mikenemat/skeeball-premium-re/hardware/docs/records/stock_passives/crops/02_ldo_U1_C6_C10.jpg

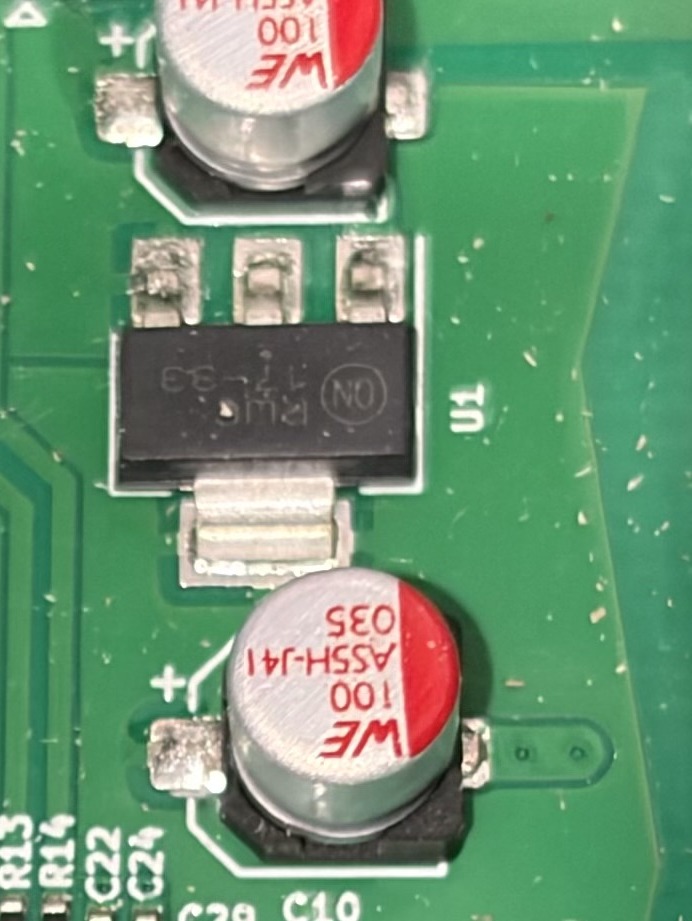
hardware/docs/records/stock_passives/crops/02_ldo_U1_C6_C10.jpg
