mikenemat/skeeball-premium-re/hardware/fab/release-2026-10-27c/README.md

# SBC-1 release package - 2026-10-27c (NOT ORDERED)

Supersedes release-2026-10-27b. **One change: D2 (FAULT red) = Hubei KENTO KT-0603R, LCSC C2286 (JLC basic)**, replacing
NationStar NCD0603R1 C84263, which JLC's assembly review flagged as Standard-PCBA-only ("limits in package (0201),
temperature ...") while this order is Economic PCBA. Same 0603 footprint, same nets; copper, silk and placement are
unchanged: every gerber / drill file is identical to release-b apart from its creation-date lines (diffed). The CPL
differs only in D2's Mid (0.0001 mm, C2286's origin), the BOM only in D2's line.

Board: `hardware/main/skeeball-controller.kicad_pcb` = q6 with D2's MPN / maker / LCSC / note fields updated (sha256
prefix 13729afbc822dc86 at the release export - re-check with `sha256sum`), 116.68 x 85.73 mm, 4 layers, **216
footprints** (208 JLC placements + H1-H4 + FID1-FID4). DRC (refilled zones + schematic parity): 0 errors, 0 unconnected
(the 43 warnings are the q6 set: library-copy and value-label parity notes). ERC 0, netlist compare 0.
`python scripts/bom.py check`: PASS (76 lines, 0 fail). Generated by
`python scripts/fab_release.py <board> fab/release-2026-10-27c` (gerbers / drills: kicad-cli; CPL: din-relay-8ch method).

| File | Use on jlcpcb.com |
|---|---|
| `sbc1-gerbers-drills-2026-10-27.zip` | "Add gerber file": F.Cu / In1.Cu / In2.Cu / B.Cu, mask, paste, silk, Edge.Cuts, PTH + NPTH Excellon (mm), drill maps, Gerber job file (records the JLC04161H-7628 stack) |
| `sbc1-jlc-bom.csv` | Assembly BOM (Comment, Designator, Footprint, LCSC Part #) |
| `sbc1-jlc-cpl.csv` | Assembly CPL (Designator, Mid X, Mid Y, Layer, Rotation), top side, **rotations corrected for JLC's LCSC footprints** |
| `sbc1-cpl-qa.txt` | One line per placement: LCSC footprint, KiCad orientation + fitted offset = CPL rotation, Mid shift, pad overlay result (pad number / function checked), polarity mark |
| `gerbers/` | the same files unzipped (for a viewer check) |

## Order settings

| Setting | Value |
|---|---|
| Base material / layers | FR-4, **4 layers** |
| Dimensions | 116.68 x 85.73 mm (from the outline) |
| PCB qty | 5 |
| Product type | Industrial / consumer (default) |
| Different design | 1 |
| Delivery format | **Single PCB** (no panel, no V-cut). See "Edge clearance" below: if JLC asks for rails, answer "assemble as a single board" - **order-time item for the owner** |
| PCB thickness | **1.6 mm** |
| Impedance control / layer stackup | **JLC04161H-7628** (1 oz outer = 35 um, 0.5 oz inner = 17.5 um; 7628 prepreg 0.2104 mm, core 1.065 mm) |
| PCB color | **Green** |
| Silkscreen | White |
| Surface finish | **ENIG** |
| Outer copper weight | 1 oz |
| Inner copper weight | 0.5 oz |
| Via covering | **Plugged** - the owner's live quote (2026-10-27) shows Tented greyed out for this build; no epoxy fill / capping (DECISIONS #9). Per JLC's via-covering page, holes in pads and vias closer than 0.35 mm to a pad are NOT ink-plugged: the EP thermal vias of U5 / U1 / U8 stay open (their paste is windowed between them), and many near-pad vias stay open too - expect an engineering question and accept it |
| Min via hole / diameter | 0.3 / 0.6 mm |
| Tooling holes | **Added by Customer** (the 4 corner holes H1-H4 + fiducials are in the files) |
| Remove order number | **Remove mark** (selected on the owner's quote; JLC may charge for it). No placeholder text is on the silk |
| PCB Assembly | **Yes, Economic PCBA**, assemble **Top side**, qty 5 |
| Tooling holes (PCBA) | Added by Customer |
| Confirm Parts Placement | **Yes** |
| Confirm Production File | **Yes** |

Order remark (paste into the PCBA remark field):
> J10 (C22464480, HRO TYPE-C-31-D-15) and J21-J28 (C588833, Molex 95503-2441) have no LCSC footprint: the CPL gives the
> body centre and rotation 0 - please confirm all 9 in the placement preview. J10's 4 shell legs go through the board
> (plated slots, 2 of them shared with the locating pegs): please solder them. Assemble as a single board (parts sit
> within 2.5 mm of the edges by design).
> D2 (C2286 KT-0603R): the LCSC library polarity dot marks the ANODE (pad 1, KENTO '+'); our cathode is the pad at the
> silk cathode bracket. Please confirm in placement preview.

## Placement notes for the JLC review

- **CPL rotations**: JLC places the LCSC / EasyEDA footprint of each C-number, rotated counter-clockwise by the CPL
  rotation about its origin. Every row was fitted and then overlaid exactly as JLC transforms it (`sbc1-cpl-qa.txt`):
  **199 PASS, 0 FAIL, 9 CONFIRM**. The check requires the SAME pad (its number, or for shells / mounting / tactile
  pairs a pad of the same net). Diode polarity is checked by pin NAMES: the LCSC symbol's anode pad must land on our
  anode net and its cathode pad on our cathode net (our A / K from the schematic netlist); the polarity dot is reported
  per D line, and decides only where the LCSC pins carry no A / K names (D1 SMBJ5.0A: dot on our cathode pad 1).
  `scripts/test_fab_polarity.py` shows the check FAILs a reversed diode (CPL + 180, board A / K swapped, LCSC names
  swapped) for C2286, C12624, C84268 and C83333.
- **LEDs**: D2 (red) = Hubei KENTO KT-0603R C2286 (basic), D4 (yellow) = NationStar NCD0603Y1 C84268, D3 / D5 (green) =
  KENTO KT-0603G C12624. All pass by pin names. **D2's LCSC dot marks the ANODE**: C2286's LCSC pad 1 is named A (KENTO's
  drawing: pad 1 = '+') and carries the layer-101 dot; CPL rotation 0 puts LCSC pad 1 (A) on our pad 2 (LED_FAULT_A,
  x 104.79) and LCSC pad 2 (K) on our pad 1 (PWR_FAULT_N, x 103.21, the end with the silk cathode bracket). So in JLC's
  preview D2's dot sits on the end AWAY from our silk bracket - correct for this part (order remark above). For C84268
  and C12624 the dot marks the cathode and lands on our pad 1 (bracket end).
  D2 changed from NationStar NCD0603R1 C84263 (release-b) because JLC offers that part for Standard PCBA only.
- **J10 (HRO TYPE-C-31-D-15, C22464480)**: no LCSC footprint exists (EasyEDA API 404), so the footprint is drawn from
  HRO's 2023-10-27 drawing (`datasheets/dl/j10/C22464480.pdf`), rotated so the A row (A1 left) faces the board's top
  edge like the part it replaced. Its 4 shell legs (2.20 mm) pass through the 1.6 mm board in plated slots; at the two
  diagonal corners the slot also takes the dia 0.70 locating peg (the drawing leaves only a 0.135 mm web between slot
  and peg hole, which no copper ring survives).
- **J21-J28 (C588833)**: no LCSC footprint; CPL Mid = the jack body (courtyard) centre, not the KiCad origin on the
  peg line; plug opening toward the board's bottom edge (the stock orientation).
- **J9 (micro-B)**: its shell slots carry paste from the overlapping SMD shell pads (pin-in-paste, as drawn by
  Amphenol / KiCad) - keep it.
- THT connectors (J1, J4, J5, J6, J7, J8, J21-J28; the J9 / J10 shells) are JLC-placed too (one order = the full
  board).

## Edge clearance (order-time item)

JLC's assembly terms ask for component bodies >= 2.5 mm from the edge. On this board the harness connectors sit at the
stock positions (fixed by the cabinet harness) and overhang or touch the edges: J1 / J4 / J8 / J9 overhang the top /
right / left edges, J6 / J7 / J21-J28 are within 0.6 mm, SW1 / SW2 1.35 mm. Standard edge rails would be blocked by the
overhangs. If JLC asks for rails or a fixture, answer by asking them to assemble it as a single board.

## Not in this package

No order has been placed. No owner decisions are open: O1 and O2 accepted, O3 closed (DECISIONS #20-#22). The package
is ready to order.
