mikenemat/skeeball-premium-re/software/RESUME.md

# Working on the public tools

Read AGENTS.md and README.md. Check the current Git diff before making changes.
Keep task-specific handoffs and local workspace details out of public documents.
