mikenemat/skeeball-premium-re/hardware/docs/records/stock_passives/crops/01_flash_bootsel_R5_R11_C7.jpg

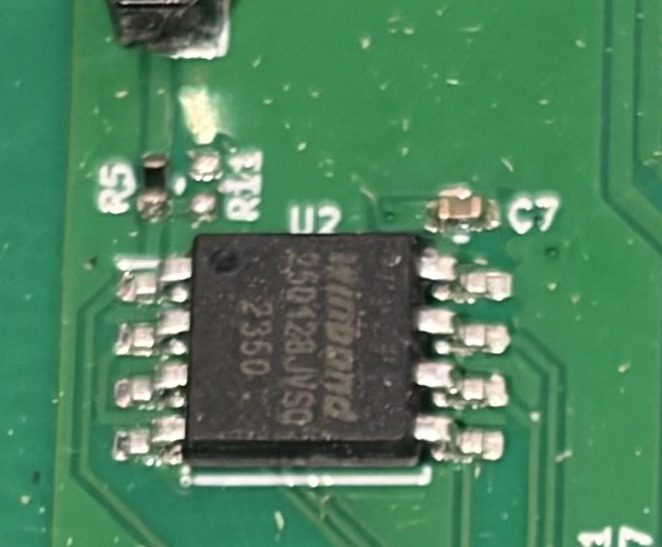
hardware/docs/records/stock_passives/crops/01_flash_bootsel_R5_R11_C7.jpg
