mikenemat/skeeball-premium-re/hardware/docs/records/stock_passives/crops/03_mcu_top_C21-C30_R13_R14.jpg

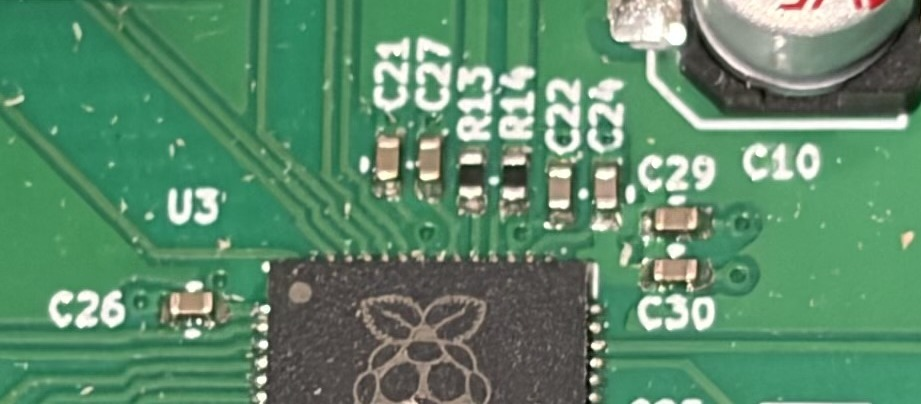
hardware/docs/records/stock_passives/crops/03_mcu_top_C21-C30_R13_R14.jpg
