mikenemat/skeeball-premium-re/hardware/docs/records/stock_passives/crops/04_mcu_bottom_R12_C28_C20_R10_C1_C5.jpg

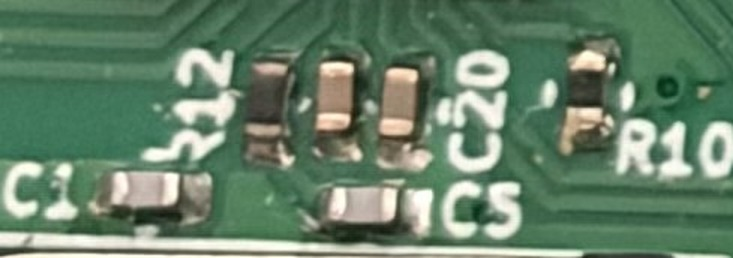
hardware/docs/records/stock_passives/crops/04_mcu_bottom_R12_C28_C20_R10_C1_C5.jpg
