mikenemat/skeeball-premium-re/hardware/docs/records/stock_passives/crops/05_status_D2_R15_C25.jpg

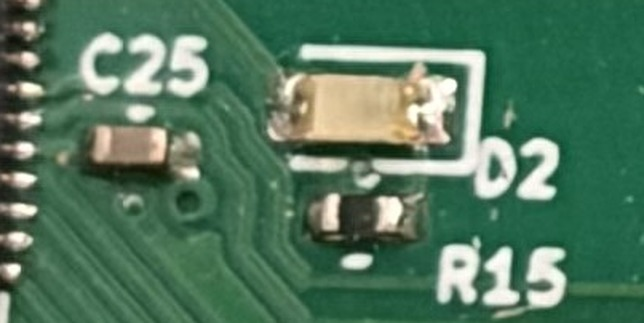
hardware/docs/records/stock_passives/crops/05_status_D2_R15_C25.jpg
