mikenemat/skeeball-premium-re/hardware/docs/records/stock_passives/crops/06_audio_input_R16-R19_C33-C35.jpg

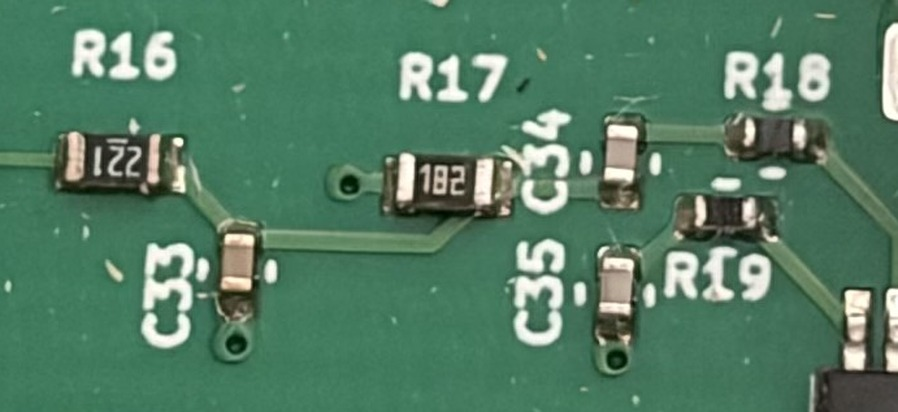
hardware/docs/records/stock_passives/crops/06_audio_input_R16-R19_C33-C35.jpg
