mikenemat/skeeball-premium-re/hardware/docs/records/stock_passives/crops/07_R16_marking.jpg

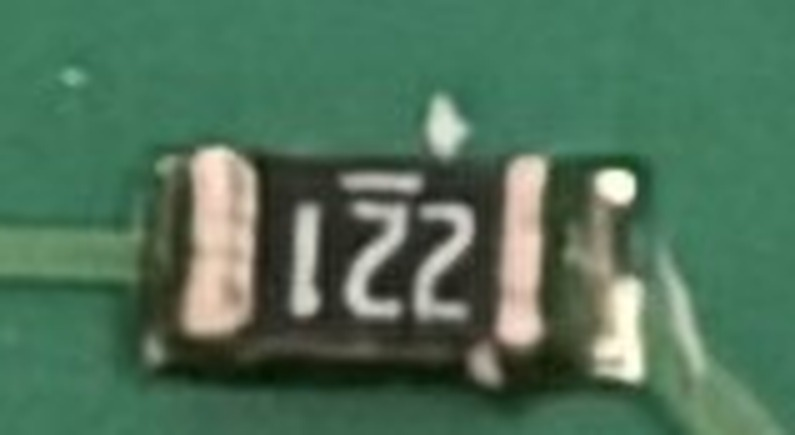
hardware/docs/records/stock_passives/crops/07_R16_marking.jpg
