mikenemat/skeeball-premium-re/hardware/docs/records/stock_passives/crops/08_audio_amp_U4_R20_C32_FB_C36_C37.jpg

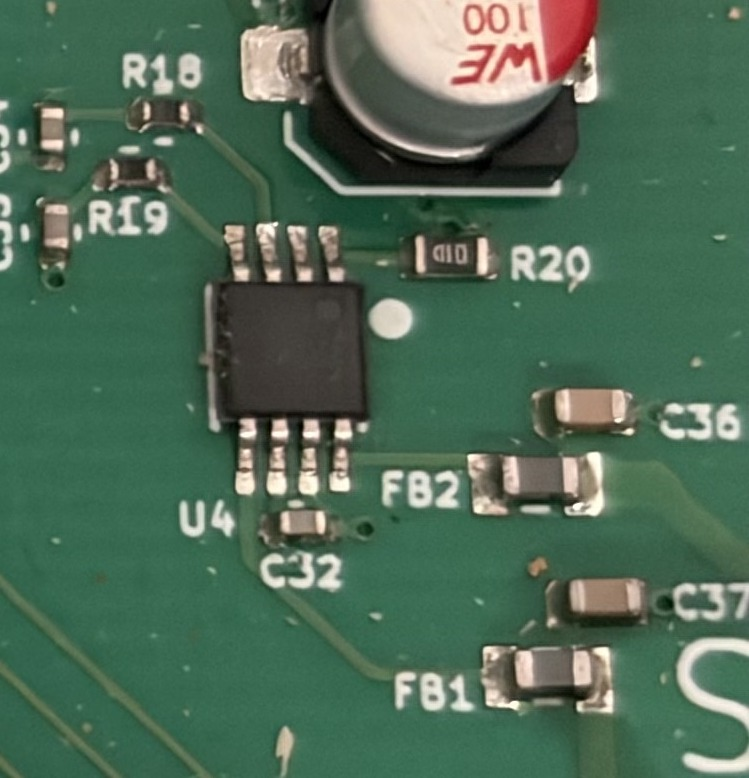
hardware/docs/records/stock_passives/crops/08_audio_amp_U4_R20_C32_FB_C36_C37.jpg
