mikenemat/skeeball-premium-re/hardware/docs/records/stock_passives/crops/09_light_fets_R1-R9.jpg

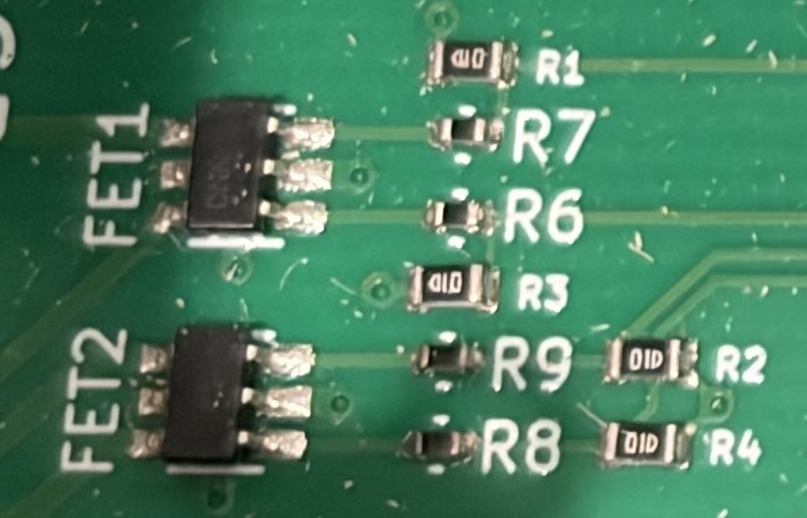
hardware/docs/records/stock_passives/crops/09_light_fets_R1-R9.jpg
