mikenemat/skeeball-premium-re/hardware/docs/records/stock_passives/crops/10_button_caps_C2_C8_C15_C19.jpg

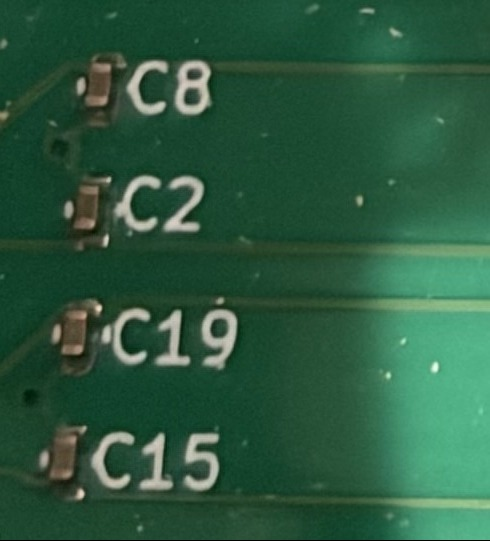
hardware/docs/records/stock_passives/crops/10_button_caps_C2_C8_C15_C19.jpg
