mikenemat/skeeball-premium-re/hardware/docs/records/stock_passives/crops/11_score_caps_J11.jpg

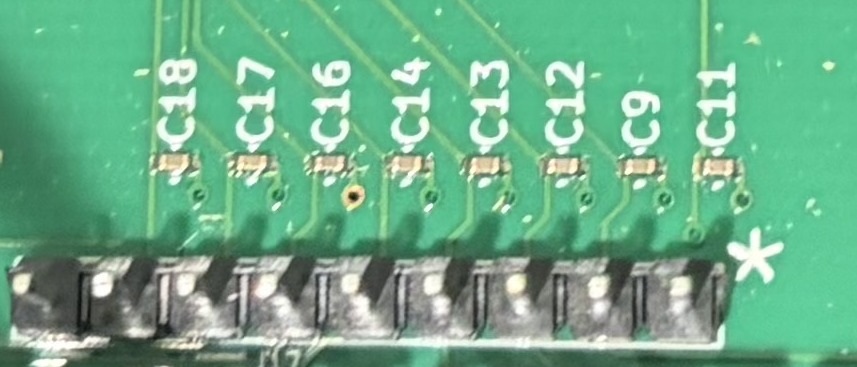
hardware/docs/records/stock_passives/crops/11_score_caps_J11.jpg
