mikenemat/skeeball-premium-re/hardware/docs/records/stock_passives/crops/12_jbutton_caps_C38-C42.jpg

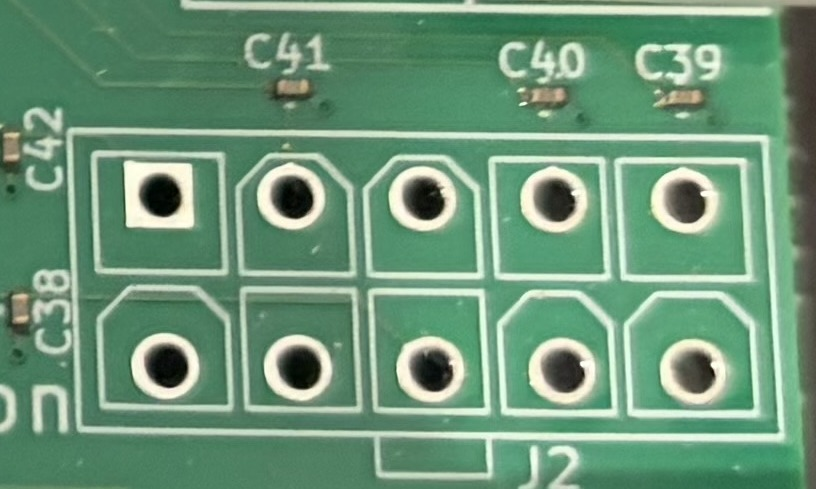
hardware/docs/records/stock_passives/crops/12_jbutton_caps_C38-C42.jpg
