mikenemat/skeeball-premium-re/hardware/docs/records/stock_passives/crops/13_J18_C6.jpg

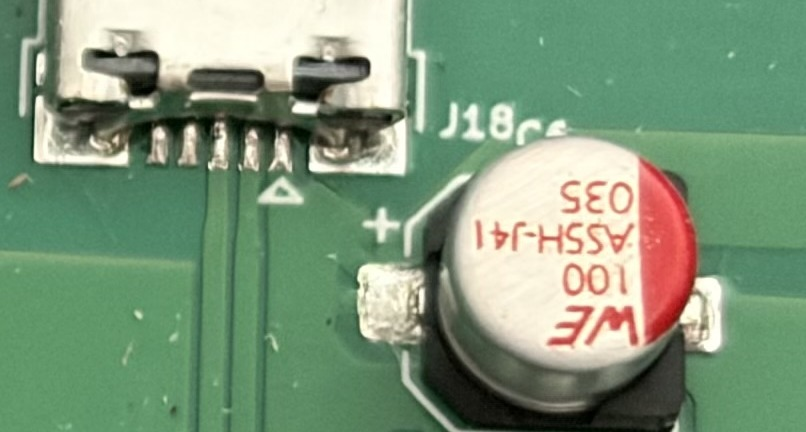
hardware/docs/records/stock_passives/crops/13_J18_C6.jpg
