mikenemat/skeeball-premium-re/hardware/docs/records/stock_passives/crops/14_C31_label.jpg

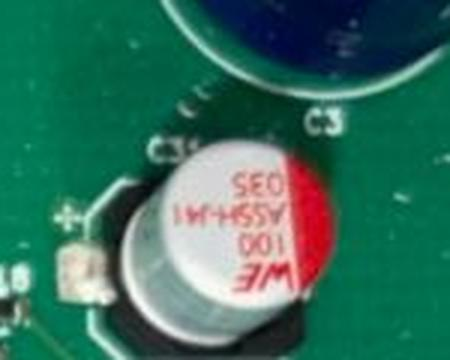
hardware/docs/records/stock_passives/crops/14_C31_label.jpg
