mikenemat/skeeball-premium-re/hardware/docs/records/stock_passives/crops/15_power_c3_c4.jpg

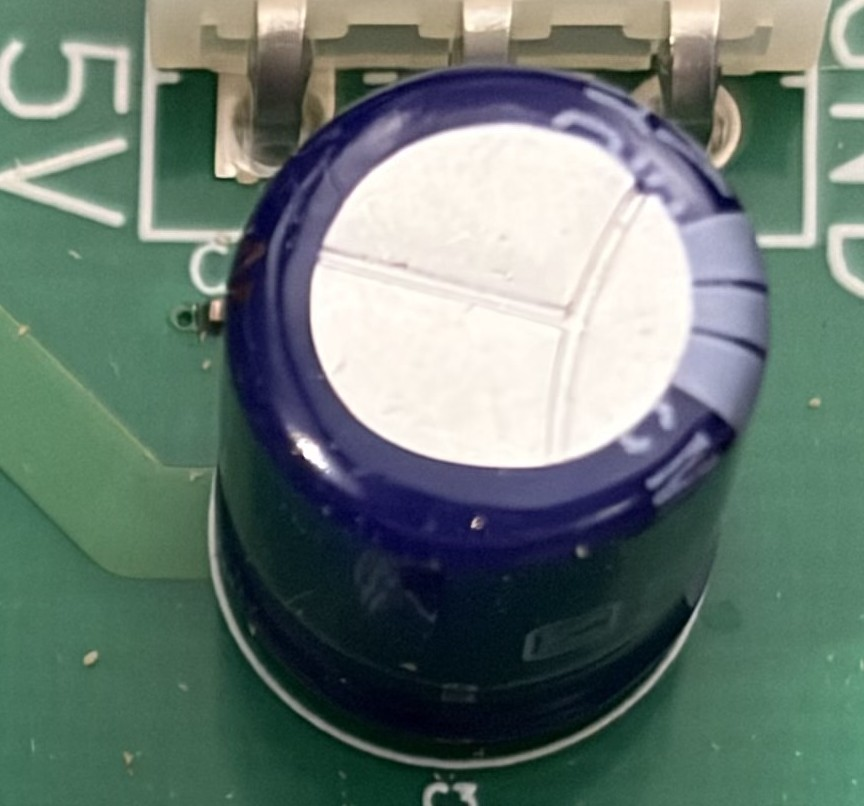
hardware/docs/records/stock_passives/crops/15_power_c3_c4.jpg
