mikenemat/skeeball-premium-re/hardware/renders/footprints/contact_sheet.png

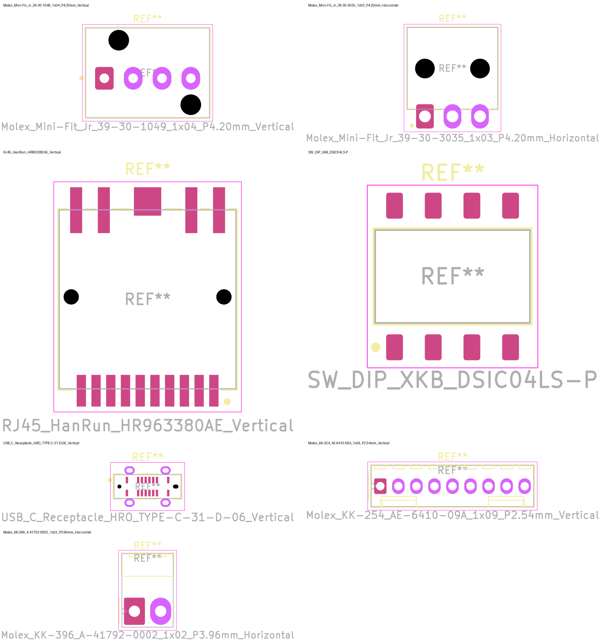
hardware/renders/footprints/contact_sheet.png
