mikenemat/skeeball-premium-re/hardware/renders/footprints/Molex_KK-254_AE-6410-09A_1x09_P2.54mm_Vertical.png

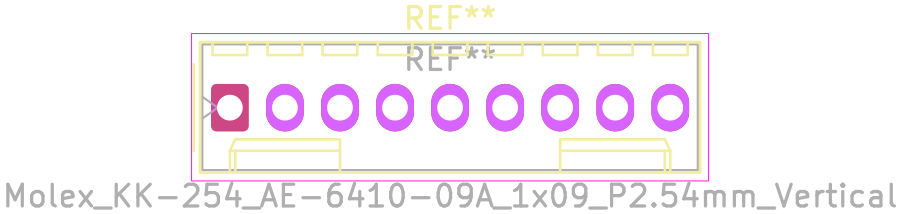
hardware/renders/footprints/Molex_KK-254_AE-6410-09A_1x09_P2.54mm_Vertical.png
