mikenemat/skeeball-premium-re/hardware/renders/footprints/Molex_KK-396_A-41792-0002_1x02_P3.96mm_Horizontal.png

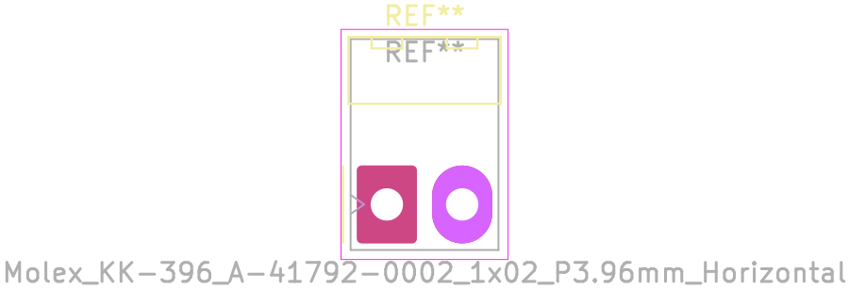
hardware/renders/footprints/Molex_KK-396_A-41792-0002_1x02_P3.96mm_Horizontal.png
