mikenemat/skeeball-premium-re/hardware/renders/footprints/Molex_Mini-Fit_Jr_39-30-1049_1x04_P4.20mm_Vertical.png

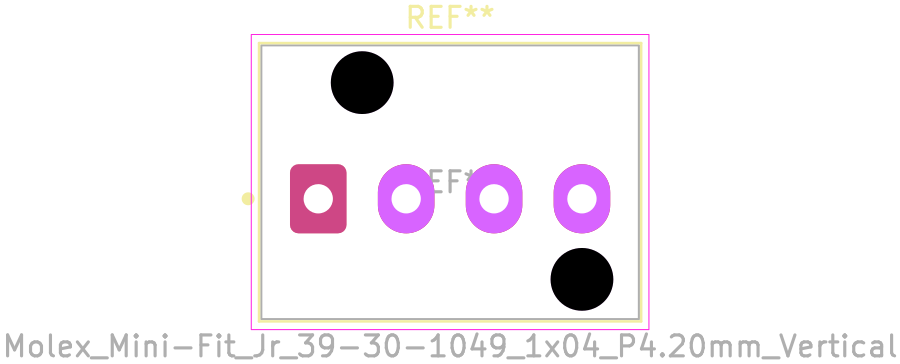
hardware/renders/footprints/Molex_Mini-Fit_Jr_39-30-1049_1x04_P4.20mm_Vertical.png
