mikenemat/skeeball-premium-re/hardware/renders/footprints/Molex_Mini-Fit_Jr_39-30-3035_1x03_P4.20mm_Horizontal.png

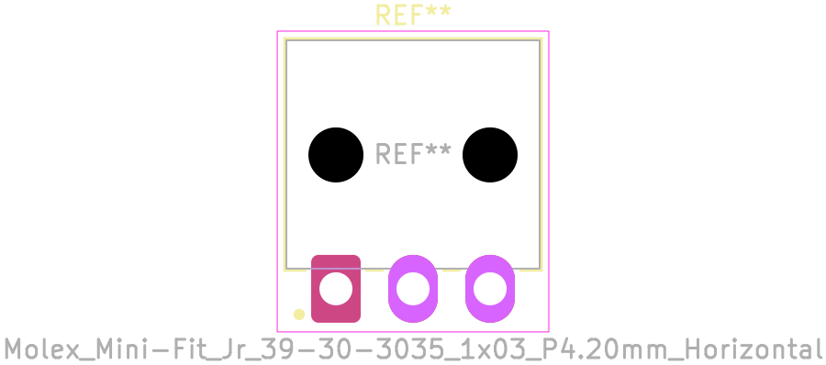
hardware/renders/footprints/Molex_Mini-Fit_Jr_39-30-3035_1x03_P4.20mm_Horizontal.png
