mikenemat/skeeball-premium-re/hardware/renders/footprints/RJ45_HanRun_HR963380AE_Vertical.png

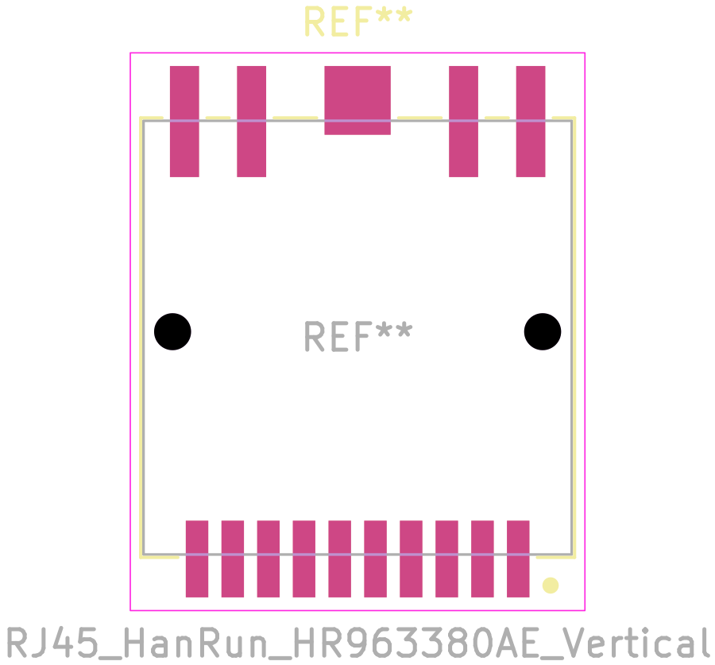
hardware/renders/footprints/RJ45_HanRun_HR963380AE_Vertical.png
