mikenemat/skeeball-premium-re/hardware/renders/footprints/SW_DIP_XKB_DSIC04LS-P.png

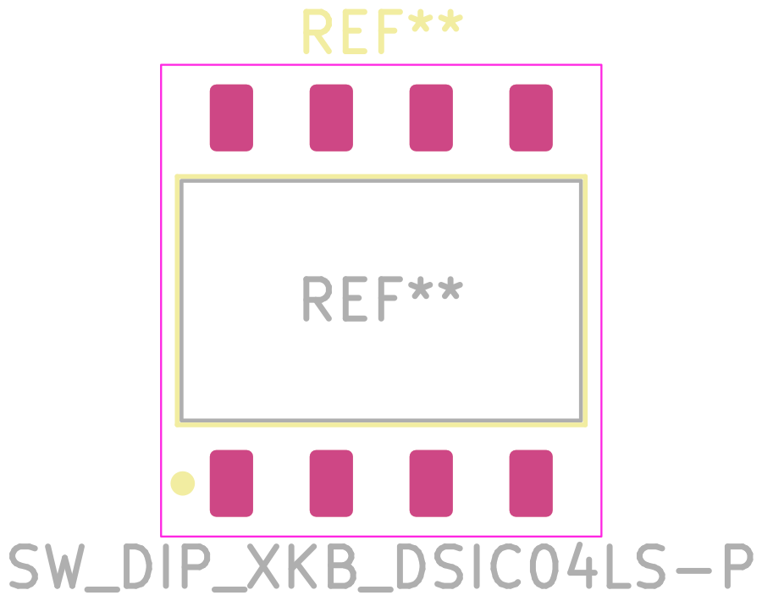
hardware/renders/footprints/SW_DIP_XKB_DSIC04LS-P.png
