mikenemat/skeeball-premium-re/hardware/renders/footprints/USB_C_Receptacle_HRO_TYPE-C-31-D-06_Vertical.png

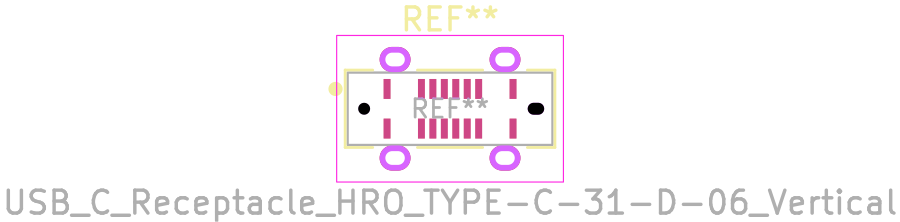
hardware/renders/footprints/USB_C_Receptacle_HRO_TYPE-C-31-D-06_Vertical.png
