mikenemat/skeeball-premium-re/hardware/renders/pcb/final-2026-10-27b/sbc1-final-layer-F_Cu.png

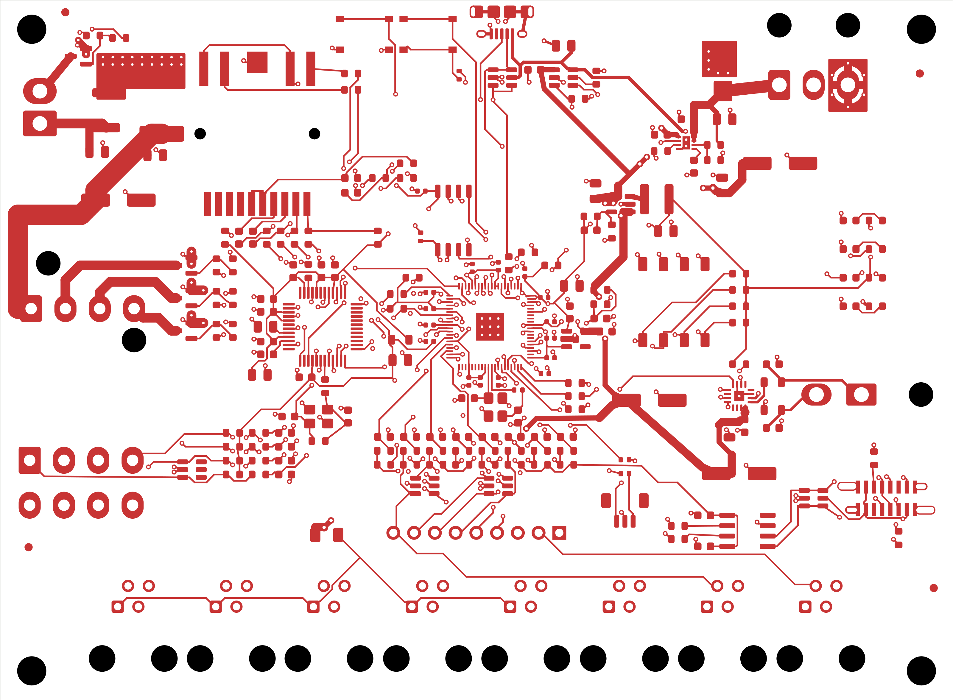
hardware/renders/pcb/final-2026-10-27b/sbc1-final-layer-F_Cu.png
