mikenemat/skeeball-premium-re/hardware/renders/pcb/final-2026-10-27b/sbc1-final-side-left-edge.png

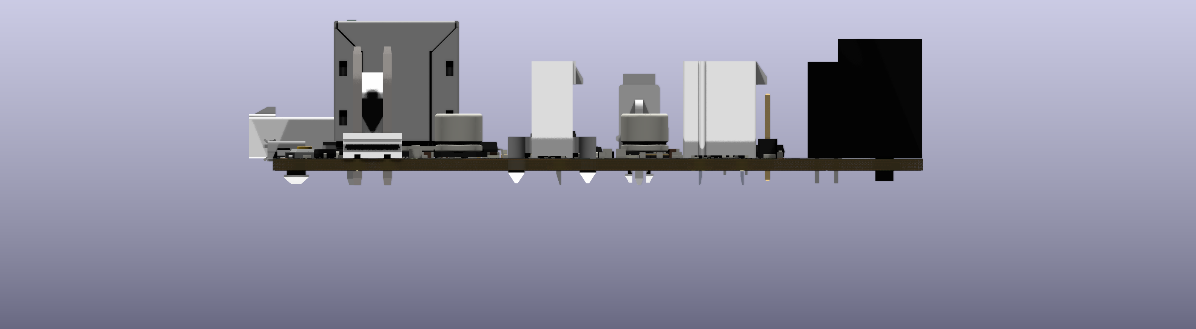
hardware/renders/pcb/final-2026-10-27b/sbc1-final-side-left-edge.png
