mikenemat/skeeball-premium-re/hardware/renders/placement/placement_plan.png

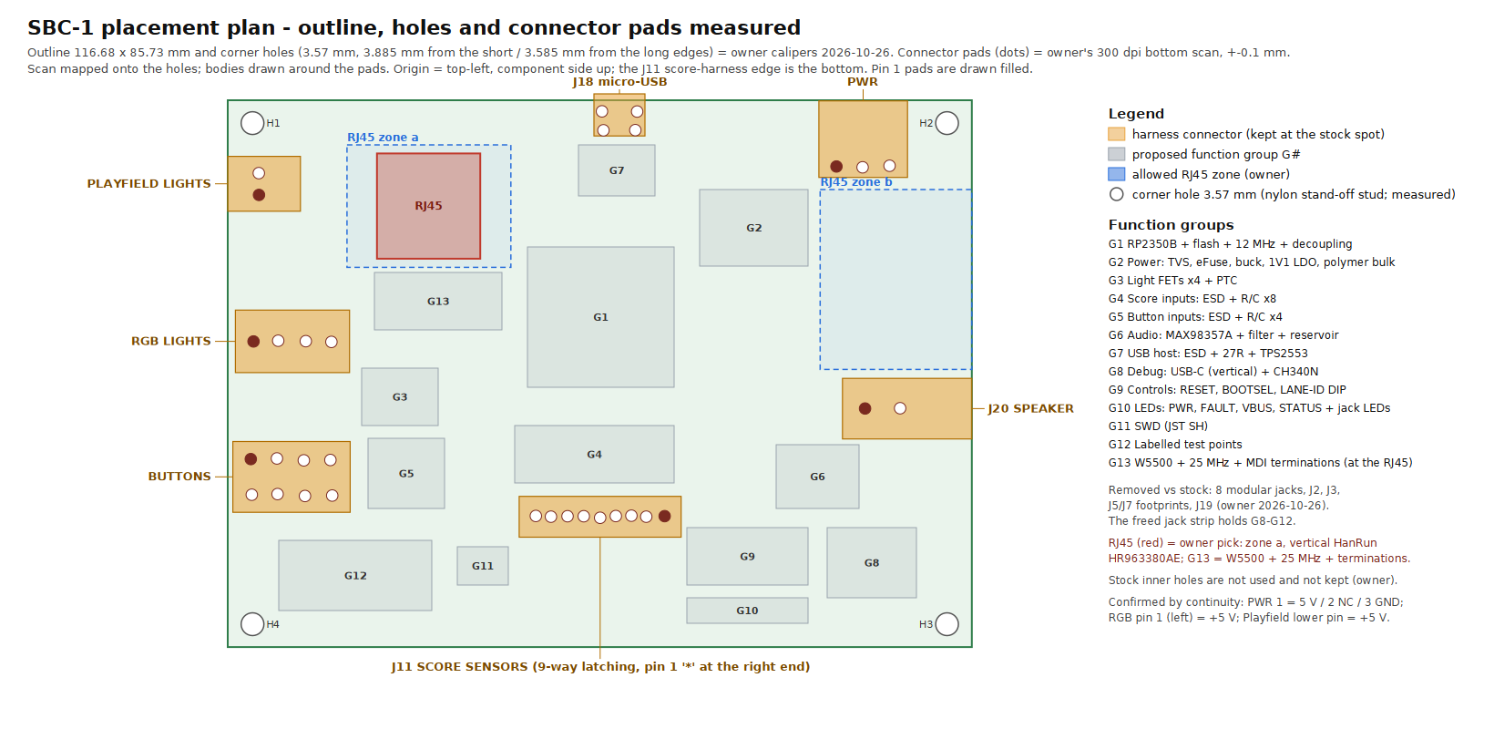
hardware/renders/placement/placement_plan.png
