mikenemat/skeeball-premium-re/hardware/renders/placement/rj45_zone_study.png

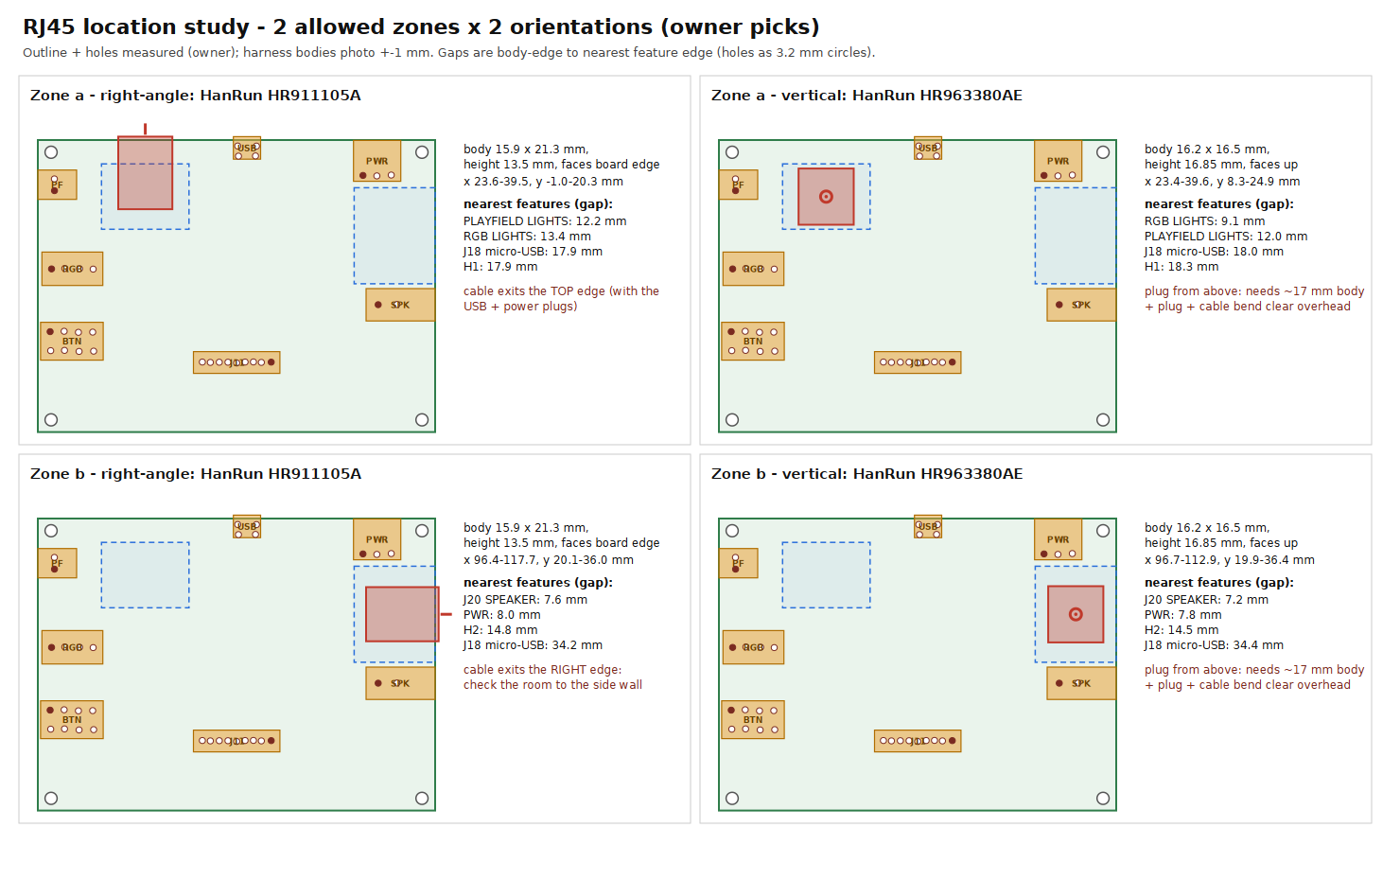
hardware/renders/placement/rj45_zone_study.png
