mikenemat/skeeball-premium-re/hardware/docs/ORDERING.md

# ORDERING - generated by `python scripts/bom.py report` (do not edit)

Data: bom/bom.json updated 2026-10-27T20:24:26Z (JLC parts-library API = live part-page data).
Run: 5 boards (4 machines + 1 spare).

## Cost per board (parts at the JLC assembly price for the run quantity)

| Item | USD / board |
|---|---:|
| Placed parts (all non-harness lines) | 19.95 |
| Harness connectors (genuine Molex at the stock-board locations) | 11.22 |
| JLC extended-part fees: 34 lines x $3 / order, spread over 5 boards | 20.40 |
| **Parts total (one JLC order = the full board)** | **51.57** |

PCB + assembly service (2-layer 1.6 mm, ~109 x 85 mm, 5 pcs, single-sided assembly) is quoted at order time on jlcpcb.com; not included above.

The JLC assembly order covers every line below (SMT + the through-hole harness headers); nothing is owner-fitted.

## Lines

| Refs | Qty/board | Value | MPN | Maker | LCSC | JLC library | JLC stock | Unit USD (JLC) | Checked (UTC) | Status | Notes |
|---|---|---|---|---|---|---|---|---|---|---|---|
| C47, C51 | 2 | 10nF | 0603B103K500NT | FH | C57112 | basic | 5972499 | 0.0047 | 2026-10-27 | OK |  |
| C52, C53 | 2 | 6.8nF | 0603B682K500NT | FH | C1631 | basic | 364930 | 0.0055 | 2026-10-27 | OK |  |
| C4, C9, C15, C17, C37, C38, C39, C40, C41, C42, C45, C55, C72, C73 | 14 | 100nF | CC0603KRX7R9BB104 | YAGEO | C14663 | basic | 42860043 | 0.0149 | 2026-10-27 | OK |  |
| C31, C32 | 2 | 4.7uF | CL05A475MP5NRNC | Samsung | C23733 | basic | 2606160 | 0.0153 | 2026-10-27 | OK |  |
| C18, C19, C20, C21, C22, C23, C24, C25, C26, C27, C28, C29, C30, C34 | 14 | 100nF | CL05B104KO5NNNC | Samsung | C1525 | basic | 34906725 | 0.0035 | 2026-10-27 | OK |  |
| C13, C14 | 2 | 1uF | CL10A105KB8NNNC | Samsung | C15849 | basic | 13334380 | 0.0146 | 2026-10-27 | OK |  |
| C58, C59, C60, C61, C62, C63, C64, C65, C66, C67, C68, C69, C70, C71 | 14 | 1nF | CL10B102KB8NNNC | Samsung | C1588 | basic | 5502112 | 0.0098 | 2026-10-27 | OK |  |
| C50 | 1 | 22nF | CL10B223KB8NNNC | Samsung | C21122 | basic | 1077610 | 0.0057 | 2026-10-27 | OK |  |
| C6 | 1 | 47nF | CL10B473KB8NNNC | Samsung | C1622 | basic | 974968 | 0.0077 | 2026-10-27 | OK |  |
| C12, C35, C36 | 3 | 15pF C0G | CL10C150JB8NNNC | Samsung | C1644 | basic | 1119169 | 0.0111 | 2026-10-27 | OK |  |
| C48, C49 | 2 | 18pF C0G | CL10C180JB8NNNC | Samsung | C1647 | basic | 271473 | 0.0158 | 2026-10-27 | OK |  |
| C2, C3, C5, C11, C33, C43, C44, C54 | 8 | 10uF | CL21A106KAYNNNE | Samsung | C15850 | basic | 8948721 | 0.0438 | 2026-10-27 | OK |  |
| C8, C16 | 2 | 22uF | CL21A226MAQNNNE | Samsung | C45783 | basic | 4118242 | 0.1917 | 2026-10-27 | OK |  |
| C10, C46 | 2 | 4.7uF | CL21A475KAQNNNE | Samsung | C1779 | basic | 1980619 | 0.0343 | 2026-10-27 | OK |  |
| C1, C7, C56, C57 | 4 | 220uF polymer | OVZ221M1ATR-0606 | Lelon | C311623 | extended | 15012 | 0.2063 | 2026-10-27 | OK |  |
| D3, D5 | 2 | PWR green | KT-0603G | Hubei KENTO | C12624 | extended | 443493 | 0.0117 | 2026-10-27 | OK |  |
| D2 | 1 | FAULT red | KT-0603R | Hubei KENTO | C2286 | basic | 7642560 | 0.0077 | 2026-10-27 | OK |  |
| D4 | 1 | VBUS yellow | NCD0603Y1 | NationStar | C84268 | extended | 306447 | 0.0112 | 2026-10-27 | OK |  |
| D1 | 1 | SMBJ5.0A | SMBJ5.0A | Littelfuse | C83333 | extended | 37387 | 0.1156 | 2026-10-27 | OK |  |
| F2 | 1 | 3A hold | 1812L300MR | Littelfuse | C127824 | extended | 3798 | 0.1366 | 2026-10-27 | OK |  |
| F1 | 1 | 5A hold | 2920L500/16MR | Littelfuse | C207091 | extended | 2614 | 0.3788 | 2026-10-27 | OK |  |
| FB2, FB3 | 2 | BLM21PG221SN1D | BLM21PG221SN1D | Murata | C85840 | extended | 591700 | 0.0346 | 2026-10-27 | OK |  |
| FB1 | 1 | 600R@100MHz | GZ2012D601TF | Sunlord | C1017 | basic | 577061 | 0.02 | 2026-10-27 | OK |  |
| F3 | 1 | 0.5A hold | MF-NSMF050-2 | Bourns | C75464 | extended | 72093 | 0.0591 | 2026-10-27 | OK |  |
| J9 | 1 | DISPLAY USB | 10118194-0001LF | Amphenol ICC | C132563 | extended | 41020 | 0.2585 | 2026-10-27 | OK | harness |
| J8 | 1 | PLAYFIELD LIGHTS | 26604020 | Molex | C505042 | extended | 24726 | 0.1605 | 2026-10-27 | OK | harness |
| J6 | 1 | BUTTONS | 39281083 | Molex | C293503 | extended | 4243 | 0.402 | 2026-10-27 | OK | harness |
| J4 | 1 | SPEAKER | 39300020 | Molex | C240831 | extended | 298 | 0.604 | 2026-10-27 | OK | harness |
| J7 | 1 | RGB LIGHTS | 39301049 | Molex | C587488 | extended | 4042 | 0.3192 | 2026-10-27 | OK | harness |
| J1 | 1 | PWR 5V/GND | 39303035 | Molex | C505179 | extended | 11634 | 0.5369 | 2026-10-27 | OK | harness |
| J21, J22, J23, J24, J25, J26, J27, J28 | 8 | SCORE 0 | 955032441 | Molex | C588833 | extended | 649 | 1.1114 | 2026-10-27 | OK | harness |
| J2 | 1 | SWD | BM03B-SRSS-TB(LF)(SN) | JST | C160389 | extended | 27324 | 0.2762 | 2026-10-27 | OK |  |
| J5 | 1 | SCORE SENSORS | HC-PZ254-11.5L-1x9PZ | Hong Cheng | C27985193 | extended | 2390 | 0.0433 | 2026-10-27 | OK | harness |
| J3 | 1 | HR963380AE | HR963380AE | HanRun | C19724763 | extended | 154 | 2.7252 | 2026-10-27 | OK |  |
| J10 | 1 | DEBUG USB-C | TYPE-C-31-D-15 | Korean Hroparts | C22464480 | extended | 469 | 0.6531 | 2026-10-27 | OK |  |
| L1 | 1 | 2.2uH | SWPA4030S2R2MT | Sunlord | C36409 | extended | 34358 | 0.0583 | 2026-10-27 | OK |  |
| Q1, Q2, Q3, Q4 | 4 | AO3416 | AO3416 | Alpha & Omega | C43307 | extended | 48177 | 0.1091 | 2026-10-27 | OK |  |
| R15, R16 | 2 | 100 | 0402WGF1000TCE | UNI-ROYAL | C25076 | basic | 7105177 | 0.0012 | 2026-10-27 | OK |  |
| R12, R13, R14 | 3 | 1k | 0402WGF1001TCE | UNI-ROYAL | C11702 | basic | 19064680 | 0.0013 | 2026-10-27 | OK |  |
| R25, R27, R28, R29, R30 | 5 | 0 | 0603WAF0000T5E | UNI-ROYAL | C21189 | basic | 22071302 | 0.0022 | 2026-10-27 | OK |  |
| R66, R68, R70, R72, R78, R79 | 6 | 100 | 0603WAF1000T5E | UNI-ROYAL | C22775 | basic | 10427539 | 0.0023 | 2026-10-27 | OK |  |
| R4, R10 | 2 | 1k | 0603WAF1001T5E | UNI-ROYAL | C21190 | basic | 34230068 | 0.0017 | 2026-10-27 | OK |  |
| R18, R19, R20, R21, R23, R81, R82 | 7 | 10k | 0603WAF1002T5E | UNI-ROYAL | C25804 | basic | 38841065 | 0.0017 | 2026-10-27 | OK |  |
| R1, R5, R8 | 3 | 100k | 0603WAF1003T5E | UNI-ROYAL | C25803 | basic | 17660400 | 0.0031 | 2026-10-27 | OK |  |
| R26 | 1 | 1M | 0603WAF1004T5E | UNI-ROYAL | C22935 | basic | 5584345 | 0.0018 | 2026-10-27 | OK |  |
| R33 | 1 | 10 | 0603WAF100JT5E | UNI-ROYAL | C22859 | basic | 6801213 | 0.0032 | 2026-10-27 | OK |  |
| R22 | 1 | 12.4k | 0603WAF1242T5E | UNI-ROYAL | C22865 | extended | 183987 | 0.0015 | 2026-10-27 | OK |  |
| R11 | 1 | 1.5k | 0603WAF1501T5E | UNI-ROYAL | C22843 | basic | 3838230 | 0.002 | 2026-10-27 | OK |  |
| R42, R44, R46, R48, R50, R52, R54, R56, R58, R60, R62, R64 | 12 | 2.2k | 0603WAF2201T5E | UNI-ROYAL | C4190 | basic | 5955416 | 0.0018 | 2026-10-27 | OK |  |
| R6 | 1 | 22k | 0603WAF2202T5E | UNI-ROYAL | C31850 | basic | 3147116 | 0.0042 | 2026-10-27 | OK |  |
| R74, R75 | 2 | 27 | 0603WAF270JT5E | UNI-ROYAL | C25190 | preferred | 407953 | 0.0016 | 2026-10-27 | OK |  |
| R36, R37 | 2 | 330 | 0603WAF3300T5E | UNI-ROYAL | C23138 | basic | 3725238 | 0.002 | 2026-10-27 | OK |  |
| R24, R39, R40, R41 | 4 | 33 | 0603WAF330JT5E | UNI-ROYAL | C23140 | basic | 4510286 | 0.0024 | 2026-10-27 | OK |  |
| R17 | 1 | 470 | 0603WAF4700T5E | UNI-ROYAL | C23179 | basic | 4990526 | 0.0023 | 2026-10-27 | OK |  |
| R43, R45, R47, R49, R51, R53, R55, R57, R59, R61, R63, R65, R67, R69, R71, R73, R80 | 17 | 4.7k | 0603WAF4701T5E | UNI-ROYAL | C23162 | basic | 16608030 | 0.0028 | 2026-10-27 | OK |  |
| R2, R9 | 2 | 47k | 0603WAF4702T5E | UNI-ROYAL | C25819 | basic | 3388230 | 0.0035 | 2026-10-27 | OK |  |
| R7 | 1 | 49.9k | 0603WAF4992T5E | UNI-ROYAL | C23184 | basic | 1592716 | 0.0029 | 2026-10-27 | OK |  |
| R31, R32, R34, R35 | 4 | 49.9 | 0603WAF499JT5E | UNI-ROYAL | C23185 | basic | 1633061 | 0.0021 | 2026-10-27 | OK |  |
| R76, R77 | 2 | 5.1k | 0603WAF5101T5E | UNI-ROYAL | C23186 | basic | 21976225 | 0.0015 | 2026-10-27 | OK |  |
| R38 | 1 | 510k | 0603WAF5103T5E | UNI-ROYAL | C23192 | basic | 950956 | 0.002 | 2026-10-27 | OK |  |
| R3 | 1 | 680 | 0603WAF6800T5E | UNI-ROYAL | C23228 | basic | 1992590 | 0.0021 | 2026-10-27 | OK |  |
| SW3 | 1 | LANE ID | DSIC04LS-P | XKB Connection | C319038 | extended | 6316 | 0.6367 | 2026-10-27 | OK |  |
| SW1, SW2 | 2 | BOOTSEL | TS-1187A-B-A-B | XKB Connection | C318884 | basic | 1187372 | 0.0207 | 2026-10-27 | OK |  |
| U14 | 1 | CH340N | CH340N | WCH | C2977777 | extended | 24904 | 0.5909 | 2026-10-27 | OK |  |
| U9, U10, U11 | 3 | ESDA6V1-5SC6 | ESDA6V1-5SC6 | STMicroelectronics | C6650 | extended | 2981 | 0.2115 | 2026-10-27 | OK |  |
| U8 | 1 | MAX98357AETE+T | MAX98357AETE+T | Analog Devices | C910544 | extended | 33473 | 1.3242 | 2026-10-27 | OK |  |
| U5 | 1 | RP2350B | RP2350B | Raspberry Pi | C42415655 | extended | 3477 | 1.2833 | 2026-10-27 | OK |  |
| U2 | 1 | TLV62569DBVR | TLV62569DBVR | Texas Instruments | C141836 | extended | 432314 | 0.0708 | 2026-10-27 | OK |  |
| U3 | 1 | TLV74311PDBVR | TLV74311PDBVR | Texas Instruments | C485147 | extended | 10298 | 0.0935 | 2026-10-27 | OK |  |
| U4 | 1 | TPS2553DBVR | TPS2553DBVR | Texas Instruments | C55266 | extended | 49261 | 0.5418 | 2026-10-27 | OK |  |
| U1 | 1 | TPS259531DSGR | TPS259531DSGR | Texas Instruments | C2155674 | extended | 2161 | 0.8773 | 2026-10-27 | OK |  |
| U12, U13 | 2 | USBLC6-2SC6 | USBLC6-2SC6 | STMicroelectronics | C7519 | extended | 37197 | 0.1797 | 2026-10-27 | OK |  |
| U6 | 1 | W25Q128JVSIQ | W25Q128JVSIQ | Winbond | C97521 | basic | 58346 | 2.5828 | 2026-10-27 | OK |  |
| U7 | 1 | W5500 | W5500 | WIZnet | C32843 | extended | 23251 | 2.83 | 2026-10-27 | OK |  |
| Y1 | 1 | 12MHz | ABM8-272-T3 | Abracon | C20625731 | extended | 2735 | 0.658 | 2026-10-27 | OK |  |
| Y2 | 1 | 25MHz | X322525MOB4SI | YXC | C9006 | basic | 240479 | 0.0951 | 2026-10-27 | OK |  |

Status: OK = JLC stock >= 2 x (run need + attrition) and >= 100; THIN = enough for this run but below that margin; TBD = harness part waiting for the owner's connector identification.

## Basic-library swaps (cost pass, owner 2026-10-26)

JLC charges the extended-part fee per unique extended line and order; 'preferred' extended parts are listed by JLC as fee-exempt (re-check on the quote screen). Lines swapped, with the reason it is a drop-in:

| Line | Was | Now | Why a drop-in |
|---|---|---|---|
| FB1 W5500 3V3A bead | Murata BLM18PG221SN1D 220 R 0603 (extended) | Sunlord GZ2012D601TF 600 R 0805 (basic, C1017) | WIZnet note g: 100-2000 R at 100 MHz is adequate; 500 mA rating vs 132 mA load |
| R37 MAX98357A SD_MODE pull-up | 634 k 0603 (extended) | 510 k 0603WAF5103T5E (basic, C23192) | VSD_MODE 0.49-0.60 V: centred in the B0 max 0.355 V .. B1 typ 0.77 V (L+R)/2 window with the internal 100 k +-8 % (q6 2026-10-27; the cost pass's 680 k left 30 mV to B0 max) |
| R73 / R74 USB host 27 R | 0402WGF270JTCE (extended) | 0603WAF270JT5E (preferred, C25190) | same value; 0603 footprint instead of 0402 |

Extended lines kept, and why:

| Line(s) | Reason |
|---|---|
| OVZ221M1ATR-0606 220 uF polymer x4 | no polymer capacitor in the JLC basic library (owner: no aluminium electrolytics) |
| KT-0603G green LED x2 | no green 0603 LED in basic (red / yellow 0603 are); owner asked for 0603 |
| NCD0603Y1 yellow LED | chosen in the q6 pass (mfg review M1) over the basic KT-0603Y, whose LCSC dot marks the anode; kept because JLC's assembly review did not flag it (D2 red went back to the basic KT-0603R C2286 on 2026-10-27: NCD0603R1 is Standard-PCBA-only) |
| SMBJ5.0A TVS, 1812L300MR + 2920L500/16MR polyfuses, SWPA4030S2R2MT 2.2 uH | no basic-library equivalents found (TVS / PTC / 4x4 power inductor) |
| AO3416 light FETs x4 | replaced basic AO3400A (48 mOhm at 2.5 V gate, ~0.6 W at 3 A in SOT-23): the owner's strips draw up to ~3 A per channel; no basic FET is specified <= 26 mOhm at 2.5 V |
| BLM21PG221SN1D speaker beads x2 | basic beads are rated <= 800 mA; the speaker peaks at ~0.9 A rms |
| ESDA6V1-5SC6 x3, USBLC6-2SC6 x2 | no ESD arrays in the basic library |
| 0603WAF1242T5E 12.4 k | value specified by WIZnet (EXRES1 12.4 k 1 %); no basic / preferred listing |
| ABM8-272-T3 12 MHz | the crystal Raspberry Pi specifies for the RP2350 |
| ICs and connectors | not swapped (owner rule) |

Extended-part fees: 34 lines x $3 = $102 per order -> $20.40 / board at 5 boards.
