mikenemat/skeeball-premium-re/hardware/fab/release-2026-10-27c/sbc1-jlc-bom.csv

Comment | Designator | Footprint | LCSC Part #
10nF 0603B103K500NT | C47,C51 | C_0603_1608Metric | C57112
6.8nF 0603B682K500NT | C52,C53 | C_0603_1608Metric | C1631
100nF CC0603KRX7R9BB104 | C4,C9,C15,C17,C37,C38,C39,C40,C41,C42,C45,C55,C72,C73 | C_0603_1608Metric | C14663
4.7uF CL05A475MP5NRNC | C31,C32 | C_0402_1005Metric | C23733
100nF CL05B104KO5NNNC | C18,C19,C20,C21,C22,C23,C24,C25,C26,C27,C28,C29,C30,C34 | C_0402_1005Metric | C1525
1uF CL10A105KB8NNNC | C13,C14 | C_0603_1608Metric | C15849
1nF CL10B102KB8NNNC | C58,C59,C60,C61,C62,C63,C64,C65,C66,C67,C68,C69,C70,C71 | C_0603_1608Metric | C1588
22nF CL10B223KB8NNNC | C50 | C_0603_1608Metric | C21122
47nF CL10B473KB8NNNC | C6 | C_0603_1608Metric | C1622
15pF C0G CL10C150JB8NNNC | C12,C35,C36 | C_0603_1608Metric | C1644
18pF C0G CL10C180JB8NNNC | C48,C49 | C_0603_1608Metric | C1647
10uF CL21A106KAYNNNE | C2,C3,C5,C11,C33,C43,C44,C54 | C_0805_2012Metric | C15850
22uF CL21A226MAQNNNE | C8,C16 | C_0805_2012Metric | C45783
4.7uF CL21A475KAQNNNE | C10,C46 | C_0805_2012Metric | C1779
220uF polymer OVZ221M1ATR-0606 | C1,C7,C56,C57 | CP_Elec_6.3x5.9 | C311623
PWR green KT-0603G | D3,D5 | LED_0603_1608Metric | C12624
FAULT red KT-0603R | D2 | LED_0603_1608Metric | C2286
VBUS yellow NCD0603Y1 | D4 | LED_0603_1608Metric | C84268
SMBJ5.0A SMBJ5.0A | D1 | D_SMB | C83333
3A hold 1812L300MR | F2 | Fuse_1812_4532Metric | C127824
5A hold 2920L500/16MR | F1 | Fuse_2920_7451Metric | C207091
BLM21PG221SN1D BLM21PG221SN1D | FB2,FB3 | L_0805_2012Metric | C85840
600R@100MHz GZ2012D601TF | FB1 | L_0805_2012Metric | C1017
0.5A hold MF-NSMF050-2 | F3 | Fuse_1206_3216Metric | C75464
DISPLAY USB 10118194-0001LF | J9 | USB_Micro-B_Amphenol_10118194-0001LF_Horizontal | C132563
PLAYFIELD LIGHTS 26604020 | J8 | Molex_KK-396_A-41791-0002_1x02_P3.96mm_Vertical | C505042
BUTTONS 39281083 | J6 | Molex_Mini-Fit_Jr_5566-08A_2x04_P4.20mm_Vertical | C293503
SPEAKER 39300020 | J4 | Molex_Mini-Fit_Jr_5569-02A2_2x01_P4.20mm_Horizontal | C240831
RGB LIGHTS 39301049 | J7 | Molex_Mini-Fit_Jr_39-30-1049_1x04_P4.20mm_Vertical | C587488
PWR 5V/GND 39303035 | J1 | Molex_Mini-Fit_Jr_39-30-3035_1x03_P4.20mm_Horizontal | C505179
SCORE 0 955032441 | J21,J22,J23,J24,J25,J26,J27,J28 | RJ11_6P4C_TopEntry_StockPads | C588833
SWD BM03B-SRSS-TB(LF)(SN) | J2 | JST_SH_BM03B-SRSS-TB_1x03-1MP_P1.00mm_Vertical | C160389
SCORE SENSORS HC-PZ254-11.5L-1x9PZ | J5 | PinHeader_1x09_P2.54mm_Vertical | C27985193
HR963380AE HR963380AE | J3 | RJ45_HanRun_HR963380AE_Vertical | C19724763
DEBUG USB-C TYPE-C-31-D-15 | J10 | USB_C_Receptacle_HRO_TYPE-C-31-D-15_Vertical | C22464480
2.2uH SWPA4030S2R2MT | L1 | L_Sunlord_SWPA4030S | C36409
AO3416 AO3416 | Q1,Q2,Q3,Q4 | SOT-23 | C43307
100 0402WGF1000TCE | R15,R16 | R_0402_1005Metric | C25076
1k 0402WGF1001TCE | R12,R13,R14 | R_0402_1005Metric | C11702
0 0603WAF0000T5E | R25,R27,R28,R29,R30 | R_0603_1608Metric | C21189
100 0603WAF1000T5E | R66,R68,R70,R72,R78,R79 | R_0603_1608Metric | C22775
1k 0603WAF1001T5E | R4,R10 | R_0603_1608Metric | C21190
10k 0603WAF1002T5E | R18,R19,R20,R21,R23,R81,R82 | R_0603_1608Metric | C25804
100k 0603WAF1003T5E | R1,R5,R8 | R_0603_1608Metric | C25803
1M 0603WAF1004T5E | R26 | R_0603_1608Metric | C22935
10 0603WAF100JT5E | R33 | R_0603_1608Metric | C22859
12.4k 0603WAF1242T5E | R22 | R_0603_1608Metric | C22865
1.5k 0603WAF1501T5E | R11 | R_0603_1608Metric | C22843
2.2k 0603WAF2201T5E | R42,R44,R46,R48,R50,R52,R54,R56,R58,R60,R62,R64 | R_0603_1608Metric | C4190
22k 0603WAF2202T5E | R6 | R_0603_1608Metric | C31850
27 0603WAF270JT5E | R74,R75 | R_0603_1608Metric | C25190
330 0603WAF3300T5E | R36,R37 | R_0603_1608Metric | C23138
33 0603WAF330JT5E | R24,R39,R40,R41 | R_0603_1608Metric | C23140
470 0603WAF4700T5E | R17 | R_0603_1608Metric | C23179
4.7k 0603WAF4701T5E | R43,R45,R47,R49,R51,R53,R55,R57,R59,R61,R63,R65,R67,R69,R71,R73,R80 | R_0603_1608Metric | C23162
47k 0603WAF4702T5E | R2,R9 | R_0603_1608Metric | C25819
49.9k 0603WAF4992T5E | R7 | R_0603_1608Metric | C23184
49.9 0603WAF499JT5E | R31,R32,R34,R35 | R_0603_1608Metric | C23185
5.1k 0603WAF5101T5E | R76,R77 | R_0603_1608Metric | C23186
510k 0603WAF5103T5E | R38 | R_0603_1608Metric | C23192
680 0603WAF6800T5E | R3 | R_0603_1608Metric | C23228
LANE ID DSIC04LS-P | SW3 | SW_DIP_XKB_DSIC04LS-P | C319038
BOOTSEL TS-1187A-B-A-B | SW1,SW2 | SW_Push_1P1T_XKB_TS-1187A | C318884
CH340N CH340N | U14 | SOIC-8_3.9x4.9mm_P1.27mm | C2977777
ESDA6V1-5SC6 ESDA6V1-5SC6 | U9,U10,U11 | SOT-23-6 | C6650
MAX98357AETE+T MAX98357AETE+T | U8 | TQFN-16-1EP_3x3mm_P0.5mm_EP1.23x1.23mm | C910544
RP2350B RP2350B | U5 | QFN-80-1EP_10x10mm_P0.4mm_EP3.4x3.4mm | C42415655
TLV62569DBVR TLV62569DBVR | U2 | SOT-23-5 | C141836
TLV74311PDBVR TLV74311PDBVR | U3 | SOT-23-5 | C485147
TPS2553DBVR TPS2553DBVR | U4 | SOT-23-6 | C55266
TPS259531DSGR TPS259531DSGR | U1 | Texas_DSG0008A_WSON-8-1EP_2x2mm_P0.5mm_EP0.9x1.6mm | C2155674
USBLC6-2SC6 USBLC6-2SC6 | U12,U13 | SOT-23-6 | C7519
W25Q128JVSIQ W25Q128JVSIQ | U6 | SOIC-8_5.3x5.3mm_P1.27mm | C97521
W5500 W5500 | U7 | LQFP-48_7x7mm_P0.5mm | C32843
12MHz ABM8-272-T3 | Y1 | Crystal_SMD_3225-4Pin_3.2x2.5mm | C20625731
25MHz X322525MOB4SI | Y2 | Crystal_SMD_3225-4Pin_3.2x2.5mm | C9006
