mikenemat/skeeball-premium-re/hardware/docs/QA_LOG.md

# QA_LOG

## Gate table
| Gate | Script | Result (2026-10-26) |
|---|---|---|
| Design structural check | `python scripts/design.py` | 234 parts, 178 nets, 0 issues |
| KiCad ERC (all severities) | `python scripts/build_schematics.py` | 8 messages, **0 electrical** (8 = footprint_link_issues for the 8 pending project footprints) |
| Netlist == design | same | **0 problems** |
| Footprints resolve | `python scripts/qa_footprints.py` | 0 missing, 8 pending (listed with reasons) |
| BOM stock / buyable | `python scripts/bom.py check` | 73 lines, **0 fail**; HR963380AE 154 flagged thin in ARCHITECTURE 5.5 / 7; 6 harness lines provisional / TBD |
| Drawing QA | rasterized PNGs read back | schematic pages + 2 placement renders inspected, defects fixed (Q-6) |

## Findings
| ID | Finding | Status |
|---|---|---|
| Q-1-20261026 | ERC: power-output pins collided with PWR_FLAGs (+5V_SYS, +1V1, +5V_SENS, VBUS_HOST); open-drain FAULT / FLT pins typed 'output' clashed; stock USB_B_Micro marks VBUS / GND as power outputs; stock MAX98357A EP 'unspecified' | **FIXED**: flags only on undriven rails; FLT / FAULT typed open_collector; project symbols USB_B_Micro_Host + MAX98357A_TQFN (pins per the maker pin tables); ERC 0 electrical |
| Q-2-20261026 | Generator placed corner-pin labels by position (RP2350A GPIO0-3 / 26-29, connector end pins stacked) and the stock R / FB / TP / switch / small-IC fields over bodies and labels | **FIXED** in `gen_schematic.py`: label direction from the pin's own rotation; per-symbol field rules; slot width includes the value text; A2 sheets for > 50 units |
| Q-3-20261026 | CH340C (C84681) listed by JLC as 'no longer manufactured / not buyable'; other CH340C listing stock 21 | **FIXED**: CH340N (C2977777, 24,904, buyable), same datasheet |
| Q-4-20261026 | Abracon AOTA-B201610S3R3 (the RP2350 Minimal design's only specified VREG inductor) JLC stock 1 | **FIXED**: external 1.1 V DVDD (TLV74311P) per RP2350 DS Figure 24 (documented deviation) |
| Q-5-20261026 | RP2350A stepping on the JLC reel not stated; A2 erratum E9 | **ACCEPTED**: no circuit relies on internal pull-downs; external pull-ups on every input (ARCHITECTURE 7) |
| Q-6-20261026 | Placement render: legend clipped, J11 leader through G10, H1 label on the Playfield box, G2 / G6 overlapping zone b / J20; RJ45 study: arrow through the title, text clipped | **FIXED**, re-rendered and re-read |
| Q-7-20261026 | Owner rule 'checked on the live part page' | **DONE**: all lines via the JLC parts-library API (part-page backend), timestamped; 3 rendered-page spot checks equal (RP2350A 5,711 / $1.2947; TPS259531DSGR 2,161 / $0.8773; ABM8-272-T3 2,730 / $0.6580) |
| Q-8-20261026 | CL10B682KB8NNNC (6.8 nF) JLC stock 2 | **FIXED**: FH 0603B682K500NT (C1631, basic) |
| Q-9-20261026 | 30 extended lines = $90 feeder fees per order | **BOUNDED**: passives moved to JLC basic where a same-or-better basic part exists (fb divider 100k/22k + 15 pF, UVLO 39k); the rest are ICs / connectors with no basic option |
| Q-10-20261026 | First photo estimate (angled image4, linear scale) read the outline as ~115.7 x 85.1 mm | **SUPERSEDED** by the straight photo + plane homography: ~108.7 x 84.6 mm, corner holes 3.2 mm in from both edges (self-consistent at all four corners); J11 pitch sets the scale, the RP2040 width cross-check reads 5 % larger (recorded in estimate.json) |
| Q-11-20261026 | Buttons header assumed 2x3 (brief) | **FIXED**: the straight photo shows 2 x 4 cavities (8 pins); Conn_02x04, provisional Molex 39281083 (C293503); pin map on the owner list |
| Q-12-20261026 | Speaker assumed BOSS BRS52B (2022 manual) | **FIXED**: owner photo = Stetron DB20-009 / AACE8811A, 4 Ohm nominal, rating unverified; 9 dB gain + firmware volume cap (ARCHITECTURE 5.8 / 5.12) |
| Q-13-20261026 | Root schematic sheet boxes showed no names; long sheet titles overflowed the title block; CH340N / TLV62569 reference text touched the body | **FIXED** in the generator (Sheetname / Sheetfile kept visible, titles <= 45 chars, field rules); pages re-rendered and read |
| Q-14-20261026 | RP2350A ran out of GPIO (DECISIONS #1 pushed W5500 RSTn / INTn and the fault flag into hardware) | **FIXED**: RP2350B (C42415655, 3,477 in stock, $1.2833, live page checked 2026-10-26); design per Figure 16 / Appendix B; RSTn / INTn / FAULT / 5 V monitor back on GPIO; 4 spare GPIO test pads; ERC 0 electrical, netlist == design |
| Q-15-20261026 | J11 was a bare-pin header; the owner's plug is a 9-way latching housing (KK 254 / XH style) | **FIXED**: shrouded friction-lock vertical header; Molex 22-27-2091 / 22-05-3091 are not at JLC, so CJT A2541WV-9P (C225484, 2.54 mm, 4,348) is fitted with JST B9B-XH-A (C157966, 2.5 mm, 10,929) as the alternate; pitch goes on the owner list, both footprints to be drawn |
| Q-16-20261026 | RJ45 zone / orientation open | **CLOSED (owner)**: zone a, vertical HanRun HR963380AE; W5500 group G13 placed under it; HR911105A dropped from the BOM (fallback flag only). Stock 154 (re-checked live 2026-10-26): no second vertical magjack at JLC; backup = XUNPU RJ45-408-050-11 + Pulse HX1188NL transformer (layout change) |
| Q-17-20261026 | 28 extended lines = $16.80 / board at 5 boards | **FIXED / BOUNDED**: cost pass - FB1 -> Sunlord GZ2012D601TF (basic), R37 634k -> 680k (preferred), USB 27 R 0402 -> 0603 (preferred): 25 extended lines, $15.00 / board at 5, $3.75 at 20. Kept-extended lines and reasons in ORDERING.md; no basic equivalents exist for polymer caps, green 0603 LED, TVS, PTC, 4x4 inductor, 2 A beads, ESD arrays |
| Q-18-20261026 | Photo estimate read the outline as 108.7 mm long; the owner measured **116.68 mm** (100 % sure). Cause: the homography scale was taken from the J11 pin span read as 2.54 mm pitches at the pad edges (5 % short); the RP2040-width cross-check had flagged it | **FIXED**: homography now anchored on the four MEASURED hole centres (no scale assumption); check: RP2040 maps to 7.04 x 7.01 mm, board edges to 0.3 / 116.3 / 85.6 mm. Outline + holes exact in `layout_const.MEASURED` and drawn in the board file; connector positions photo +-1 mm |
| Q-19-20261026 | Owner continuity: power pin 2 NC; RGB pin 1 (leftmost / square) = +5 V; Playfield lower pin = +5 V; J11 edge span 20.64 mm (pitch still ambiguous) | **FIXED** in design.py pin maps; both J11 footprints held (M-C6 open) |
| Q-20-20261026 | Board file created: outline (Edge.Cuts) + 4 x 3.57 mm NPTH footprints + connector bodies on User.Comments; kicad-cli SVG export OK; PNG inspected | **DONE** (`renders/pcb/sbc1-outline.png`) |
| Q-21-20261026 | J11 common polarity | **CLOSED (owner continuity)**: pin 1 = GND; pins 2-9 inputs; JP1 removed; +5V_SENS switch kept unloaded pending M-E3 |
| Q-22-20261026 | Buttons 2x4 pin map | **CLOSED (owner continuity)**: latch-side row = GND x4, other row = 4 signals; `BUTTONS_PINMAP` 1-4 GND / 5-8 signals with a row-to-pin-number check at layout |
| Q-23-20261026 | Speaker / Buttons connectors identified (Mini-Fit Jr 5569-02A1 dual-row RA / 5566-08A 2x4); power 1x3 RA and RGB 1x4 are single-row 4.2 mm | Speaker = Molex 39291028 (C505060, 1,505), Buttons = 39281083 (C293503) fitted with KiCad footprints. **OPEN (owner decision)**: JLC has no single-row 4.2 mm 1x4 and only a thin (46) HDGC 1x3 RA - options in MEASUREMENTS_NEEDED |
| Q-24-20261026 | Owner's 300 dpi bottom-side flatbed scan | **DONE**: `scripts/scan_extract.py` maps the scan onto the four measured hole centres (affine, 0.008 mm residual); scale vs the declared 300 dpi: +0.6 % (board y) / +1.2 % (board x) - the caliper hole spacing is taken as truth; every harness pad centre extracted to +-0.1 mm (table in PLACEMENT_PLAN); J11 pitch 2.509 mm = XH 2.5 (not KK 254); Playfield pitch 3.38; photo estimate retired (its PWR / RGB / J18 positions were within 0.4-1.1 mm) |
| Q-25-20261026 | Single-row 4.2 mm headers | **RESOLVED**: they are genuine Molex Mini-Fit Jr single-row parts (DigiKey: 0039303035 1x3 RA WM18446-ND 32,732; 0039301049 1x4 vertical WM7249-ND 15,620; both with board locks, matching the scanned peg holes); owner-fitted per decision (b); `bom.py digikey` -> DIGIKEY_BOM.md |
| Q-26-20261026 | J11 pitch: scan 2.51-2.54 ambiguous | **CLOSED (owner calipers)**: KK 254; CJT A2541WV-9P fitted, XH dropped |
| Q-27-20261026 | Scan x scale: 4.2 mm connectors read 4.16-4.18 under the hole-derived scale | **BOUNDED**: board x on the declared 300 dpi (4.19-4.21), y on the hole scale (5.50 row spacings confirm); implied short-edge hole inset 3.64 vs owner 3.97 -> M-H1 re-check; pad x values may move <= 0.4 mm |
| Q-28-20261026 | Light loads far above the first estimate (RGB 60 LED/m x >2 m, playfield 24 x 5050) | **FIXED**: 4 x AO3416 (<= 26 mOhm at 2.5 V gate, C43307, 48,177) for AO3400A; +5V_LIGHT split into +5V_RGB (Littelfuse 2920L500/16MR 5 A hold, C207091, 2,614) and +5V_PF (1812L300MR 3 A hold), each with bulk + TP; firmware light cap RGB 4.0 / PF 1.5 / total 5.0 A (provisional, M-E6). ERC 0 electrical, netlist == design, BOM 0 fail; pages inspected |
| Q-29-20261026 | Score sensor type (M-E3): owner photo of the playfield holes shows a wire lever across each hole + audible click = mechanical lever microswitches, not optos | **FIXED**: +5V_SENS TPS2553 + its RILIM / caps / TP removed (defunct-feature rule); score + button pull-ups 4.7 k -> 2.2 k (1.5 mA wetting current); ball-holder strip photo confirms the 4-wire 60 LED/m 5050 analog strip (M-E2) |
| Q-30-20261026 | 7 pending footprints | **DONE**: `fpgen.py` draws power 1x3 RA + RGB 1x4 vertical Mini-Fit Jr (LCSC footprints; pegs confirmed on the owner's scan), HR963380AE (HanRun p.3), HRO TYPE-C-31-D-06 (HRO layout, slot NPTH), XKB DSIC04LS-P (XKB layout, rows 9.30); J11 / playfield on KiCad stock Molex footprints; `qa_footprints.py` 0 pending; renders inspected |
| Q-31-20261026 | JLC search with zero-padded Molex MPNs (0039303035 / 0039301049) only found discontinued listings | **FIXED**: genuine Molex 39303035 (C505179), 39301049 (C587488) in JLC stock -> JLC-placed; owner-fitted DigiKey path removed (bom.py digikey, DIGIKEY_BOM.md, CSV) |
| Q-32-20261026 | J11 CJT A2541WV-9P is a plain unshrouded pin header (CJT catalog A-216), not the latching header the design claimed | **FIXED**: genuine Molex KK 254 friction-lock 22232091 (C587032, stock 50 = ample for 5 boards) |
| Q-33-20261026 | Playfield Molex 0026644020 is a VERTICAL header (DigiKey: through hole, board guide); the stock part is right-angle | **FIXED**: Molex 26605020 KK 396 right-angle friction lock (C587092) |
| Q-34-20261026 | RJ45 HR963380AE LED pins reversed: HanRun rev 00 p.1 = anodes 12 / 14, cathodes 11 / 13; design had 3V3 on 11 / 13 (LEDs dark) | **FIXED** in design.py + symbol; ERC 0, netlist == design |
| Q-35-20261026 | D1 SMBJ5.0A (unidirectional) had footprint pad 1 = cathode band on GND: forward-biased across the 5 V input at power-up | **FIXED**: pad 1 (K) = +5V_IN, pad 2 (A) = GND; ERC 0, netlist == design |
| Q-36-20261026 | Speaker header 39291028 (flange mount, 2 holes 4.5 mm off-axis) does not match the stock part: the scan shows one 3.3 mm peg on the pin axis 7.28 mm out | **FIXED**: Molex 39300020 (5569-02A2, snap-in peg 7.3 mm on axis; KiCad + LCSC C240831 agree), JLC stock 298 |
| Q-37-20261026 | Placement | **DONE** (`scripts/place.py`, KiCad python): netlist (footprints + nets) imported from design.py, 226 parts placed, SMD top side only, harness headers on the scanned pads; KiCad DRC: 0 courtyard / clearance / edge findings (4 lib_footprint_mismatch = edge-silk trim, 499 unrouted expected); silk labels placed by a free-space pass (64 small parts keep their reference on F.Fab only); test points labelled with short net names, LEDs / buttons / DIP / SWD / debug port with function labels; renders inspected |
| Q-38-20261026 | Owner: purpose of every stock passive, replicate where needed | **DONE**: `docs/records/stock_passives/REPORT.md` - 64 passives + R11 DNP, purpose / confidence / SBC-1 counterpart each; no unreplicated function; 11 unsure items (meter / photo); two SBC-1 doc errors fixed (stock heartbeat GPIO27, score pull-up 2.2 k in the I/O table) |
| Q-39-20261026 | Owner: replicate the 8 stock score jacks (0 10 20 30 40 50 100 100) | **DONE (pin map provisional)**: J21-J28 Molex 95501-2641 6P4C right-angle (JLC C3179414, 223; DigiKey: 6p4c RJ11), footprint from the owner's scan on the 95501 grid at the stock positions (12.08 pitch, opening flush with the bottom edge); in parallel with J11 per score line. Ckmtw R-RJ11R04P-A800 rejected (posts outboard 12.0 apart: neighbouring jacks collide). Contact map pin 2 = signal / pin 3 = GND is PROVISIONAL - owner to confirm |
| Q-40-20261026 | Owner: silk priority = connector purpose + ID + human-readable pin maps; scatter test points | **DONE**: every connector labelled "<ref> <purpose>" (J1 5V IN, J7 RGB, J8 PLAYFIELD, J5 SCORES, J6 BUTTONS, J4 SPEAKER, J9 DISPLAY, J3 ETHERNET, J10 DEBUG, J2 SWD, J21-J28 + score value); pin labels 5V / NC / GND, 5V R G B, 5V / LED, GND / IN, START B C D / GND, SPK+ / SPK-; test points placed by a nearest-free-spot search next to their nets; bottom-strip parts moved (DIP + LEDs right centre, RESET / BOOT / CH340N / USB-C above the jacks) |
| Q-41-20261026 | 3D models missing for 15 footprints (this KiCad install lacks part of the 3D library; GitLab raw download answered with an HTML bot page -> not retried) | **DONE (envelopes)**: `scripts/model_gen.py` writes box models at the drawing dimensions for 13 footprints (hardware/lib/3d); 3 same-package stand-ins (WSON-8 2x2, TQFN-16 3x3, R_1812 for the 1812 PTC); audit: only test points / holes without a model. Vendor STEP models remain a nice-to-have |
| Q-42-20261027 | Owner: connector renders are "trash" (white envelope boxes), polarity shapes not visible | **DONE**: `scripts/vendor_models.py` - the EasyEDA STEP of each connector's / switch's JLC C-number (latches, keys, ramps, pegs), fitted on our footprint's pads by pad number, refined on the model's pin tails vs our THT pads; per-part height corrections from cross-section profiles (FIX); jacks fitted on geometry only (TAILS_FIT). `scripts/render_pcb.py` renders top, iso, both connector edges close up and all four edges dead on (orthographic) |
| Q-43-20261027 | Owner: "J6 buttons is 180 degrees from our board" | **FIXED (electrical)**: KiCad 5566-08A fab and JLC C293503 footprint + model agree the latch is on the circuits 5-8 row; the scanned latch row (GND, owner continuity) is y 61.7 -> J6 at 0 deg with pin 1 at (3.5, 56.2), BUTTONS_PINMAP 5-8 = GND, 1-4 = D C B START (same pads, same signals per pad as before). ERC 0, netlist == design |
| Q-44-20261027 | Owner: "the playfield lights jack is so clearly and obviously vertical" | **FIXED**: J8 = Molex KK 396 VERTICAL 26-60-4020 (A-41791-0002, JLC C505042, 24.7 k stock) at the same scanned pads, friction-ramp wall inboard (photo image4), pin 1 (+5 V) lower; the right-angle 26-60-5020 note was wrong (the old note even recorded that the stock-photo candidate was vertical). Q4 / R72 / R73 moved clear of the new housing |
| Q-45-20261027 | Score jacks J21-J28 vs the stock board | **OPEN (paused with the RJ11 work)**: the stock jacks are TOP-ENTRY ('MXCH 95003', image4); our scanned footprint (posts 7.66 apart at the edge, pins inboard) matches that part, but MPN / model are the right-angle 95501 (Q-39 misread the part). Molex 95003 is not at JLC; JLC vertical 6P parts found are 13.4-14 mm wide (> 12.08 pitch). Contact map: owner 1 = 5 V, 2 = signal, 3 = NC, 4 = GND vs a bottom-scan trace from J11 pin 1 (GND) to the 2nd tail of the 7th jack - owner asked for visual proof |
| Q-46-20261027 | Owner: QA vs the reference board "atrocious" | **DONE (independent reviewer, read-only, scan blobs + photo crops, evidence crops in .runtime/qa-review/)**: OK = J1 (D-shaped pin-1 cavity, pegs, overhang), J4 (stacked RA, latch up, peg 7.24 vs 7.3), J6 (latch +y, cavity pattern), J7 (pegs, tab, pin-3 cavity), J8 (vertical, ramp +x, pitch 3.92 on the scan), J9 (same centre / mouth / plug direction; different part), J10, J3 on the board (machine headroom CANNOT TELL), holes (M-H1 +-0.3 mm). MISMATCH = J21-J28 type (Q-45; footprint geometry OK incl. pin-1 corner) and the jack contact map (scan: J27 pin-2 tail tied to J11 pin 1). CANNOT TELL = J5: stock J11 is a plain header, ours is friction-lock with the wall on -y - the stock plug's ribs / ears must seat against it (owner photo of the plug, OWNER-ASKS 4) |
| Q-47-20261027 | Owner: "Why are my RJ11s not vertical out of the board"; owner pointed at Molex 95003-2661 / 95503-2661 and sent the Molex drawing SD-95503-003 | **FIXED**: J21-J28 = Molex 95503-2441 4P4C low-profile TOP-ENTRY (JLC C588833, 649 stock). The drawing's 4 POS column (A 11.18 body, B 7.62 posts, D 3.81 tails; posts 4.96 behind the front face, tail rows 6.35 / 8.89) = the scanned stock pads exactly, body marked '95003', mfg ID 'MXCH' = the stock jacks; the 6 POS 2661 is 13.21 wide / posts 10.16 and would not fit the 12.08 pitch. Footprint renamed RJ11_6P4C_TopEntry_StockPads (stock pads), composite model to the drawing (no EasyEDA model). Lesson: my "no JLC part" conclusion came from keyword searches + LCSC's wrong "right angle" attribute; the MPN family was on the stock part all along |
| Q-48-20261027 | Owner: the stock score plug has ears and would not mate with the friction-lock J5 | **FIXED (owner: "make J5 a plain 1x9 2.54 mm vertical pin header like the stock J11")**: J5 = Hong Cheng HC-PZ254-11.5L-1x9PZ (JLC C27985193, 2,390 stock), KiCad PinHeader_1x09_P2.54mm_Vertical at 270 deg, pin 1 (GND, '*') at 68.58 as before; the plug's ribbed ears are finger grips that friction-fit a plain header (photo image5). KK 254 friction-lock model / mapping removed |
| Q-49-20261027 | Owner: tact switches not landing on their pads (offset by half the part); move RESET / BOOT next to J3 / J9 | **FIX IN PROGRESS**: root cause in vendor_models.py - the CENTROID fit built our pads as a {number: pad} map, so the TS-1187A's repeated pad numbers kept one pad per terminal and shifted the centroid half a body; now uses every pad (`all_pads`, raises without it). place.py change + SW1 / SW2 (+ RUN / BOOTSEL passives) move to the free top-edge space between J3 and J9 handed to the routing agent's pass 3 (it owns place.py) |
| Q-50-20261027 | Owner: USB-C J10 needs clearance from the RJ11 jacks for an overmolded cable plug | **FIX IN PROGRESS (routing agent, place.py)**: USB-IF max overmold envelope 12.35 x 6.5 mm above the 6.4 mm receptacle had 1.9 mm to J28 (15.7 mm tall); target >= 5 mm to every part taller than the receptacle (J10 to about y 61.5 with U13 / R76-R79), enforced by a new place.py check |
| Q-51-20261027 | Owner: "get rid of all of our test pads" | **DONE in design.py** (30 TP parts removed; SPARE_GPIO34-37 back to no-connect; ERC 0, netlist == design, BOM 0 fail); place.py / power_copper.py test-point code removal handed to the routing agent (owns them this pass) |
| Q-52-20261027 | RJ11 contact map + jack-to-J11 order | **DONE (owner continuity on the stock board, last '100' jack, from the bottom side)**: contact 1 = 5 V (+5V_SYS, no extra protection - none on the stock board, owner "easy on the protections"), 2 = score line, 3 = NC, 4 = GND (= the owner's first map; the scan trace reading was wrong). The last '100' jack's line = J11 pin 2 -> J11_PINMAP reversed: pin 9 .. 2 = '0 10 20 30 40 50 100 100' (top view left -> right, as the jacks); score GPIOs unchanged by net name. ERC 0, netlist == design, BOM 0 fail |
| Q-53-20261027 | Owner: jack -> score-header order "isn't totally linear" | **DONE**: owner frame (top view, jacks 1-8 and header positions 1-9 left -> right): jacks 1-6 -> 2-7, jack 7 (first '100') -> 1, jack 8 (last '100') -> 8, GND = 9. Ours (pin 1 = square GND pad, right end): J11_PINMAP 2 = 100B, 3 = 50, 4 = 40, 5 = 30, 6 = 20, 7 = 10, 8 = gutter, 9 = 100A. Bottom scan audited: the trace runs from the LEFTMOST header pin along the row (past the square pad, not to it) to the first '100' jack's contact-2 tail - agrees; the Q-45 / Q-46 reading "J11 pin 1 -> J27" was a misread of the trace's start. Board audit script: every jack's contact 2 lands on the stated header position |
| Q-54-20261027 | Routed renders: J1 / J4 / J6 / J7 / J8 vendor models show as white boxes in the scratch copy (p7) | **DONE**: not a path problem - the STEPs resolve (KIPRJMOD/../lib junction works). A bare `kicad-cli pcb render` defaults to `--quality basic`, which draws the white nylon Mini-Fit / KK housings flat and unshaded. `scripts/render_pcb.py` now takes `--board / --out / --views` so scratch candidates render through it (`--quality high`, fails on any model-load error); left / right edge zoom 3.0 -> 2.7 (J3 top touched the frame). p7 top + 4 edges re-rendered and inspected: latches / ramps / pegs / cavities visible, no clipping |
| Q-55-20261027 | Routing: run_stage legalisation drops ~20 planned joins per stage | **ROOT CAUSE + FIX**: all 12 plan_check violations of p7 stage 1 sat beside NO-NET pads (NC pins): plan_check asks 0.2 mm to no-net copper, pfr2's grid 0.15. Planning margin sweep (pfr2 --margin on p7 stage 1, plan unrouted -> open after run_stage): 0.04 = 11 -> 34, 0.06 = 45 -> 57, 0.08 = 57 -> 58, 0.10 = 58 -> 61, 0.12 = 94 -> 85 - a bigger margin stops the drops but pfr2 then plans far fewer joins, so the margin stays 0.04. Fix: place.py gives every no-connect pad KiCad's own `unconnected-(REF-PIN-PadN)` net (from the kicad-cli netlist) - also clears the 57 parity net_conflicts |
| Q-56-20261027 | Owner TODO-2 + TODO-3 (M-H1 per-axis hole insets) on the unrouted placement | **DONE**: `layout_const.MEASURED` hole_inset_x 3.885 / hole_inset_y 3.585 -> H1 (3.885, 3.585), H2 (112.795, 3.585), H3 (112.795, 82.145), H4 (3.885, 82.145). `scan_extract.py` re-anchored on the new holes, declared-dpi x override removed: hole-derived scale 11.865 px/mm in x / 11.838 in y vs 11.811 declared (+0.46 / +0.23 %), hole-only residual 0.008 mm. Connector origins = least-squares translation fit of the footprint's nominal pad pattern to the scanned pads (pin 1 = origin, so pin-1 shift = origin shift), old -> new (dx, dy mm): J1 (95.59, 10.71) -> (95.40, 10.39) (-0.19, -0.32); J7 (3.59, 37.84) -> (3.81, 37.79) (+0.22, -0.05); J8 (4.63, 15.41) -> (4.885, 15.12) (+0.255, -0.29); J5 (68.58, 65.00) -> (68.47, 65.24) (-0.11, +0.24; scan-only part -0.00 / +0.22, the rest = 9-pin fit vs the former single pin-1 reading); J6 (3.50, 56.20) -> (3.63, 56.36) (+0.13, +0.16; scan-only +0.22 / +0.16, the former x came from the latch row alone); J4 (105.67, 48.25) -> (105.45, 48.31) (-0.22, +0.06); J9 (61.43, 2.75) unchanged (anchor centre 61.433; y = PCB Edge line, footprint); J21-J28 x (+0.19, +0.14, +0.09, +0.02, -0.03, -0.08, -0.14, -0.20), y 80.25 -> 80.63 (+0.38; jack fronts now 0.14 mm inside the bottom edge). J3 / J10 not on scanned pads: unchanged. Knock-on (lead OK): Q4 y 7.2 -> 6.9, R72 y 4.65 -> 4.35, C3 y 18.4 -> 18.6 (clear of the moved J8 courtyard). `power_copper.py` TRACKS ends follow J1.1 / J7.1-4 / J8.1-2 / Q4.3 / C3.1. TODO-2: pcb_build.py no longer writes the Cmts.User scan-guide circles (0 gr_circle). Placement DRC: lib_footprint_mismatch 12 only; route_stage todo3check (power_copper + route_prep) DRC: same. Renders renders/pcb/placement/ inspected (all 8). Open: the Mini-Fit 4.20 pitches read 4.10-4.21 and J11 2.513 under the new scale (x ~0.5 % short), worth an independent connector QA pass |
| Q-57-20261027 | 4-layer route closed and adopted | **DONE**: hardware/main = q3 (4-layer, from scratch on the remapped / re-registered placement): 0 open joins, KiCad DRC (refilled zones + parity) 0 failing; 343 routed vias + 31 locked, 3054 mm routed track (F 1639 / In2 747 / B 667). Closure: q1 stage 1-2 left PWR_FAULT_N U4.4-U1.6 (the frozen +5V_SYS trunk crossed the eFuse FLT pin front -> power_copper FLT escape stub + via through the C9 / R3 lane) and QSPI_SD1 U5.74-U6.2 (rip_local r 1.2 at U6.2 / U5.74, rails kept) -> one pfr2 stage with --srr 300 = 0 open. Cleanup time-boxed (15 min): snapshot 12 kept (later lqfix:0 step left 2 track_dangling). Gates: drc_coverage / footprints PASS; copper_landing CLEAN classes, layout_quality, PROT-GND, CAP-FAR, silk open (WORK_STATE NEXT). Renders + 4 layer plots inspected (models present, holes at the TODO-3 positions, no guide circles) |
| Q-58-20261027 | Owner "everything real" triage pass (q4) | **PARTLY DONE, ADOPTED**: hardware/main = q4, 0 open, DRC refilled clean; 353 routed vias (+31 locked), 3081 mm. Done: #1/#2 crystal keep-zones (XTAL 6 -> 5), #5 Ethernet re-route (RX skew 6.52 -> 5.88), #3 ESD vias (PROT-GND 6 -> 2), #8 silk 0.15 mm + SPK labels (UNDER-PART 2 -> 0, OVERLAP 1 -> 0), #11 cleanup (snapshot 12), current capacity A (FET source vias) / B (J1.3 solid) / C (In2 +5V_IN trunk, VIA-CURRENT cleared). Reverted: #6 (no gain), #4 (2 opens, C24 worse). #7 = gate artefact (overlapping shell pads). Queue for the next pass in WORK_STATE (placement wave, connector review, adversarial review S1-S3 / L1-L4 / docs, J10 replacement, release package) |
| Q-59-20261027 | Hardware agent pass 6 (q5): owner-approved finishing queue 1-6 | **DONE (see CHECKPOINT 2026-10-27 pass 6 + the final report)**: duplicate via UUIDs in q4 fixed; 1 placement wave (Y1 270 deg + locked XIN / decap stubs: XIN 11.61 mm / 2 vias -> 5.53 mm / 0 vias, XTAL 5 -> 3, DECAP-LOOP 6 -> 3; Y2 group + C19 reverted: caged button nets / SC_100A); 2 current capacity in power_copper (Q1-Q3 1.2 mm + 3 vias, Q4 3 vias, J1.3 patch + 6 vias, In2 trunk) + current_budget GND returns; 3 J7 kept (= LCSC), J4 model housing 120.55 -> 119.33 (fab 119.35), J8 plug clear; 4 S1-S3 + L1-L4 + docs (BRINGUP.md); 5 J10 = pin-in-paste fallback (DECISIONS #11: 9 drawings, none for 1.6 mm); gate REF_LAYERS fix (DECISIONS #12); bom.py identity gate (MPN + package size) |
| Q-60-20261027 | Coordinator QA corrections 2026-10-27b (C:\work\SKEEBALL-QA-2026-10-27b\CORRECTIONS.md, A1-D5) | **DONE / PARTLY per item, ADOPTED (q6)**: DRC refilled + parity 0 / 0 unconnected; trunk In2 pour reconnected (LIGHT_PF off In2 and out of the J3 void), necks widened, min cut 1.70-1.90 -> 4.58 mm 1 oz-eq (J1 spokes) / 5.70 (trunk), drop J1 -> F1 52 -> 25 mV; D1 GND patch + 5 vias; eFuse IN 0.7 / 0.44 land; 6 / 9 +5V_SYS vias doubled; U8 EP 1 via (4 do not fit) + paste windowpanes U5 / U1 / U8; U2 SW 0.6 land; J1 thermal 4 x 1.0; R81 / R82 / 4.7k / 510k / NationStar LEDs / HRO D-15 (regens: ERC 0, netlist 0, BOM PASS); XOUT 13.1 mm 3 vias -> 5.5 mm 0 vias; D+ ESD in line; C31 at VREG pins; silk 0.15 / 1.0 mm / "* GND"; J3 model -1.31 mm; J8 drill 1.8; fab_release pad + polarity checks, jack / J10 CONFIRM at body centre; release fab/release-2026-10-27b (199 PASS / 9 CONFIRM); renders renders/pcb/final-2026-10-27b. B8 / B9 accepted. Gates 2/7 PASS (dispositions in the q6 report). Open: O1-O3 |
| Q-61-20261027 | D2 back to KENTO KT-0603R C2286 (JLC review: NCD0603R1 C84263 Standard-PCBA-only; order = Economic) | **DONE**: design.py D2 + PCB D2 fields; ERC 0, netlist 0, bom.py check PASS (76 lines; KT-0603R basic, stock 7,642,560); DRC refilled + parity 0 errors / 0 unconnected (warnings = q6 set). fab_release diode polarity now by LCSC A / K pin names onto our A / K nets (netlist pin functions), dot reported; test_fab_polarity.py ALL PASS (reversed CPL / board / LCSC names FAIL for C2286, C12624, C84268; C83333 dot rule). D2 CPL 103.9999 / -33.9999 / Top / 0: LCSC pad 1 (A, dot) -> our pad 2 LED_FAULT_A, pad 2 (K) -> our pad 1 PWR_FAULT_N (silk bracket). D1-D5 PASS. Release fab/release-2026-10-27c: 199 PASS / 0 FAIL / 9 CONFIRM; 16 / 16 gerber + drill files identical to -b after removing creation-date lines |
| Q-62-20261028 | Owner: audit JLC's production file (order Y27, 13673858A_Y27) | **PASS, no action.** The uploaded 16 files are byte-identical to release-2026-10-27b. Order parameters: 4L, 1.6 mm, 1 oz / 0.5 oz, green / white, ENIG, vias plugged, no customer code, single board, Economic PCBA. Layer map In1 -> L2, In2 -> L3. JLC CAM vs ours, rasterized at 0.025 mm and aligned: top / bottom copper and top silk identical. Inner layers: non-functional pad removal only (L2: 184 / 184 connected holes kept, 287 unconnected rings removed; L3: 140 / 140 kept). Mask: +121 openings, all NPTH clearance rings plus corner pullback. Drills: plating compensation (PTH +0.15, NPTH +0.03-0.05, vias 0.30 unchanged) plus 2 JLC-added 1.152 mm tooling holes at (24.43, 21.75) and (38.58, 12.60), inside the J3 void, >= 0.47 mm from any copper and clear of the J3 pegs. Plug layer: 391 vias ink-plugged, the 12 EP vias (U5 x9, U1 x2, U8 x1) left open, no plugged via in a pad. DFM min track 0.20 / space 0.175 mm. The stack-up name (JLC04161H-7628) is not in the CAM files; check it on the order page. Evidence: scratchpad jlcprod/ (cmp/, ring2.py, sk.py, drl.py). |
| Q-63-20261028 | Owner: audit JLC's PCBA verification shots ("Corrected Part Placement", order 13673858A_Y27) | **PASS, 1 note.** Our pad geometry was overlaid on JLC's high-res top shot (12 zoom tiles, whole board). All 208 placements sit on their pads. Pin 1 / polarity correct on U1-U14, Q1-Q4, D1 (band on +5V_IN), D2-D5 ("+" on the anode; D2 = C2286 override), C1 / C7 / C56 / C57 ("+" on the + pad), Y1 / Y2, SW3, J1 / J2 / J4-J10 (J6 latch on the GND row; J7 / J1 / J10 pegs on our peg holes). Bottom side: no parts. NOTE: for J21-J28 (C588833, genuine Molex 955032441) JLC's engineer drew a stand-in model with posts at about +-5.8 mm and the pin-1 dot 3 mm off, against our verified posts at +-3.81 mm (stock board and Molex drawing). THT, and the asymmetric hole pattern fixes the position, so no impact; suggested reply to JLC: insert into the drilled holes, posts 7.62 mm apart. |
