mikenemat/skeeball-premium-re/hardware/fab/release-2026-10-27c/sbc1-cpl-qa.txt

PASS C1 C311623 CAP-SMD_BD6.3-L6.6-W6.6-FD-A: KiCad 0 + offset 0 = CPL 0, Mid shift (+0.000, +0.000), fit by pad numbers (2 pads), every LCSC pad centre on a board pad (worst centre offset 0.130 mm), pad numbers / functions match mark->pad 1
PASS C2 C15850 C0805: KiCad 0 + offset 0 = CPL 0, Mid shift (+0.000, +0.000), fit by pad numbers (2 pads), every LCSC pad centre on a board pad (worst centre offset 0.050 mm), pad numbers / functions match mark->pad 1
PASS C3 C15850 C0805: KiCad 0 + offset 0 = CPL 0, Mid shift (-0.000, +0.000), fit by pad numbers (2 pads), every LCSC pad centre on a board pad (worst centre offset 0.050 mm), pad numbers / functions match mark->pad 1
PASS C4 C14663 C0603: KiCad 180 + offset 0 = CPL 180, Mid shift (+0.000, +0.000), fit by pad numbers (2 pads), every LCSC pad centre on a board pad (worst centre offset 0.075 mm), pad numbers / functions match mark->pad 1
PASS C5 C15850 C0805: KiCad 0 + offset 0 = CPL 0, Mid shift (+0.000, +0.000), fit by pad numbers (2 pads), every LCSC pad centre on a board pad (worst centre offset 0.050 mm), pad numbers / functions match mark->pad 1
PASS C6 C1622 C0603: KiCad 270 + offset 0 = CPL 270, Mid shift (-0.000, -0.000), fit by pad numbers (2 pads), every LCSC pad centre on a board pad (worst centre offset 0.075 mm), pad numbers / functions match mark->pad 1
PASS C7 C311623 CAP-SMD_BD6.3-L6.6-W6.6-FD-A: KiCad 0 + offset 0 = CPL 0, Mid shift (+0.000, +0.000), fit by pad numbers (2 pads), every LCSC pad centre on a board pad (worst centre offset 0.130 mm), pad numbers / functions match mark->pad 1
PASS C8 C45783 C0805: KiCad 90 + offset 0 = CPL 90, Mid shift (+0.000, +0.000), fit by pad numbers (2 pads), every LCSC pad centre on a board pad (worst centre offset 0.050 mm), pad numbers / functions match mark->pad 1
PASS C9 C14663 C0603: KiCad 180 + offset 0 = CPL 180, Mid shift (-0.000, -0.000), fit by pad numbers (2 pads), every LCSC pad centre on a board pad (worst centre offset 0.075 mm), pad numbers / functions match mark->pad 1
PASS C10 C1779 C0805: KiCad 90 + offset 0 = CPL 90, Mid shift (+0.000, -0.000), fit by pad numbers (2 pads), every LCSC pad centre on a board pad (worst centre offset 0.050 mm), pad numbers / functions match mark->pad 1
PASS C11 C15850 C0805: KiCad 0 + offset 0 = CPL 0, Mid shift (+0.000, +0.000), fit by pad numbers (2 pads), every LCSC pad centre on a board pad (worst centre offset 0.050 mm), pad numbers / functions match mark->pad 1
PASS C12 C1644 C0603: KiCad 0 + offset 0 = CPL 0, Mid shift (+0.000, +0.000), fit by pad numbers (2 pads), every LCSC pad centre on a board pad (worst centre offset 0.075 mm), pad numbers / functions match mark->pad 1
PASS C13 C15849 C0603: KiCad 90 + offset 0 = CPL 90, Mid shift (+0.000, +0.000), fit by pad numbers (2 pads), every LCSC pad centre on a board pad (worst centre offset 0.075 mm), pad numbers / functions match mark->pad 1
PASS C14 C15849 C0603: KiCad 0 + offset 0 = CPL 0, Mid shift (-0.000, +0.000), fit by pad numbers (2 pads), every LCSC pad centre on a board pad (worst centre offset 0.075 mm), pad numbers / functions match mark->pad 1
PASS C15 C14663 C0603: KiCad 180 + offset 0 = CPL 180, Mid shift (-0.000, -0.000), fit by pad numbers (2 pads), every LCSC pad centre on a board pad (worst centre offset 0.075 mm), pad numbers / functions match mark->pad 1
PASS C16 C45783 C0805: KiCad 180 + offset 0 = CPL 180, Mid shift (-0.000, +0.000), fit by pad numbers (2 pads), every LCSC pad centre on a board pad (worst centre offset 0.050 mm), pad numbers / functions match mark->pad 1
PASS C17 C14663 C0603: KiCad 0 + offset 0 = CPL 0, Mid shift (+0.000, +0.000), fit by pad numbers (2 pads), every LCSC pad centre on a board pad (worst centre offset 0.075 mm), pad numbers / functions match mark->pad 1
PASS C18 C1525 C0402: KiCad 180 + offset 0 = CPL 180, Mid shift (-0.000, -0.000), fit by pad numbers (2 pads), every LCSC pad centre on a board pad (worst centre offset 0.060 mm), pad numbers / functions match mark->pad 1
PASS C19 C1525 C0402: KiCad 180 + offset 0 = CPL 180, Mid shift (-0.000, -0.000), fit by pad numbers (2 pads), every LCSC pad centre on a board pad (worst centre offset 0.060 mm), pad numbers / functions match mark->pad 1
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
PASS C65 C1588 C0603: KiCad 0 + offset 0 = CPL 0, Mid shift (+0.000, +0.000), fit by pad numbers (2 pads), every LCSC pad centre on a board pad (worst centre offset 0.075 mm), pad numbers / functions match mark->pad 1
PASS C66 C1588 C0603: KiCad 0 + offset 0 = CPL 0, Mid shift (-0.000, +0.000), fit by pad numbers (2 pads), every LCSC pad centre on a board pad (worst centre offset 0.075 mm), pad numbers / functions match mark->pad 1
PASS C67 C1588 C0603: KiCad 0 + offset 0 = CPL 0, Mid shift (+0.000, +0.000), fit by pad numbers (2 pads), every LCSC pad centre on a board pad (worst centre offset 0.075 mm), pad numbers / functions match mark->pad 1
PASS C68 C1588 C0603: KiCad 0 + offset 0 = CPL 0, Mid shift (+0.000, +0.000), fit by pad numbers (2 pads), every LCSC pad centre on a board pad (worst centre offset 0.075 mm), pad numbers / functions match mark->pad 1
PASS C69 C1588 C0603: KiCad 0 + offset 0 = CPL 0, Mid shift (+0.000, +0.000), fit by pad numbers (2 pads), every LCSC pad centre on a board pad (worst centre offset 0.075 mm), pad numbers / functions match mark->pad 1
PASS C70 C1588 C0603: KiCad 0 + offset 0 = CPL 0, Mid shift (+0.000, +0.000), fit by pad numbers (2 pads), every LCSC pad centre on a board pad (worst centre offset 0.075 mm), pad numbers / functions match mark->pad 1
PASS C71 C1588 C0603: KiCad 0 + offset 0 = CPL 0, Mid shift (+0.000, +0.000), fit by pad numbers (2 pads), every LCSC pad centre on a board pad (worst centre offset 0.075 mm), pad numbers / functions match mark->pad 1
PASS C72 C14663 C0603: KiCad 180 + offset 0 = CPL 180, Mid shift (-0.000, -0.000), fit by pad numbers (2 pads), every LCSC pad centre on a board pad (worst centre offset 0.075 mm), pad numbers / functions match mark->pad 1
PASS C73 C14663 C0603: KiCad 180 + offset 0 = CPL 180, Mid shift (-0.000, -0.000), fit by pad numbers (2 pads), every LCSC pad centre on a board pad (worst centre offset 0.075 mm), pad numbers / functions match mark->pad 1
PASS D1 C83333 SMB_L4.6-W3.6-LS5.3-RD: KiCad 90 + offset 0 = CPL 90, Mid shift (+0.000, +0.000), fit by pad numbers (2 pads), every LCSC pad centre on a board pad (worst centre offset 0.211 mm), pad numbers / functions match polarity by dot rule (LCSC pins unnamed): dot on LCSC pad 1 (unnamed) -> our pad 1 (cathode, +5V_IN)
PASS D2 C2286 LED-SMD_L1.6-W0.8-R-RD: KiCad 0 + offset 0 = CPL 0, Mid shift (-0.000, +0.000), fit by polarity names (2 pads), every LCSC pad centre on a board pad (worst centre offset 0.037 mm), pad numbers / functions match polarity by pin names: LCSC A -> our anode net, K -> our cathode net; dot on LCSC pad 1 (anode) -> our pad 2 (anode, LED_FAULT_A)
PASS D3 C12624 LED0603-RD: KiCad 0 + offset 0 = CPL 0, Mid shift (+0.000, +0.000), fit by polarity names (2 pads), every LCSC pad centre on a board pad (worst centre offset 0.039 mm), pad numbers / functions match polarity by pin names: LCSC A -> our anode net, K -> our cathode net; dot on LCSC pad 1 (cathode) -> our pad 1 (cathode, GND)
PASS D4 C84268 LED0603-RD: KiCad 0 + offset 0 = CPL 0, Mid shift (+0.000, +0.000), fit by polarity names (2 pads), every LCSC pad centre on a board pad (worst centre offset 0.039 mm), pad numbers / functions match polarity by pin names: LCSC A -> our anode net, K -> our cathode net; dot on LCSC pad 1 (cathode) -> our pad 1 (cathode, GND)
PASS D5 C12624 LED0603-RD: KiCad 0 + offset 0 = CPL 0, Mid shift (+0.000, +0.000), fit by polarity names (2 pads), every LCSC pad centre on a board pad (worst centre offset 0.039 mm), pad numbers / functions match polarity by pin names: LCSC A -> our anode net, K -> our cathode net; dot on LCSC pad 1 (cathode) -> our pad 1 (cathode, GND)
PASS F1 C207091 F2920: KiCad 270 + offset 0 = CPL 270, Mid shift (-0.000, -0.000), fit by pad numbers (2 pads), every LCSC pad centre on a board pad (worst centre offset 0.088 mm), pad numbers / functions match mark->pad 1
PASS F2 C127824 F1812: KiCad 270 + offset 0 = CPL 270, Mid shift (+0.000, -0.000), fit by pad numbers (2 pads), every LCSC pad centre on a board pad (worst centre offset 0.284 mm), pad numbers / functions match mark->pad 1
PASS F3 C75464 F1206: KiCad 0 + offset 0 = CPL 0, Mid shift (+0.000, +0.000), fit by pad numbers (2 pads), every LCSC pad centre on a board pad (worst centre offset 0.045 mm), pad numbers / functions match mark->pad 1
PASS FB1 C1017 L0805: KiCad 0 + offset 0 = CPL 0, Mid shift (-0.000, +0.000), fit by pad numbers (2 pads), every LCSC pad centre on a board pad (worst centre offset 0.096 mm), pad numbers / functions match mark->pad 1
PASS FB2 C85840 L0805: KiCad 0 + offset 0 = CPL 0, Mid shift (-0.000, +0.000), fit by pad numbers (2 pads), every LCSC pad centre on a board pad (worst centre offset 0.096 mm), pad numbers / functions match mark->pad 1
PASS FB3 C85840 L0805: KiCad 0 + offset 0 = CPL 0, Mid shift (-0.000, +0.000), fit by pad numbers (2 pads), every LCSC pad centre on a board pad (worst centre offset 0.096 mm), pad numbers / functions match mark->pad 1
PASS J1 C505179 CONN-TH_39303035: KiCad 0 + offset 180 = CPL 180, Mid shift (+4.200, +0.000), fit by pad numbers (3 pads), every LCSC pad centre on a board pad (worst centre offset 0.000 mm), pad numbers / functions match mark->pad 1
PASS J2 C160389 CONN-SMD-3P-P1.00_BM03B-SRSS-TB-LF-SN: KiCad 0 + offset 180 = CPL 180, Mid shift (+0.000, -0.062), fit by pad numbers (3 pads), every LCSC pad centre on a board pad (worst centre offset 0.000 mm), pad numbers / functions match (mechanical / pair pads: 5->MP,4->MP) mark->pad 3
PASS J3 C19724763 RJ45-SMD_HR963380AE: KiCad 0 + offset 0 = CPL 0, Mid shift (-0.000, +0.075), fit by pad numbers (14 pads), every LCSC pad centre on a board pad (worst centre offset 0.000 mm), pad numbers / functions match (mechanical / pair pads: 15->SH) mark->pad 1
PASS J4 C240831 CONN-TH_39-30-0020: KiCad 270 + offset 180 = CPL 90, Mid shift (-2.750, +0.000), fit by pad numbers (2 pads), every LCSC pad centre on a board pad (worst centre offset 0.000 mm), pad numbers / functions match mark->pad 1
PASS J5 C27985193 HDR-TH_9P-P2.54-V-M: KiCad 270 + offset 270 = CPL 180, Mid shift (-10.160, +0.000), fit by pad numbers (9 pads), every LCSC pad centre on a board pad (worst centre offset 0.000 mm), pad numbers / functions match mark->pad 1
PASS J6 C293503 CONN-TH_39281083: KiCad 0 + offset 0 = CPL 0, Mid shift (+6.300, -2.750), fit by pad numbers (8 pads), every LCSC pad centre on a board pad (worst centre offset 0.000 mm), pad numbers / functions match mark->pad 1
PASS J7 C587488 CONN-TH_4P-P4.20_39301049: KiCad 0 + offset 180 = CPL 180, Mid shift (+6.300, +0.000), fit by pad numbers (4 pads), every LCSC pad centre on a board pad (worst centre offset 0.000 mm), pad numbers / functions match mark->pad 1
PASS J8 C505042 CONN-TH_26604020: KiCad 90 + offset 180 = CPL 270, Mid shift (+0.000, +1.980), fit by pad numbers (2 pads), every LCSC pad centre on a board pad (worst centre offset 0.000 mm), pad numbers / functions match mark->pad 1
PASS J9 C132563 MICRO-USB-SMD_10118194-0001LF: KiCad 180 + offset 0 = CPL 180, Mid shift (-0.000, -0.050), fit by pad numbers (5 pads), every LCSC pad centre on a board pad (worst centre offset 0.000 mm), pad numbers / functions match (mechanical / pair pads: 6->SH,6->SH,6->SH,6->SH) mark->pad SH
CONFIRM J10 C22464480: no LCSC footprint (JLC has none) -> body centre (108.500, -61.000) / KiCad rotation 0; check in JLC's placement preview
CONFIRM J21 C588833: no LCSC footprint (JLC has none) -> body centre (16.310, -78.055) / KiCad rotation 0; check in JLC's placement preview
CONFIRM J22 C588833: no LCSC footprint (JLC has none) -> body centre (28.310, -78.055) / KiCad rotation 0; check in JLC's placement preview
CONFIRM J23 C588833: no LCSC footprint (JLC has none) -> body centre (40.270, -78.055) / KiCad rotation 0; check in JLC's placement preview
CONFIRM J24 C588833: no LCSC footprint (JLC has none) -> body centre (52.330, -78.055) / KiCad rotation 0; check in JLC's placement preview
CONFIRM J25 C588833: no LCSC footprint (JLC has none) -> body centre (64.360, -78.055) / KiCad rotation 0; check in JLC's placement preview
CONFIRM J26 C588833: no LCSC footprint (JLC has none) -> body centre (76.430, -78.055) / KiCad rotation 0; check in JLC's placement preview
CONFIRM J27 C588833: no LCSC footprint (JLC has none) -> body centre (88.440, -78.055) / KiCad rotation 0; check in JLC's placement preview
CONFIRM J28 C588833: no LCSC footprint (JLC has none) -> body centre (100.490, -78.055) / KiCad rotation 0; check in JLC's placement preview
PASS L1 C36409 IND-SMD_L4.0-W4.0_LQH44PN2R2MP0L: KiCad 0 + offset 0 = CPL 0, Mid shift (+0.000, +0.000), fit by pad numbers (2 pads), every LCSC pad centre on a board pad (worst centre offset 0.300 mm), pad numbers / functions match mark->pad 1
PASS Q1 C43307 SOT-23-3_L2.9-W1.6-P1.90-LS2.8-BR: KiCad 180 + offset 180 = CPL 0, Mid shift (-0.099, -0.000), fit by pad numbers (3 pads), every LCSC pad centre on a board pad (worst centre offset 0.397 mm), pad numbers / functions match mark->pad 1
PASS Q2 C43307 SOT-23-3_L2.9-W1.6-P1.90-LS2.8-BR: KiCad 180 + offset 180 = CPL 0, Mid shift (-0.099, +0.000), fit by pad numbers (3 pads), every LCSC pad centre on a board pad (worst centre offset 0.397 mm), pad numbers / functions match mark->pad 1
PASS Q3 C43307 SOT-23-3_L2.9-W1.6-P1.90-LS2.8-BR: KiCad 180 + offset 180 = CPL 0, Mid shift (-0.099, +0.000), fit by pad numbers (3 pads), every LCSC pad centre on a board pad (worst centre offset 0.397 mm), pad numbers / functions match mark->pad 1
PASS Q4 C43307 SOT-23-3_L2.9-W1.6-P1.90-LS2.8-BR: KiCad 180 + offset 180 = CPL 0, Mid shift (-0.099, +0.000), fit by pad numbers (3 pads), every LCSC pad centre on a board pad (worst centre offset 0.397 mm), pad numbers / functions match mark->pad 1
PASS R1 C25803 R0603: KiCad 180 + offset 0 = CPL 180, Mid shift (-0.000, +0.000), fit by pad numbers (2 pads), every LCSC pad centre on a board pad (worst centre offset 0.072 mm), pad numbers / functions match mark->pad 1
PASS R2 C25819 R0603: KiCad 0 + offset 0 = CPL 0, Mid shift (-0.000, +0.000), fit by pad numbers (2 pads), every LCSC pad centre on a board pad (worst centre offset 0.072 mm), pad numbers / functions match mark->pad 1
PASS R3 C23228 R0603: KiCad 180 + offset 0 = CPL 180, Mid shift (-0.000, +0.000), fit by pad numbers (2 pads), every LCSC pad centre on a board pad (worst centre offset 0.072 mm), pad numbers / functions match mark->pad 1
PASS R4 C21190 R0603: KiCad 0 + offset 0 = CPL 0, Mid shift (+0.000, +0.000), fit by pad numbers (2 pads), every LCSC pad centre on a board pad (worst centre offset 0.072 mm), pad numbers / functions match mark->pad 1
PASS R5 C25803 R0603: KiCad 0 + offset 0 = CPL 0, Mid shift (+0.000, +0.000), fit by pad numbers (2 pads), every LCSC pad centre on a board pad (worst centre offset 0.072 mm), pad numbers / functions match mark->pad 1
PASS R6 C31850 R0603: KiCad 270 + offset 0 = CPL 270, Mid shift (-0.000, +0.000), fit by pad numbers (2 pads), every LCSC pad centre on a board pad (worst centre offset 0.072 mm), pad numbers / functions match mark->pad 1
PASS R7 C23184 R0603: KiCad 90 + offset 0 = CPL 90, Mid shift (+0.000, +0.000), fit by pad numbers (2 pads), every LCSC pad centre on a board pad (worst centre offset 0.072 mm), pad numbers / functions match mark->pad 1
PASS R8 C25803 R0603: KiCad 0 + offset 0 = CPL 0, Mid shift (+0.000, +0.000), fit by pad numbers (2 pads), every LCSC pad centre on a board pad (worst centre offset 0.072 mm), pad numbers / functions match mark->pad 1
PASS R9 C25819 R0603: KiCad 0 + offset 0 = CPL 0, Mid shift (+0.000, +0.000), fit by pad numbers (2 pads), every LCSC pad centre on a board pad (worst centre offset 0.072 mm), pad numbers / functions match mark->pad 1
PASS R10 C21190 R0603: KiCad 0 + offset 0 = CPL 0, Mid shift (+0.000, +0.000), fit by pad numbers (2 pads), every LCSC pad centre on a board pad (worst centre offset 0.072 mm), pad numbers / functions match mark->pad 1
PASS R11 C22843 R0603: KiCad 0 + offset 0 = CPL 0, Mid shift (+0.000, +0.000), fit by pad numbers (2 pads), every LCSC pad centre on a board pad (worst centre offset 0.072 mm), pad numbers / functions match mark->pad 1
PASS R12 C11702 R0402: KiCad 90 + offset 0 = CPL 90, Mid shift (+0.000, +0.000), fit by pad numbers (2 pads), every LCSC pad centre on a board pad (worst centre offset 0.077 mm), pad numbers / functions match mark->pad 1
PASS R13 C11702 R0402: KiCad 90 + offset 0 = CPL 90, Mid shift (+0.000, -0.000), fit by pad numbers (2 pads), every LCSC pad centre on a board pad (worst centre offset 0.077 mm), pad numbers / functions match mark->pad 1
PASS R14 C11702 R0402: KiCad 0 + offset 0 = CPL 0, Mid shift (-0.000, +0.000), fit by pad numbers (2 pads), every LCSC pad centre on a board pad (worst centre offset 0.077 mm), pad numbers / functions match mark->pad 1
PASS R15 C25076 R0402: KiCad 0 + offset 0 = CPL 0, Mid shift (+0.000, +0.000), fit by pad numbers (2 pads), every LCSC pad centre on a board pad (worst centre offset 0.077 mm), pad numbers / functions match mark->pad 1
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
PASS R74 C25190 R0603: KiCad 180 + offset 0 = CPL 180, Mid shift (-0.000, +0.000), fit by pad numbers (2 pads), every LCSC pad centre on a board pad (worst centre offset 0.072 mm), pad numbers / functions match mark->pad 1
PASS R75 C25190 R0603: KiCad 270 + offset 0 = CPL 270, Mid shift (+0.000, -0.000), fit by pad numbers (2 pads), every LCSC pad centre on a board pad (worst centre offset 0.072 mm), pad numbers / functions match mark->pad 1
PASS R76 C23186 R0603: KiCad 90 + offset 0 = CPL 90, Mid shift (+0.000, +0.000), fit by pad numbers (2 pads), every LCSC pad centre on a board pad (worst centre offset 0.072 mm), pad numbers / functions match mark->pad 1
PASS R77 C23186 R0603: KiCad 270 + offset 0 = CPL 270, Mid shift (-0.000, +0.000), fit by pad numbers (2 pads), every LCSC pad centre on a board pad (worst centre offset 0.072 mm), pad numbers / functions match mark->pad 1
PASS R78 C22775 R0603: KiCad 180 + offset 0 = CPL 180, Mid shift (-0.000, +0.000), fit by pad numbers (2 pads), every LCSC pad centre on a board pad (worst centre offset 0.072 mm), pad numbers / functions match mark->pad 1
PASS R79 C22775 R0603: KiCad 0 + offset 0 = CPL 0, Mid shift (+0.000, +0.000), fit by pad numbers (2 pads), every LCSC pad centre on a board pad (worst centre offset 0.072 mm), pad numbers / functions match mark->pad 1
PASS R80 C23162 R0603: KiCad 0 + offset 0 = CPL 0, Mid shift (+0.000, +0.000), fit by pad numbers (2 pads), every LCSC pad centre on a board pad (worst centre offset 0.072 mm), pad numbers / functions match mark->pad 1
PASS R81 C25804 R0603: KiCad 0 + offset 0 = CPL 0, Mid shift (+0.000, +0.000), fit by pad numbers (2 pads), every LCSC pad centre on a board pad (worst centre offset 0.072 mm), pad numbers / functions match mark->pad 1
PASS R82 C25804 R0603: KiCad 0 + offset 0 = CPL 0, Mid shift (+0.000, +0.000), fit by pad numbers (2 pads), every LCSC pad centre on a board pad (worst centre offset 0.072 mm), pad numbers / functions match mark->pad 1
PASS SW1 C318884 SW-SMD_4P-L5.1-W5.1-P3.70-LS6.5-TL_H1.5: KiCad 0 + offset 0 = CPL 0, Mid shift (+0.000, +0.000), fit by geometry (centroid, nearest pads) (4 pads), every LCSC pad centre on a board pad (worst centre offset 0.025 mm), pad numbers / functions match (mechanical / pair pads: 2->1,3->2,4->2) mark->pad 1
PASS SW2 C318884 SW-SMD_4P-L5.1-W5.1-P3.70-LS6.5-TL_H1.5: KiCad 0 + offset 0 = CPL 0, Mid shift (+0.000, +0.000), fit by geometry (centroid, nearest pads) (4 pads), every LCSC pad centre on a board pad (worst centre offset 0.025 mm), pad numbers / functions match (mechanical / pair pads: 2->1,3->2,4->2) mark->pad 1
PASS SW3 C319038 SW-SMD_8P-L10.2-W6.0-P2.54_DSIC04LSGET: KiCad 0 + offset 0 = CPL 0, Mid shift (-0.000, +0.000), fit by pad numbers (8 pads), every LCSC pad centre on a board pad (worst centre offset 0.275 mm), pad numbers / functions match mark->pad 1
PASS U1 C2155674 WSON-8_L2.0-W2.0-P0.50-TL-EP: KiCad 180 + offset 0 = CPL 180, Mid shift (+0.000, -0.000), fit by pad numbers (9 pads), every LCSC pad centre on a board pad (worst centre offset 0.000 mm), pad numbers / functions match mark->pad 1
PASS U2 C141836 SOT-23-5_L3.0-W1.7-P0.95-LS2.8-BR: KiCad 180 + offset 180 = CPL 0, Mid shift (-0.033, -0.000), fit by pad numbers (5 pads), every LCSC pad centre on a board pad (worst centre offset 0.195 mm), pad numbers / functions match mark->pad 1
PASS U3 C485147 SOT-23-5_L3.0-W1.7-P0.95-LS2.8-BL: KiCad 0 + offset 270 = CPL 270, Mid shift (+0.003, -0.000), fit by pad numbers (5 pads), every LCSC pad centre on a board pad (worst centre offset 0.019 mm), pad numbers / functions match mark->pad 1
PASS U4 C55266 SOT-23-6_L2.9-W1.6-P0.95-LS2.8-BR: KiCad 0 + offset 180 = CPL 180, Mid shift (+0.000, +0.000), fit by pad numbers (6 pads), every LCSC pad centre on a board pad (worst centre offset 0.213 mm), pad numbers / functions match mark->pad 1
PASS U5 C42415655 QFN-80_L10.0-W10.0-P0.40-TL-EP3.4: KiCad 0 + offset 0 = CPL 0, Mid shift (+0.000, +0.000), fit by pad numbers (81 pads), every LCSC pad centre on a board pad (worst centre offset 0.042 mm), pad numbers / functions match mark->pad 1
PASS U6 C97521 SOIC-8_L5.3-W5.3-P1.27-LS8.0-BL: KiCad 90 + offset 270 = CPL 0, Mid shift (+0.000, +0.000), fit by pad numbers (8 pads), every LCSC pad centre on a board pad (worst centre offset 0.057 mm), pad numbers / functions match mark->pad 1
PASS U7 C32843 LQFP-48_L7.0-W7.0-P0.50-LS9.0-BL: KiCad 270 + offset 270 = CPL 180, Mid shift (-0.000, -0.000), fit by pad numbers (48 pads), every LCSC pad centre on a board pad (worst centre offset 0.087 mm), pad numbers / functions match mark->pad 1
PASS U8 C910544 TQFN-16_L3.0-W3.0-P0.50-BL-EP1.5: KiCad 0 + offset 270 = CPL 270, Mid shift (-0.001, +0.000), fit by pad numbers (17 pads), every LCSC pad centre on a board pad (worst centre offset 0.063 mm), pad numbers / functions match mark->pad 1
PASS U9 C6650 SOT-23-6_L2.9-W1.6-P0.95-LS2.8-BR: KiCad 0 + offset 180 = CPL 180, Mid shift (+0.000, +0.000), fit by pad numbers (6 pads), every LCSC pad centre on a board pad (worst centre offset 0.213 mm), pad numbers / functions match mark->pad 1
PASS U10 C6650 SOT-23-6_L2.9-W1.6-P0.95-LS2.8-BR: KiCad 0 + offset 180 = CPL 180, Mid shift (+0.000, +0.000), fit by pad numbers (6 pads), every LCSC pad centre on a board pad (worst centre offset 0.213 mm), pad numbers / functions match mark->pad 1
PASS U11 C6650 SOT-23-6_L2.9-W1.6-P0.95-LS2.8-BR: KiCad 0 + offset 180 = CPL 180, Mid shift (+0.000, +0.000), fit by pad numbers (6 pads), every LCSC pad centre on a board pad (worst centre offset 0.213 mm), pad numbers / functions match mark->pad 1
PASS U12 C7519 SOT-23-6_L2.9-W1.6-P0.95-LS2.8-BL: KiCad 0 + offset 270 = CPL 270, Mid shift (+0.000, +0.000), fit by pad numbers (6 pads), every LCSC pad centre on a board pad (worst centre offset 0.012 mm), pad numbers / functions match mark->pad 1
PASS U13 C7519 SOT-23-6_L2.9-W1.6-P0.95-LS2.8-BL: KiCad 0 + offset 270 = CPL 270, Mid shift (+0.000, +0.000), fit by pad numbers (6 pads), every LCSC pad centre on a board pad (worst centre offset 0.012 mm), pad numbers / functions match mark->pad 1
PASS U14 C2977777 SOP-8_L4.9-W3.9-P1.27-LS6.0-BL: KiCad 180 + offset 270 = CPL 90, Mid shift (-0.000, +0.000), fit by pad numbers (8 pads), every LCSC pad centre on a board pad (worst centre offset 0.207 mm), pad numbers / functions match mark->pad 1
PASS Y1 C20625731 CRYSTAL-SMD_4P-L3.2-W2.5-BL: KiCad 270 + offset 0 = CPL 270, Mid shift (+0.000, -0.000), fit by pad numbers (4 pads), every LCSC pad centre on a board pad (worst centre offset 0.000 mm), pad numbers / functions match mark->pad 1
PASS Y2 C9006 CRYSTAL-SMD_4P-L3.2-W2.5-BL: KiCad 0 + offset 0 = CPL 0, Mid shift (+0.000, +0.000), fit by pad numbers (4 pads), every LCSC pad centre on a board pad (worst centre offset 0.000 mm), pad numbers / functions match mark->pad 1
