mikenemat/skeeball-premium-re/hardware/renders/schematic/skeeball-controller-schematic.pdf

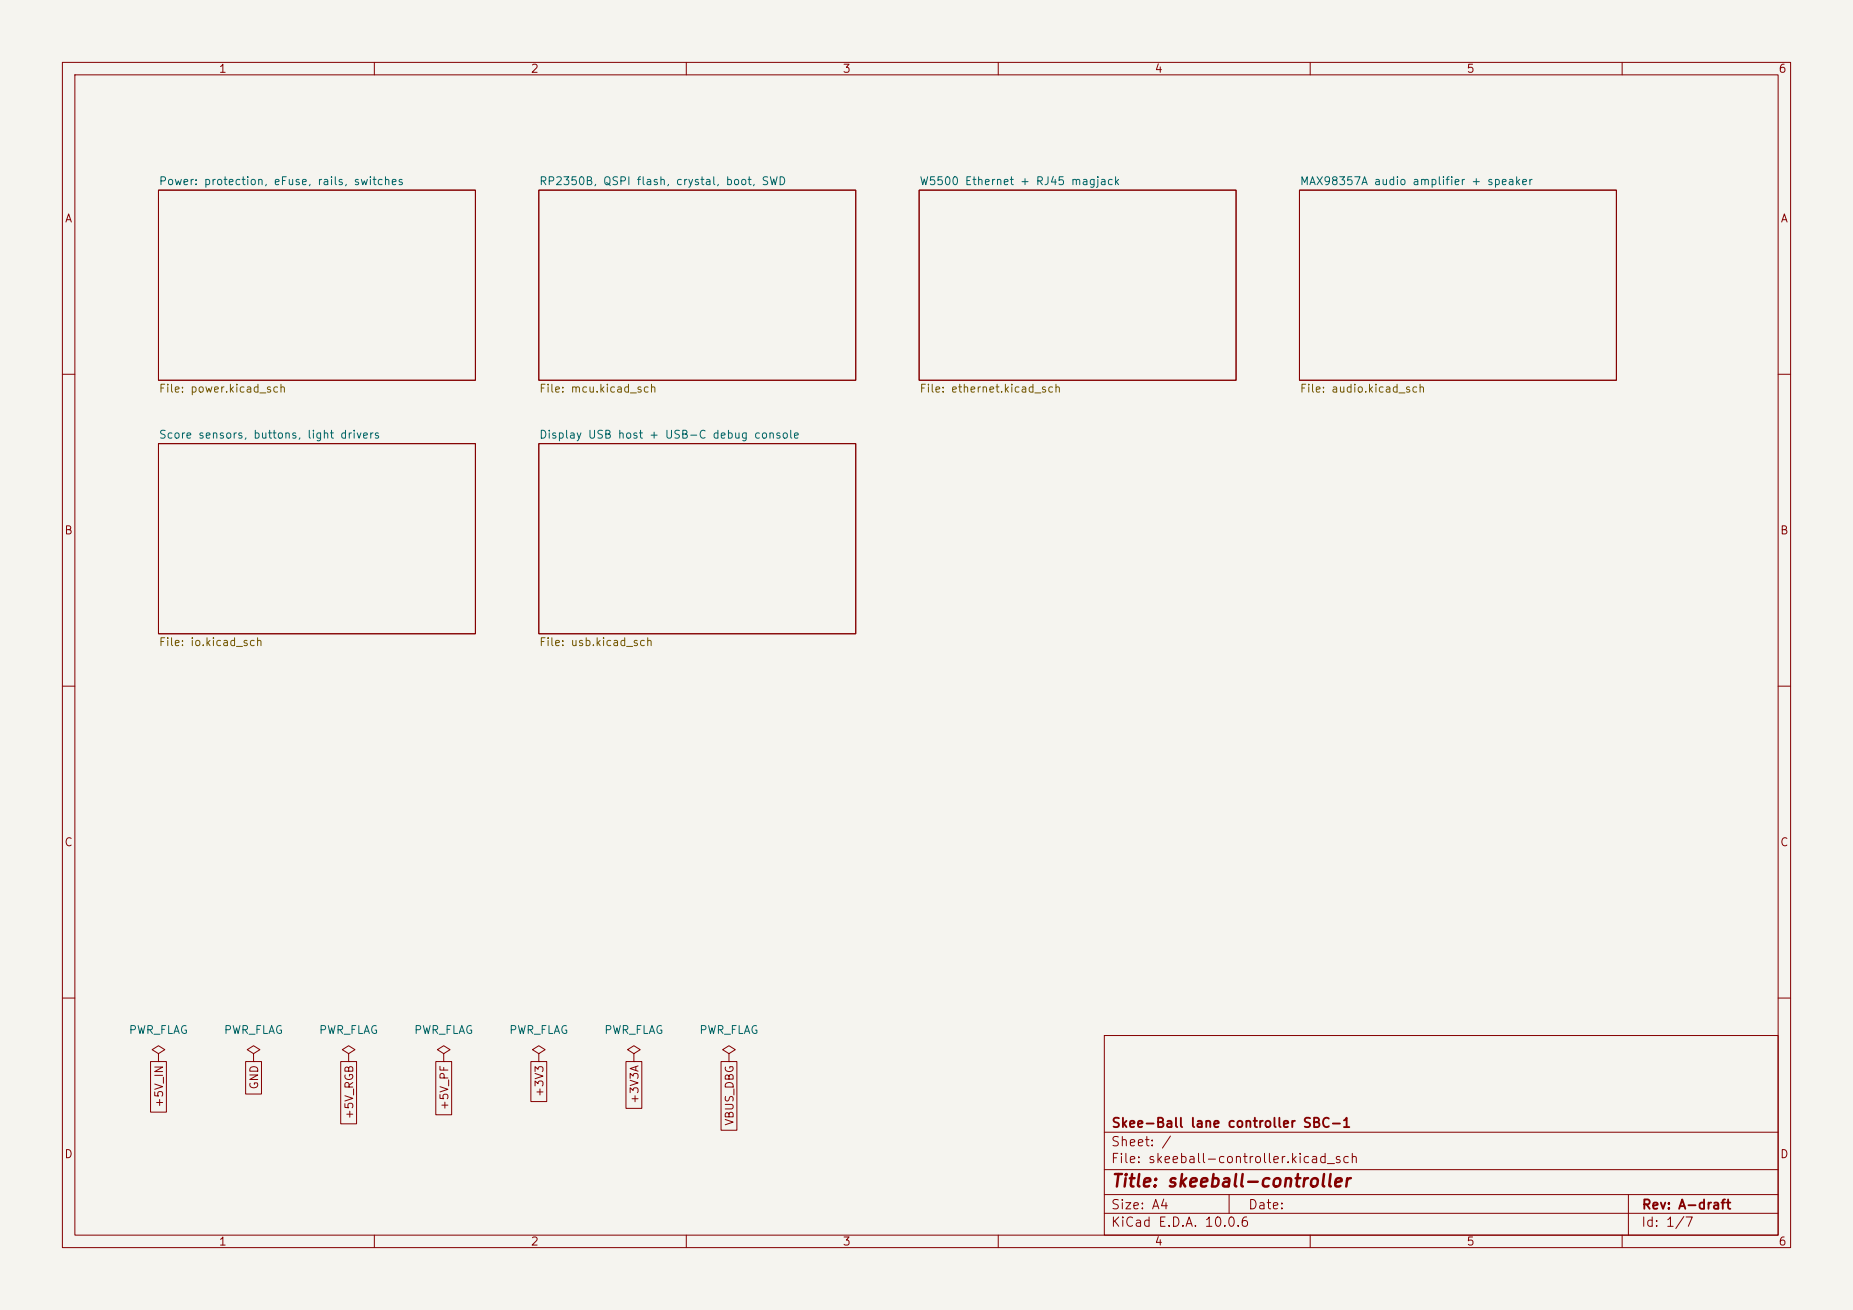
[picture p38: page 1]

RP2350B, QSPI flash, crystal, boot, SWD

Skee-Ball lane controller SBC-1
Sheet: /
File: skeeball-controller.kicad_sch
Title: skeeball-controller

Size: A4 | Rev: A-draft
KiCad E.D.A. 10.0.6 | Id: 1/7

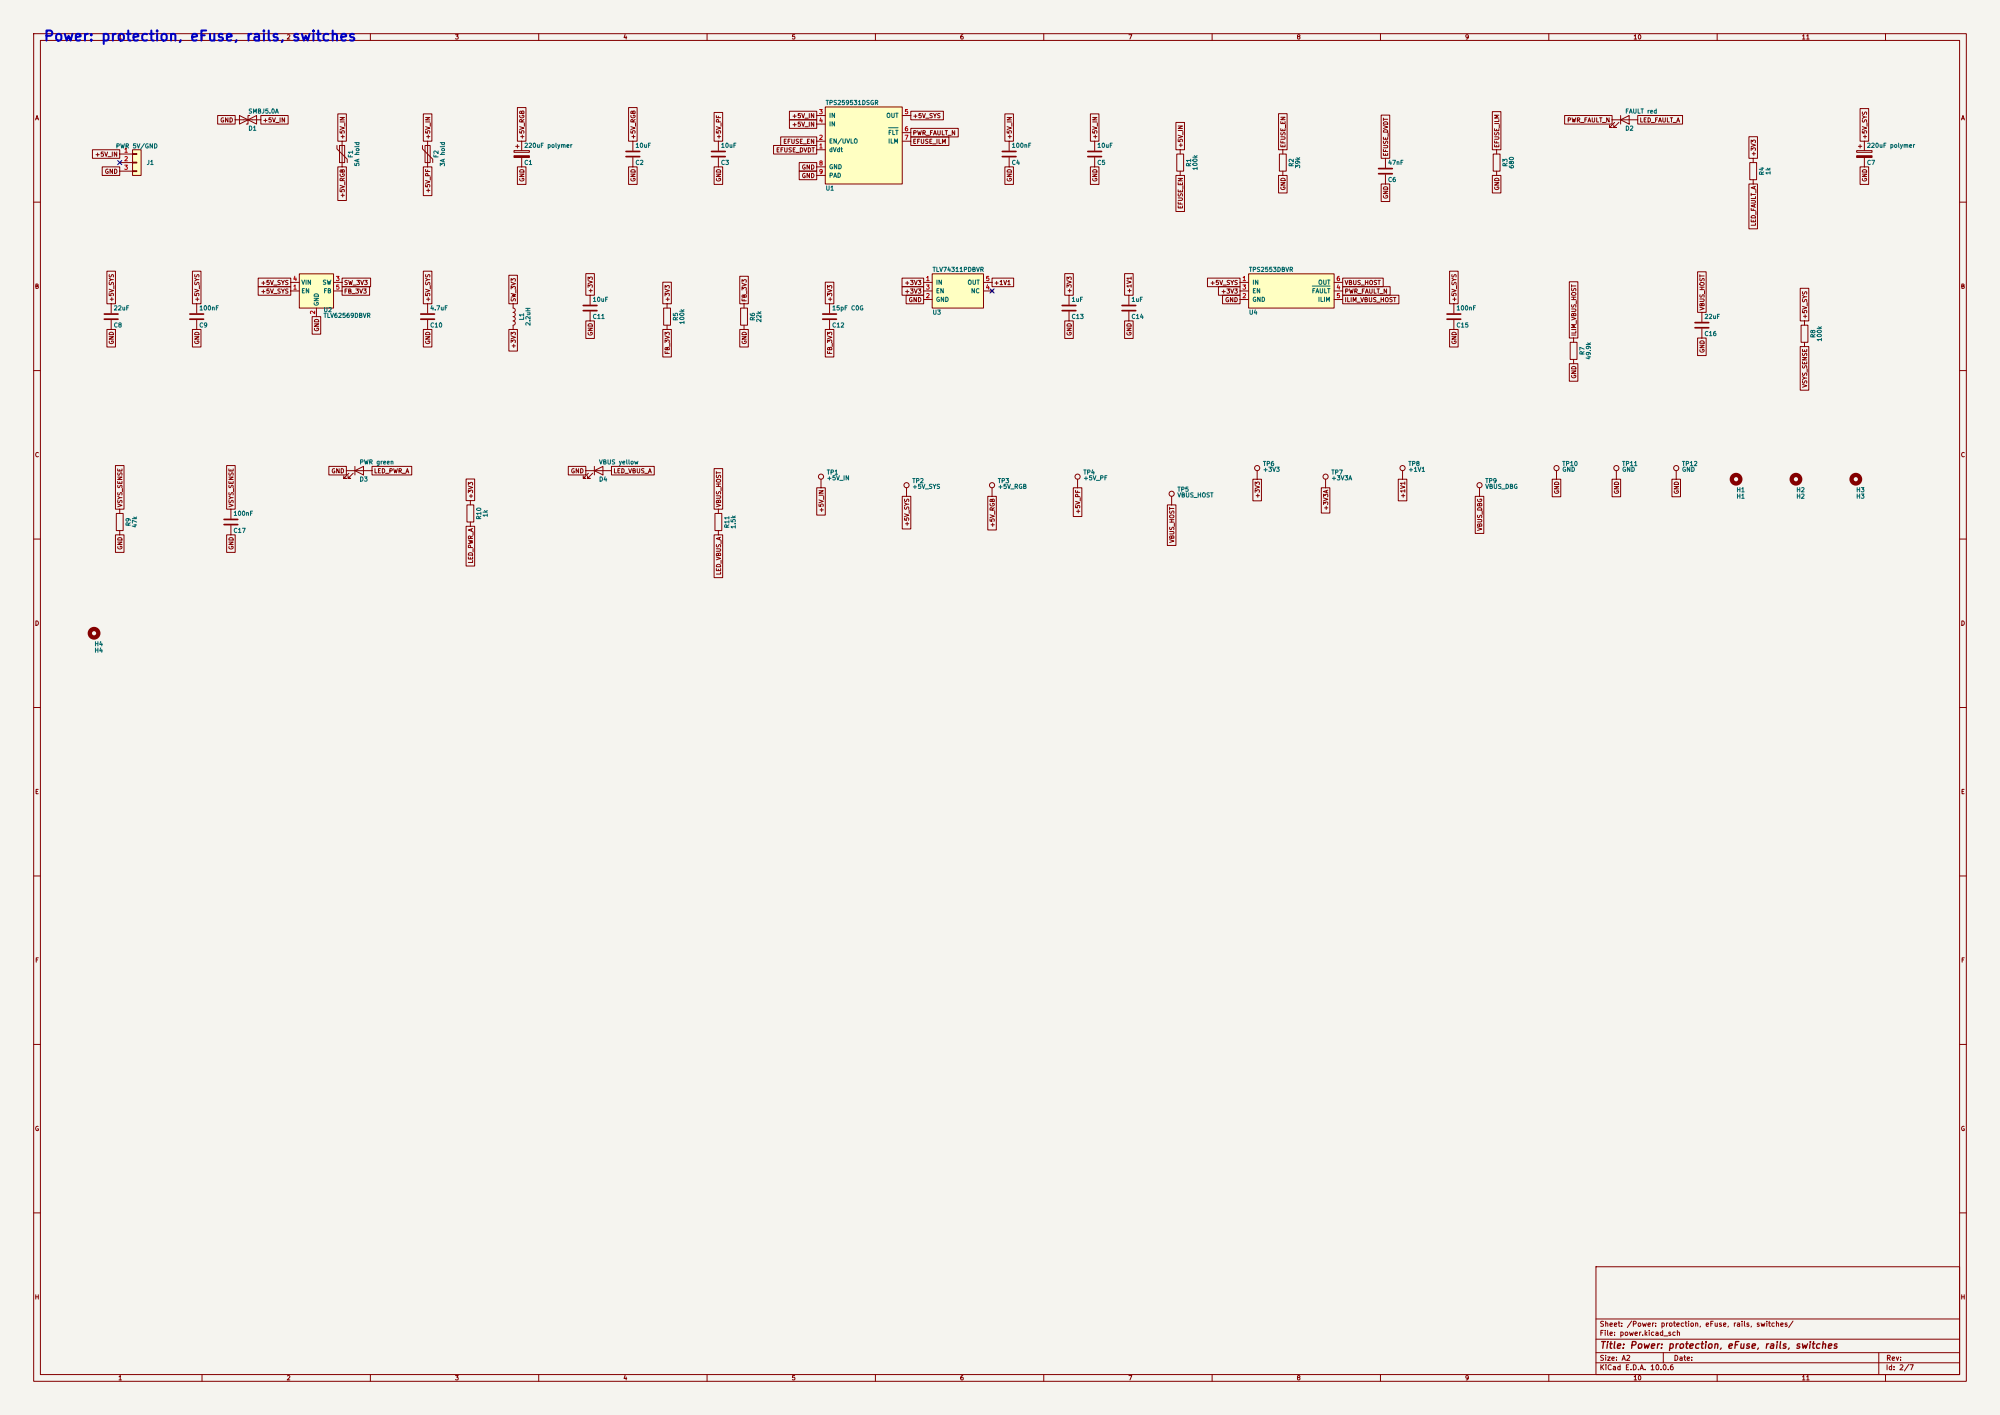
[picture p39: page 2]

Power: protection, eFuse, rails, switches

Sheet: /Power: protection, eFuse, rails, switches/
File: power.kicad_sch
Title: Power: protection, eFuse, rails, switches

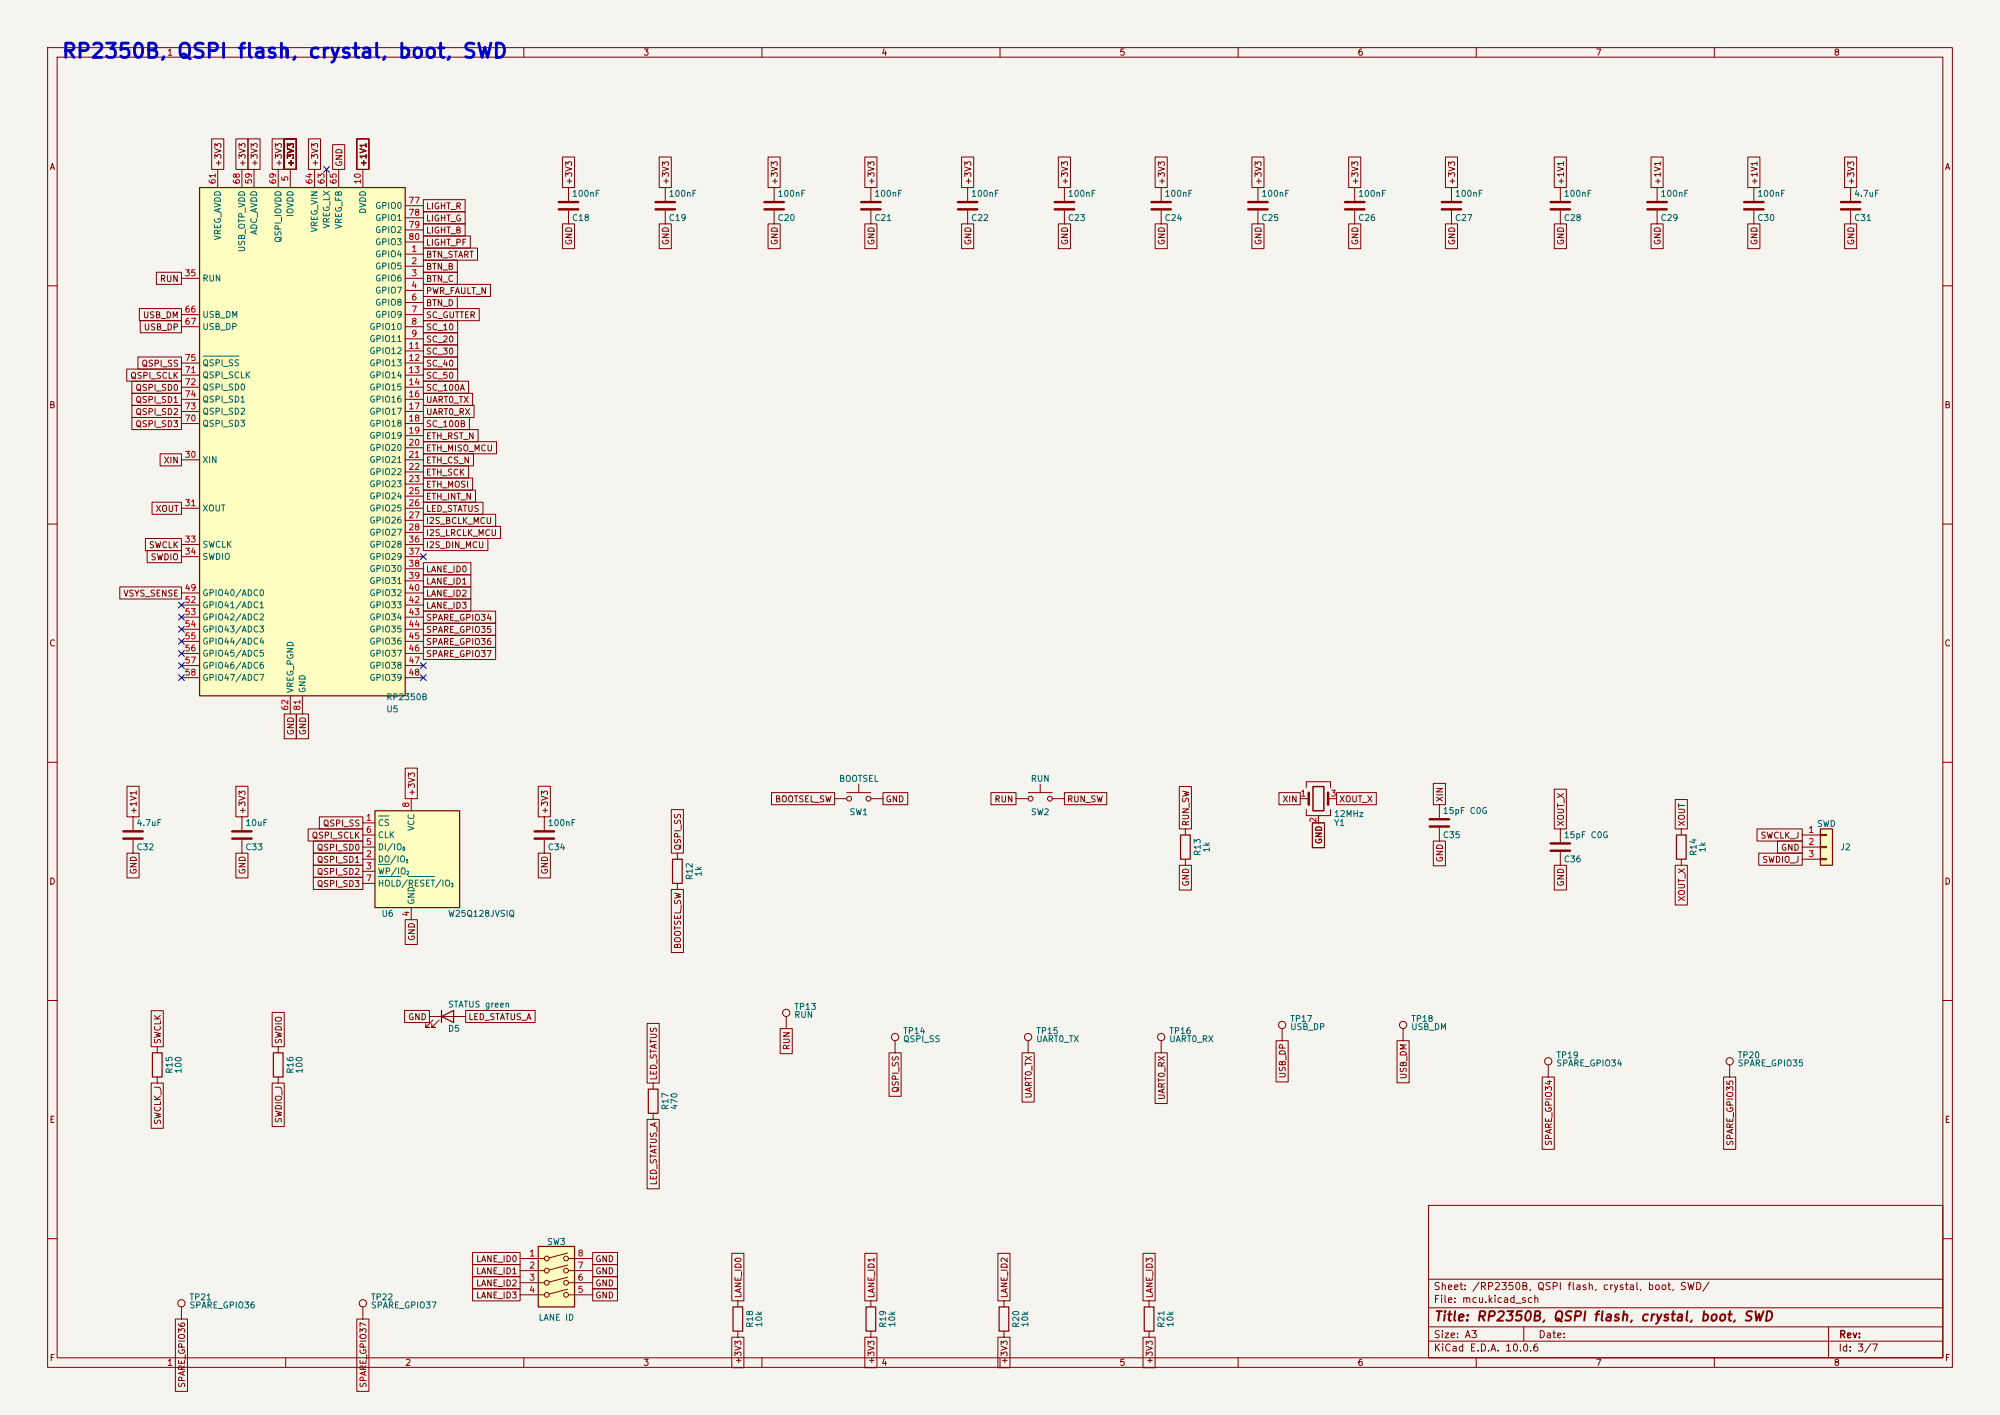
[picture p40: page 3]

RP2350B, QSPI flash, crystal, boot, SWD

4 DI/IO0 5 CLK 6 HOLD/RESET/IO3 7 VCC

Sheet: /RP2350B, QSPI flash, crystal, boot, SWD/
File: mcu.kicad_sch
Title: RP2350B, QSPI flash, crystal, boot, SWD

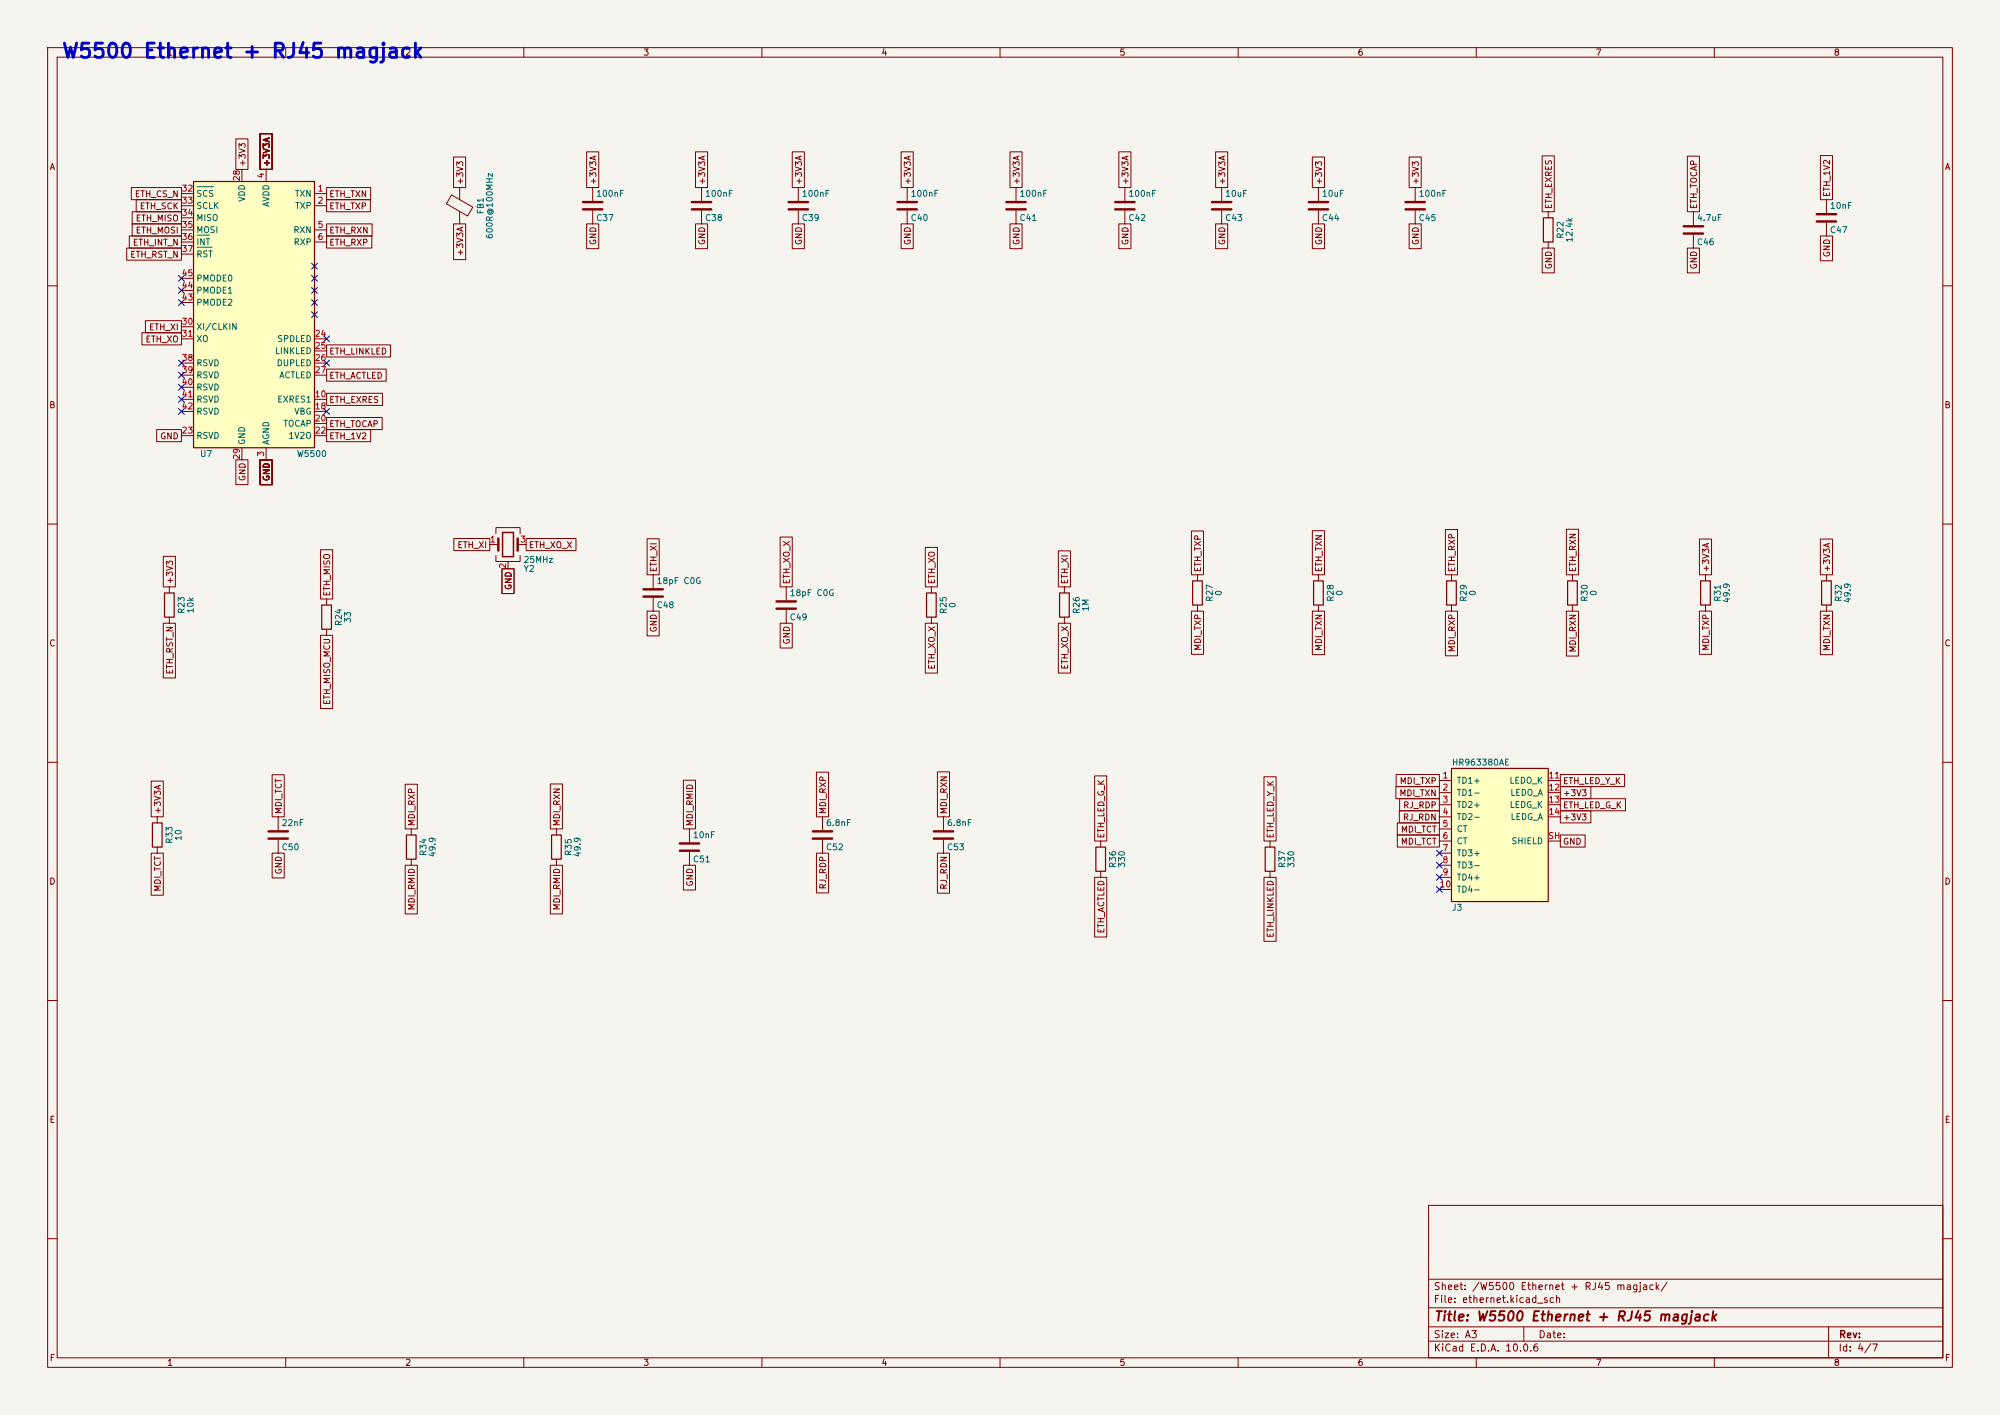
[picture p41: page 4]

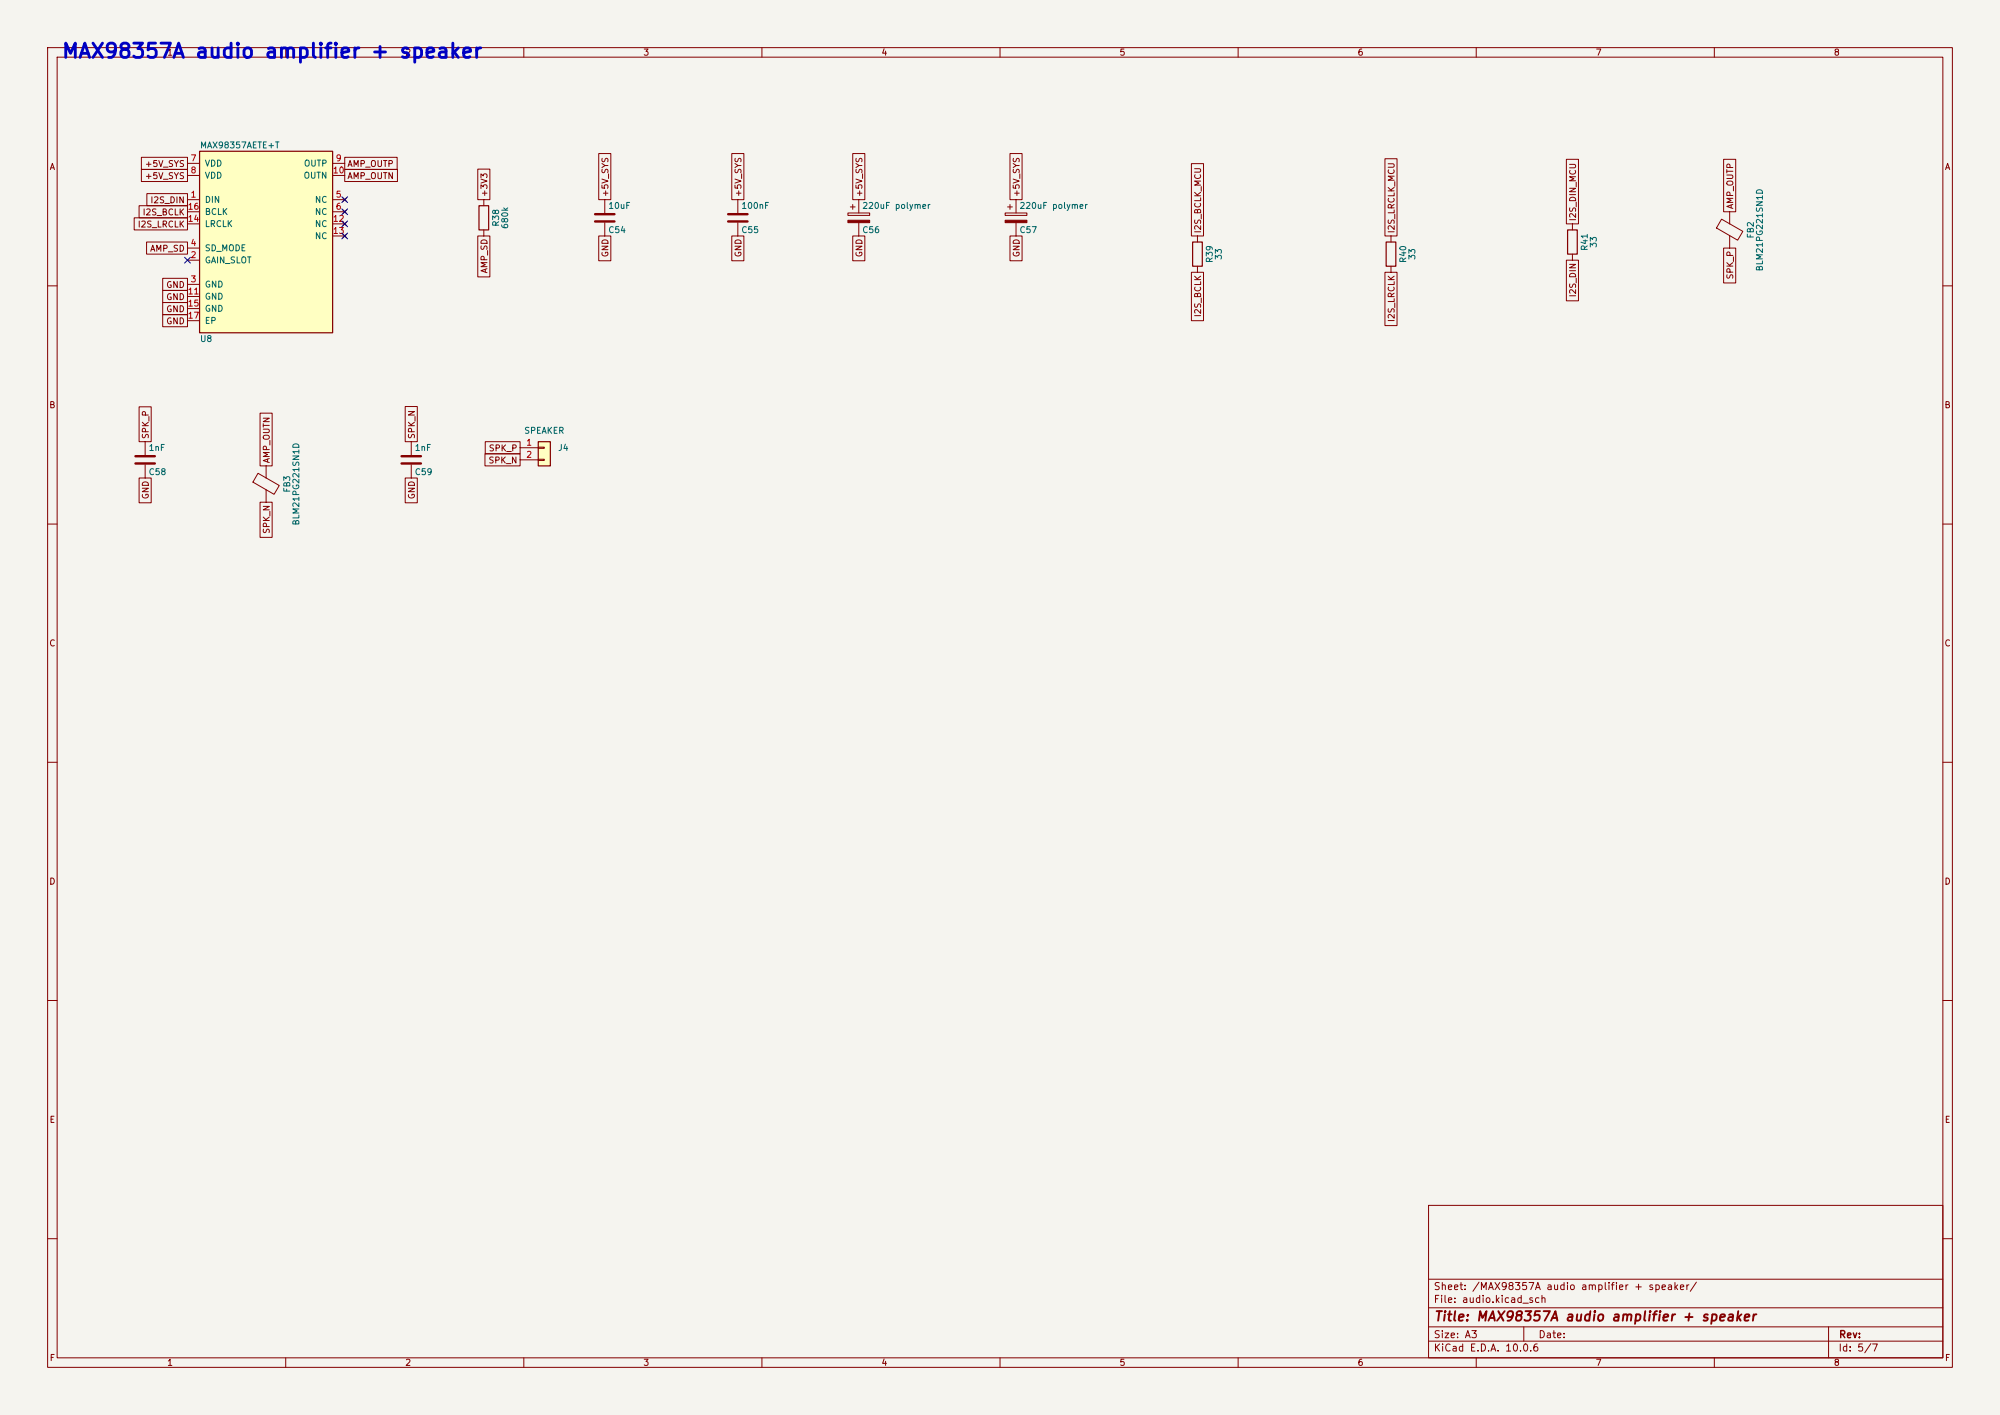
[picture p42: page 5]

Sheet: /MAX98357A audio amplifier + speaker/
File: audio.kicad_sch
Title: MAX98357A audio amplifier + speaker

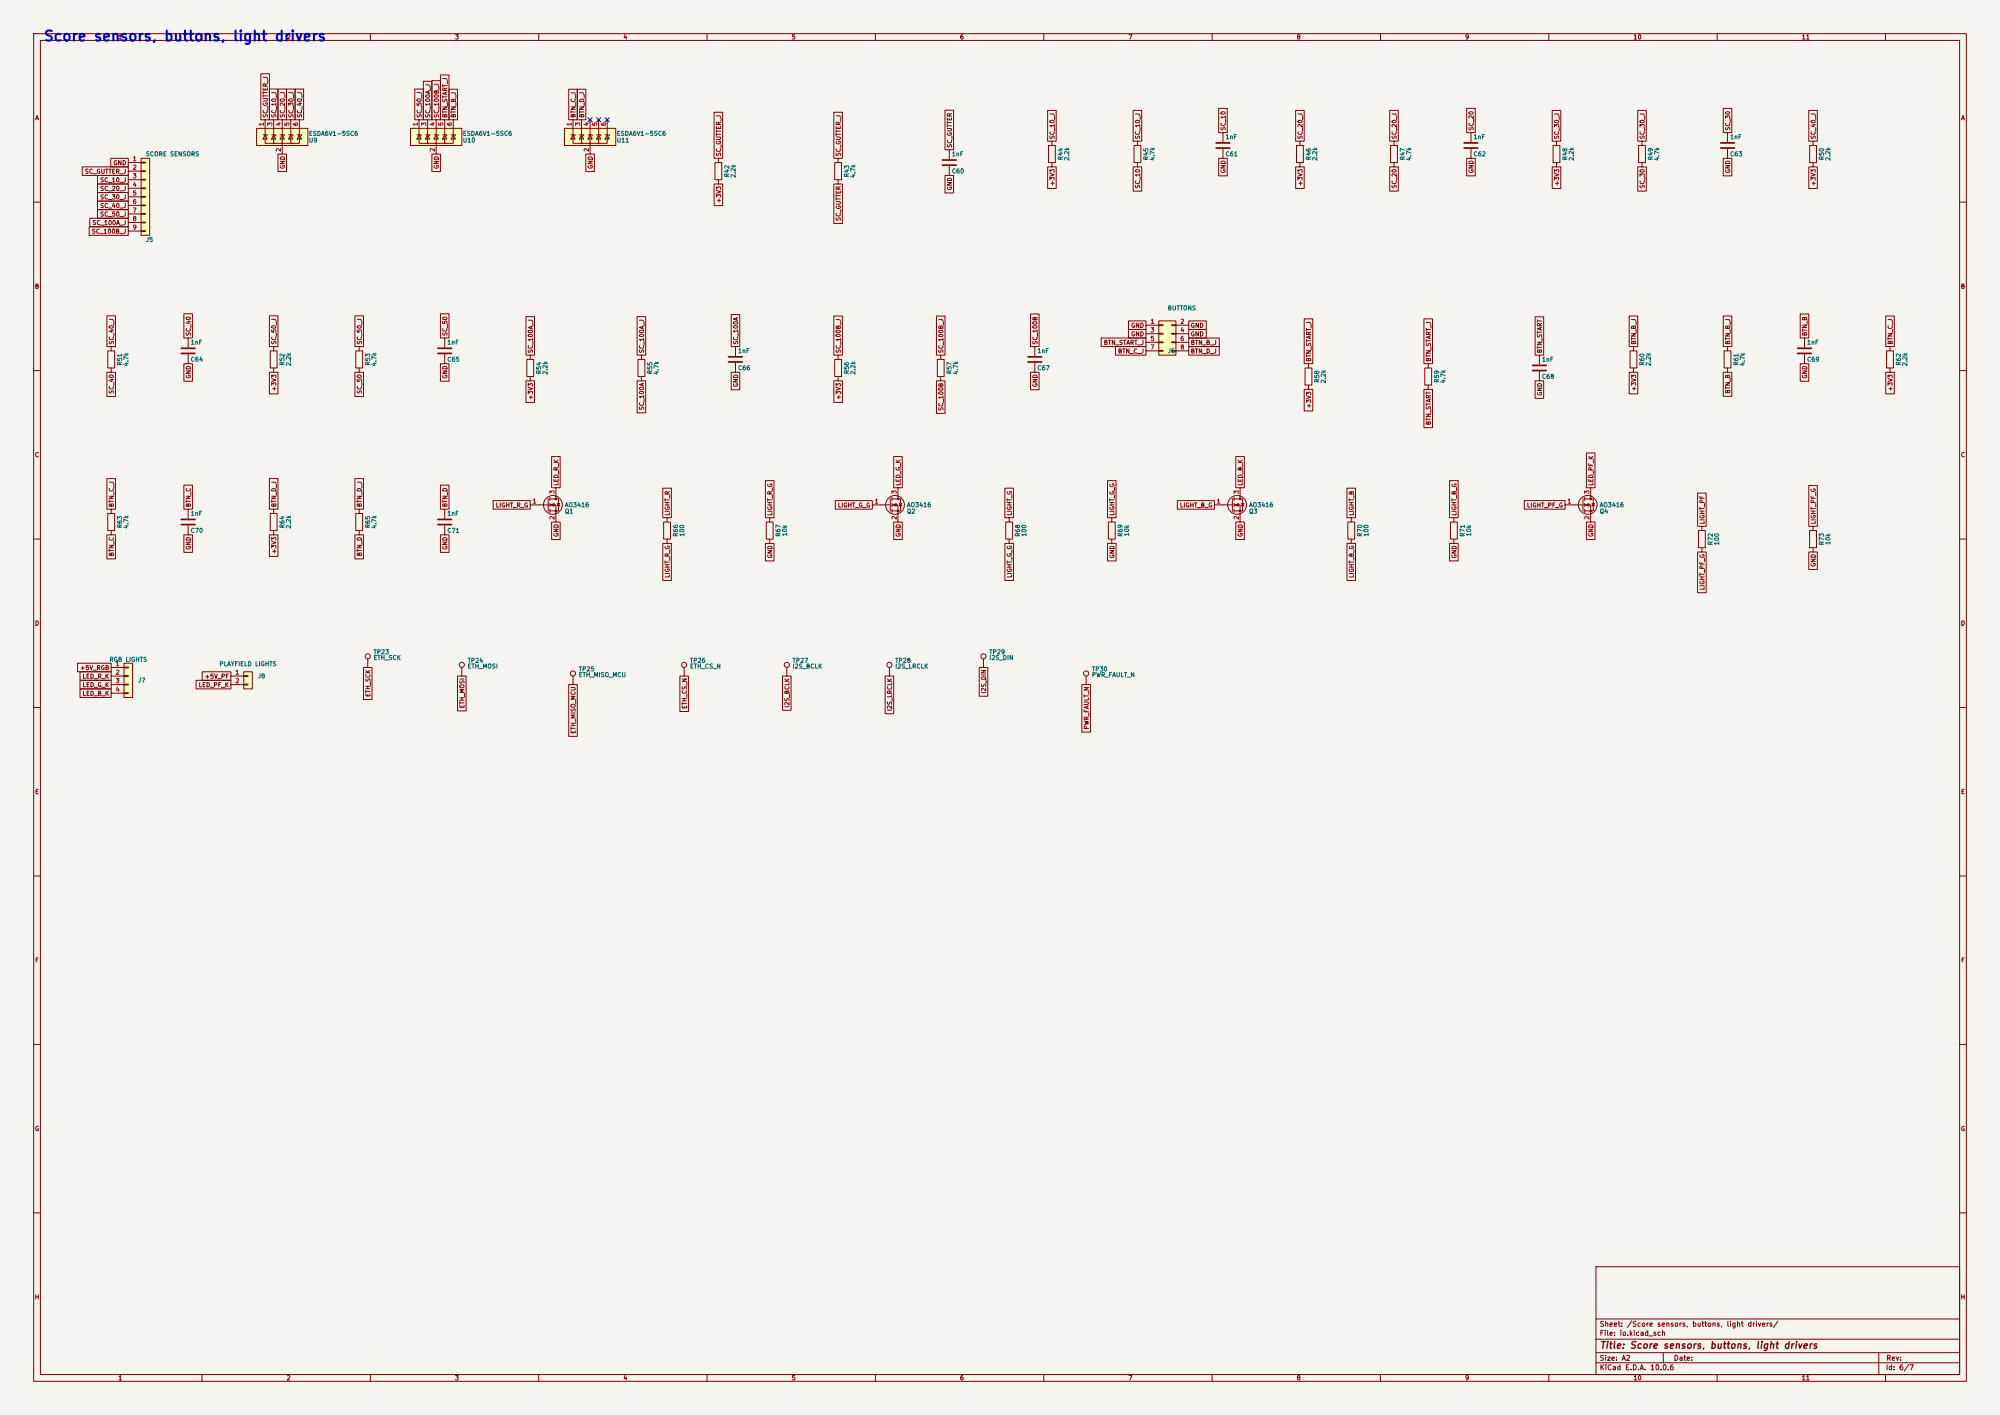
[picture p43: page 6]

Score sensors, buttons, light drivers

Sheet: /Score sensors, buttons, light drivers/
File: io.kicad_sch
Title: Score sensors, buttons, light drivers

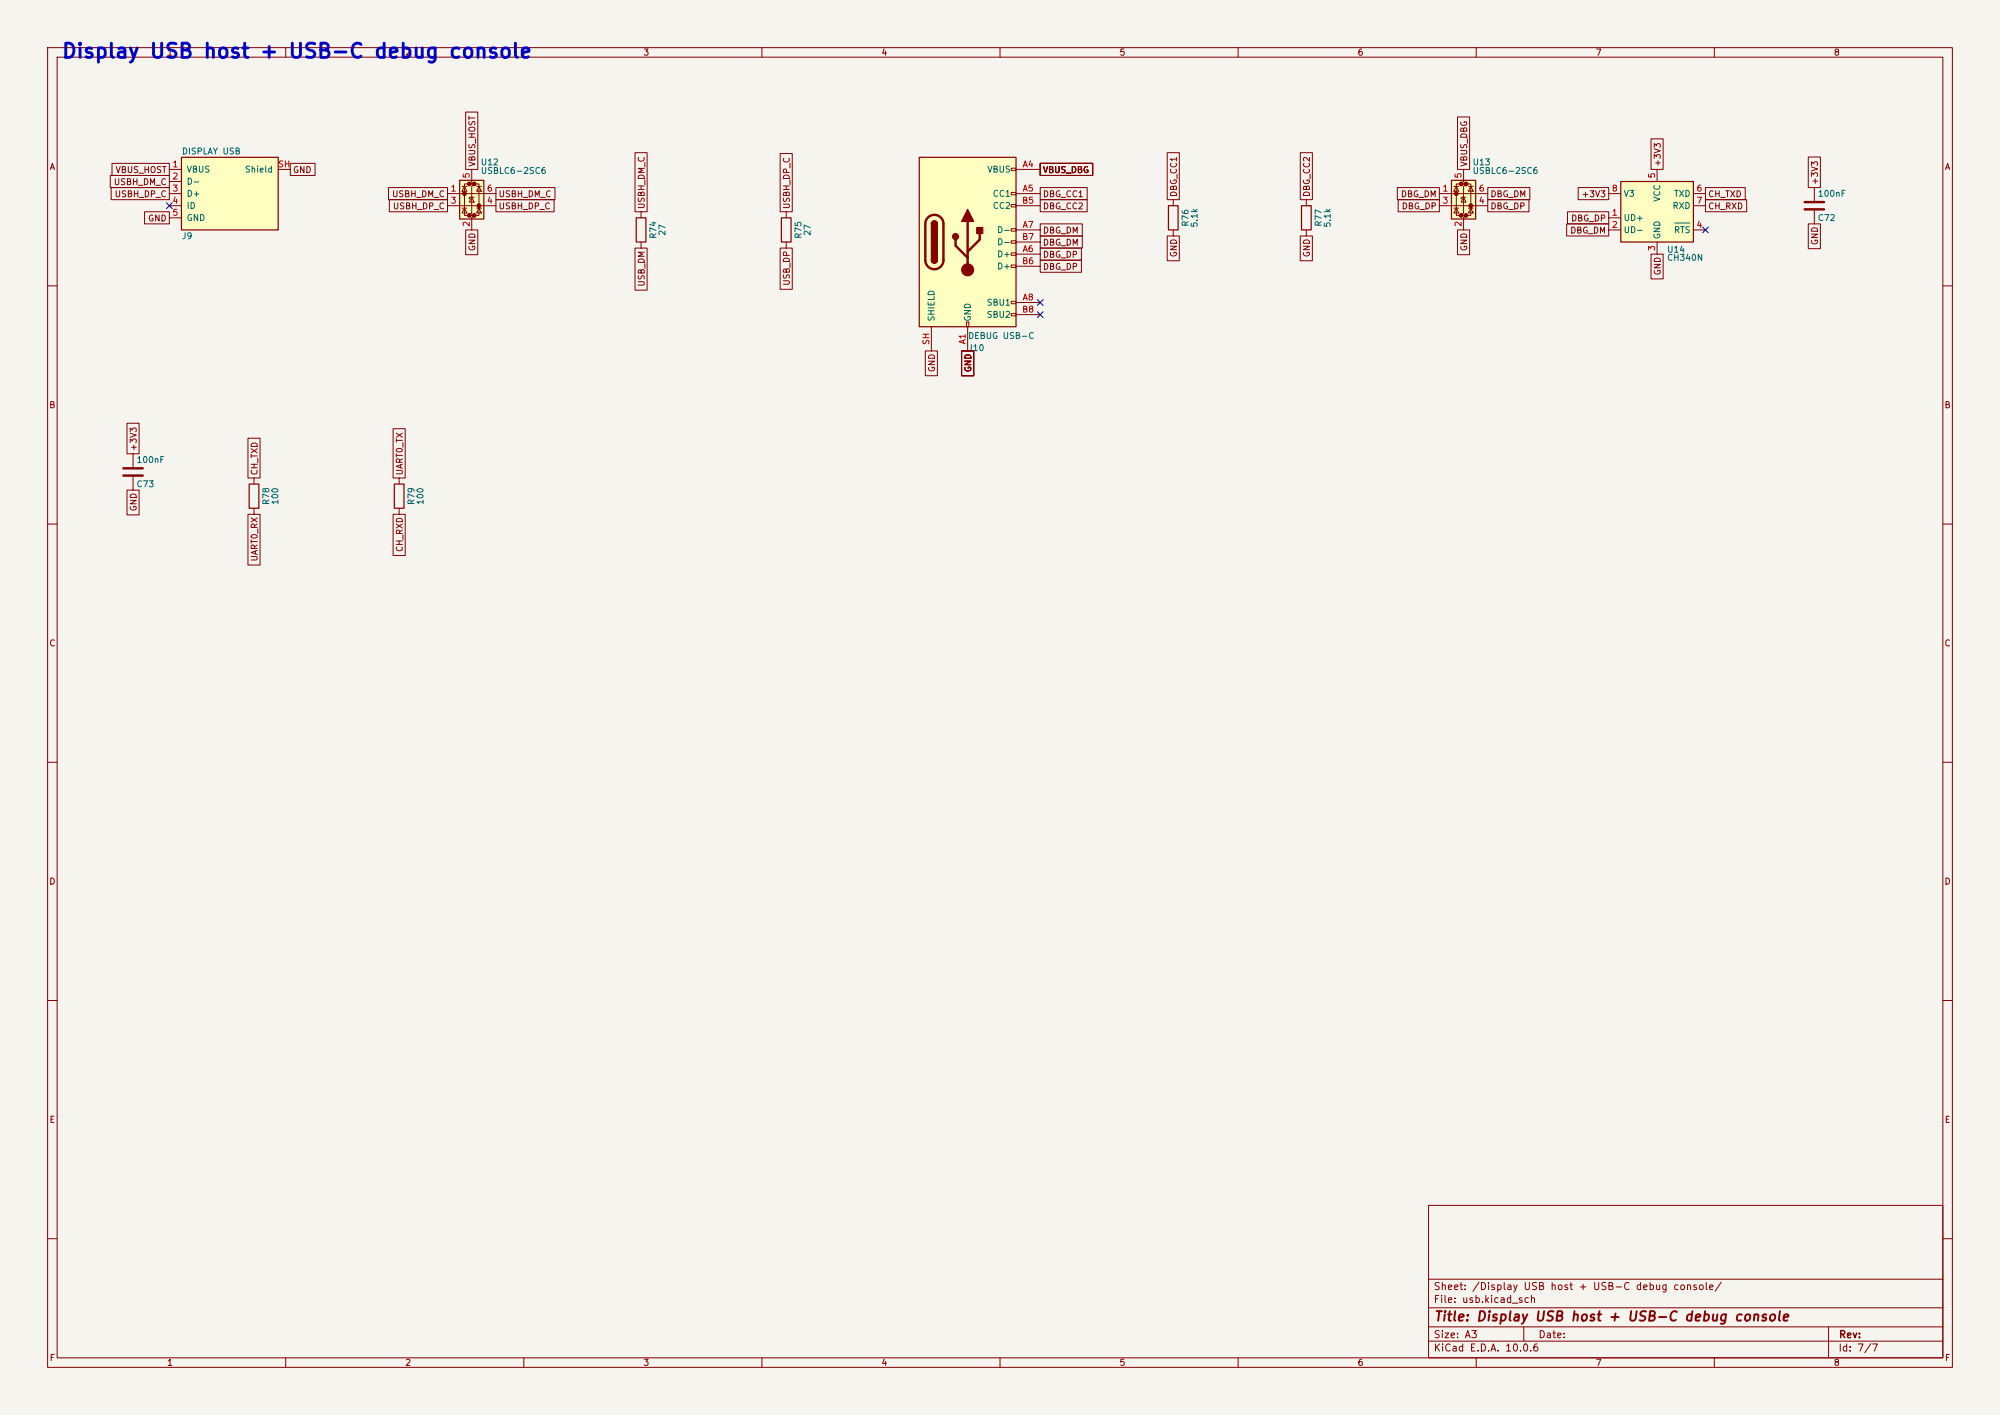
[picture p44: page 7]

File: usb.kicad_sch
Title: Display USB host + USB-C debug console
