mikenemat/skeeball-premium-re/hardware/hardware/main/skeeball-controller.kicad_pcb

## KiCad design hardware/hardware/main/skeeball-controller.kicad_pcb (2026-10-29)

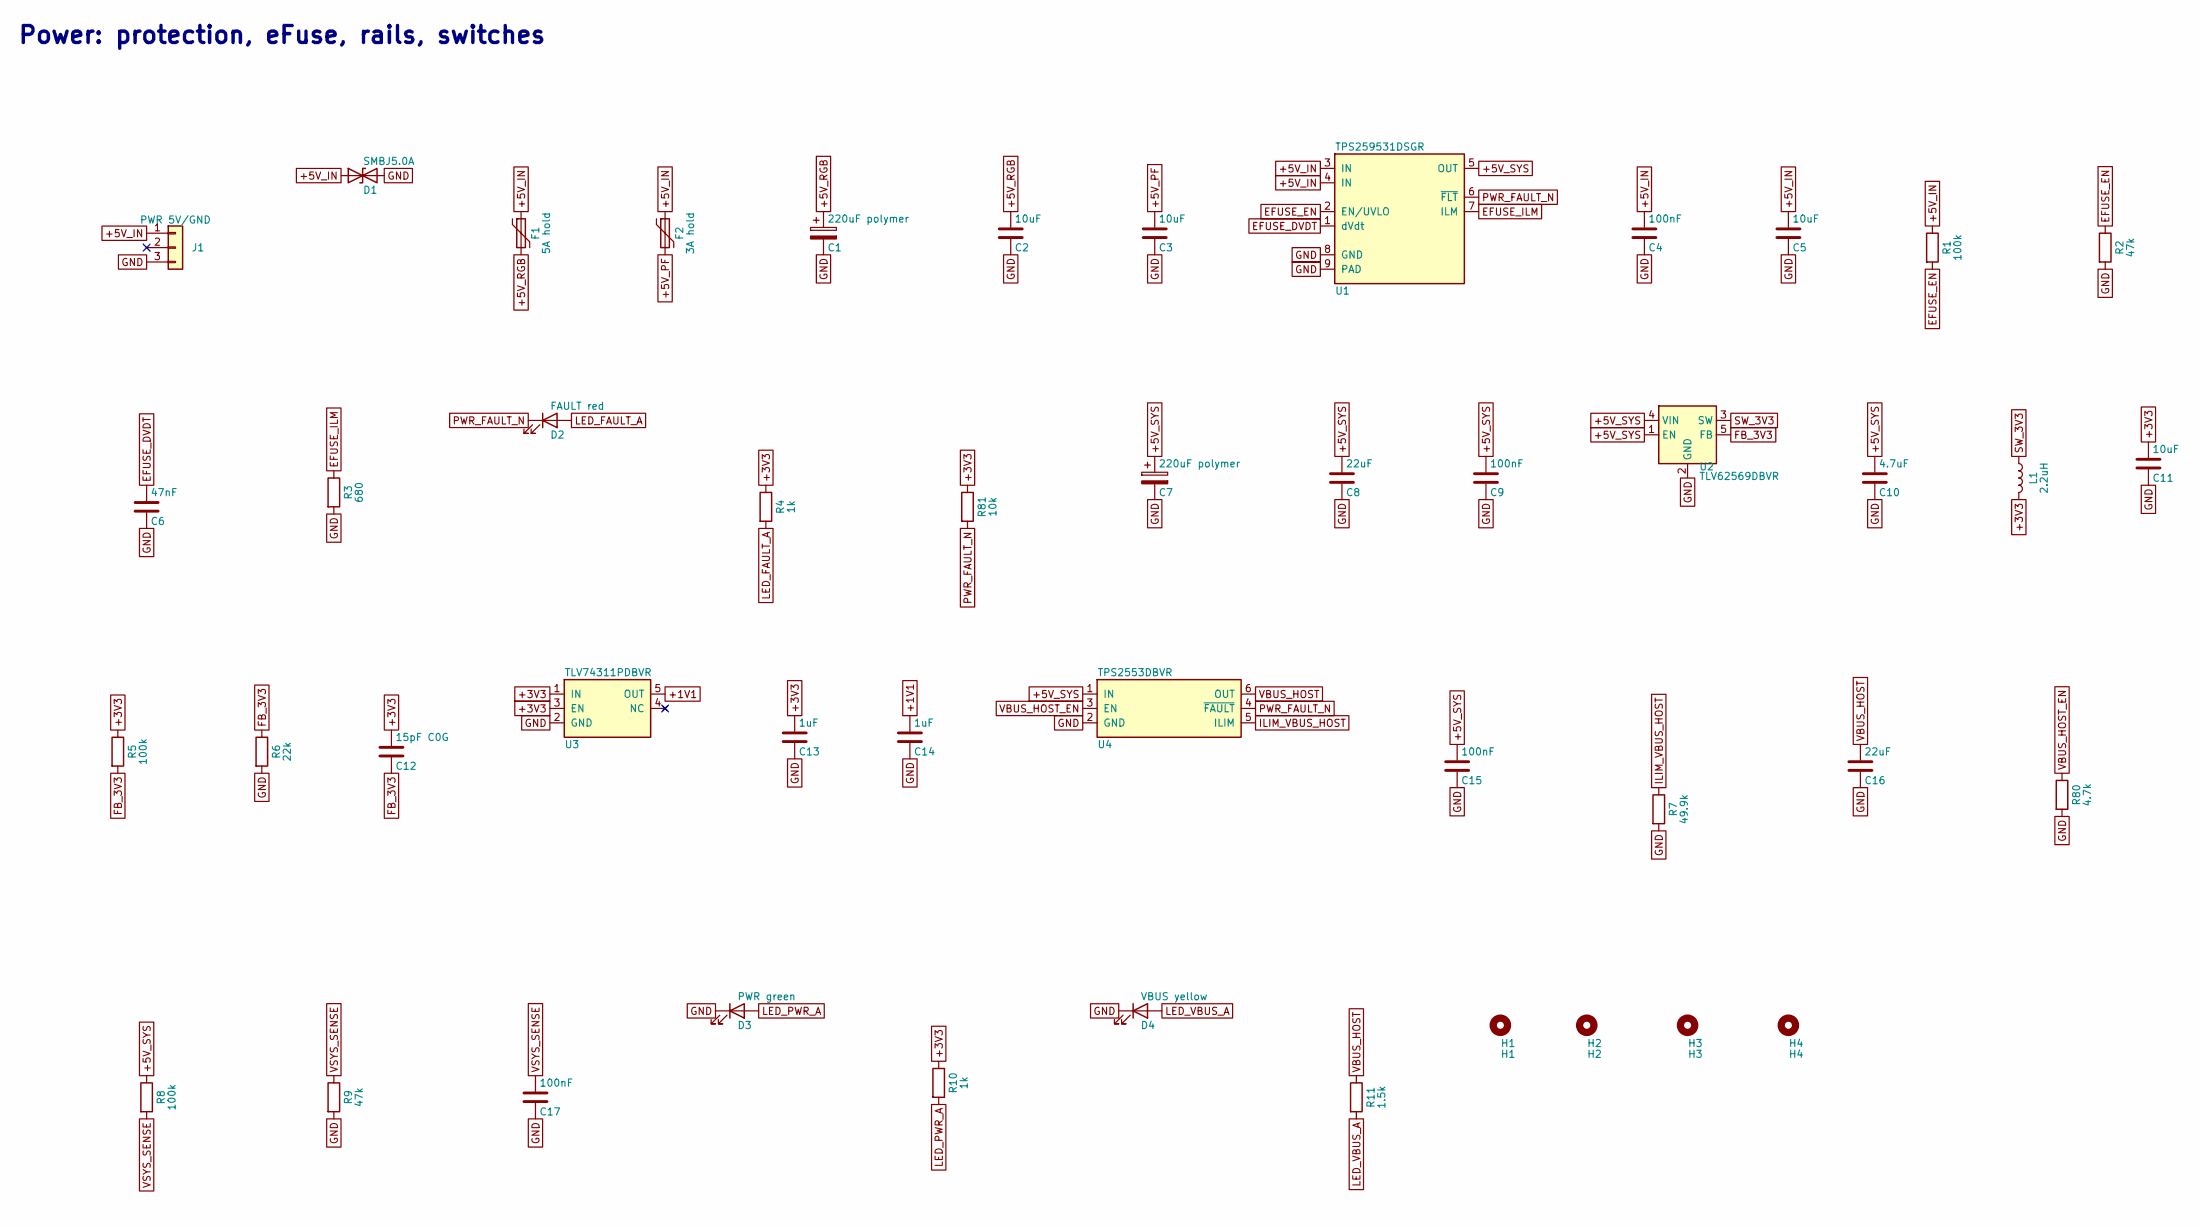
[picture p45: schematic power.kicad_sch, Power: protection, eFuse, rails, switches]

Parts:
C1, C7: 220uF polymer; CP_Elec_6.3x5.9; MPN OVZ221M1ATR-0606
C2, C3, C5, C11: 10uF; C_0805_2012Metric; MPN CL21A106KAYNNNE
C4, C9, C15, C17: 100nF; C_0603_1608Metric; MPN CC0603KRX7R9BB104
C6: 47nF; C_0603_1608Metric; MPN CL10B473KB8NNNC
C8, C16: 22uF; C_0805_2012Metric; MPN CL21A226MAQNNNE
C10: 4.7uF; C_0805_2012Metric; MPN CL21A475KAQNNNE
C12: 15pF C0G; C_0603_1608Metric; MPN CL10C150JB8NNNC
C13, C14: 1uF; C_0603_1608Metric; MPN CL10A105KB8NNNC
D1: SMBJ5.0A; D_SMB; MPN SMBJ5.0A; LCSC C83333
D2: FAULT red; LED_0603_1608Metric; MPN KT-0603R; LCSC C2286
D3: PWR green; LED_0603_1608Metric; MPN KT-0603G; LCSC C12624
D4: VBUS yellow; LED_0603_1608Metric; MPN NCD0603Y1; LCSC C84268
F1: 5A hold; Fuse_2920_7451Metric; MPN 2920L500/16MR; LCSC C207091
F2: 3A hold; Fuse_1812_4532Metric; MPN 1812L300MR; LCSC C127824
H1: H1; MountingHole_3.57mm
H2: H2; MountingHole_3.57mm
H3: H3; MountingHole_3.57mm
H4: H4; MountingHole_3.57mm
J1: PWR 5V/GND; Molex_Mini-Fit_Jr_39-30-3035_1x03_P4.20mm_Horizontal; MPN 39303035; LCSC C505179
L1: 2.2uH; L_Sunlord_SWPA4030S; MPN SWPA4030S2R2MT; LCSC C36409
R1, R5, R8: 100k; R_0603_1608Metric; tolerance 1%; MPN 0603WAF1003T5E
R2, R9: 47k; R_0603_1608Metric; tolerance 1%; MPN 0603WAF4702T5E
R3: 680; R_0603_1608Metric; tolerance 1%; MPN 0603WAF6800T5E
R4, R10: 1k; R_0603_1608Metric; tolerance 1%; MPN 0603WAF1001T5E
R6: 22k; R_0603_1608Metric; tolerance 1%; MPN 0603WAF2202T5E
R7: 49.9k; R_0603_1608Metric; tolerance 1%; MPN 0603WAF4992T5E
R11: 1.5k; R_0603_1608Metric; tolerance 1%; MPN 0603WAF1501T5E
R80: 4.7k; R_0603_1608Metric; tolerance 1%; MPN 0603WAF4701T5E
R81: 10k; R_0603_1608Metric; tolerance 1%; MPN 0603WAF1002T5E
U1: TPS259531DSGR; Texas_DSG0008A_WSON-8-1EP_2x2mm_P0.5mm_EP0.9x1.6mm; MPN TPS259531DSGR; LCSC C2155674
U2: TLV62569DBVR; SOT-23-5; MPN TLV62569DBVR; LCSC C141836
U3: TLV74311PDBVR; SOT-23-5; MPN TLV74311PDBVR; LCSC C485147
U4: TPS2553DBVR; SOT-23-6; MPN TPS2553DBVR; LCSC C55266

Connections:
+1V1: C14.1, U3.5 (OUT); also elsewhere on the board
+3V3: C11.1, C12.1, C13.1, L1.2, R4.1, R5.1, R10.1, R81.1, U3.1 (IN), U3.3 (EN); also elsewhere on the board
+5V_IN: C4.1, C5.1, D1.1 (A1), F1.1, F2.1, J1.1, R1.1, U1.3 (IN), U1.4 (IN)
+5V_PF: C3.1, F2.2; also elsewhere on the board
+5V_RGB: C1.1, C2.1, F1.2; also elsewhere on the board
+5V_SYS: C7.1, C8.1, C9.1, C10.1, C15.1, R8.1, U1.5 (OUT), U2.1 (EN), U2.4 (VIN), U4.1 (IN); also elsewhere on the board
EFUSE_DVDT: C6.1, U1.1 (dVdt)
EFUSE_EN: R1.2, R2.1, U1.2 (EN/UVLO)
EFUSE_ILM: R3.1, U1.7 (ILM)
FB_3V3: C12.2, R5.2, R6.1, U2.5 (FB)
GND: C1.2, C2.2, C3.2, C4.2, C5.2, C6.2, C7.2, C8.2, C9.2, C10.2, C11.2, C13.2, C14.2, C15.2, C16.2, C17.2, D1.2 (A2), D3.1 (K), D4.1 (K), J1.3, R2.2, R3.2, R6.2, R7.2, R9.2, R80.2, U1.8 (GND), U1.9 (PAD), U2.2 (GND), U3.2 (GND), U4.2 (GND); also elsewhere on the board
ILIM_VBUS_HOST: R7.1, U4.5 (ILIM)
LED_FAULT_A: D2.2 (A), R4.2
LED_PWR_A: D3.2 (A), R10.2
LED_VBUS_A: D4.2 (A), R11.2
PWR_FAULT_N: D2.1 (K), R81.2, U1.6 (~FLT), U4.4 (~FAULT); also elsewhere on the board
SW_3V3: L1.1, U2.3 (SW)
VBUS_HOST: C16.1, R11.1, U4.6 (OUT); also elsewhere on the board
VBUS_HOST_EN: R80.1, U4.3 (EN); also elsewhere on the board
VSYS_SENSE: C17.1, R8.2, R9.1; also elsewhere on the board

Notes on the sheet:
Power: protection, eFuse, rails, switches

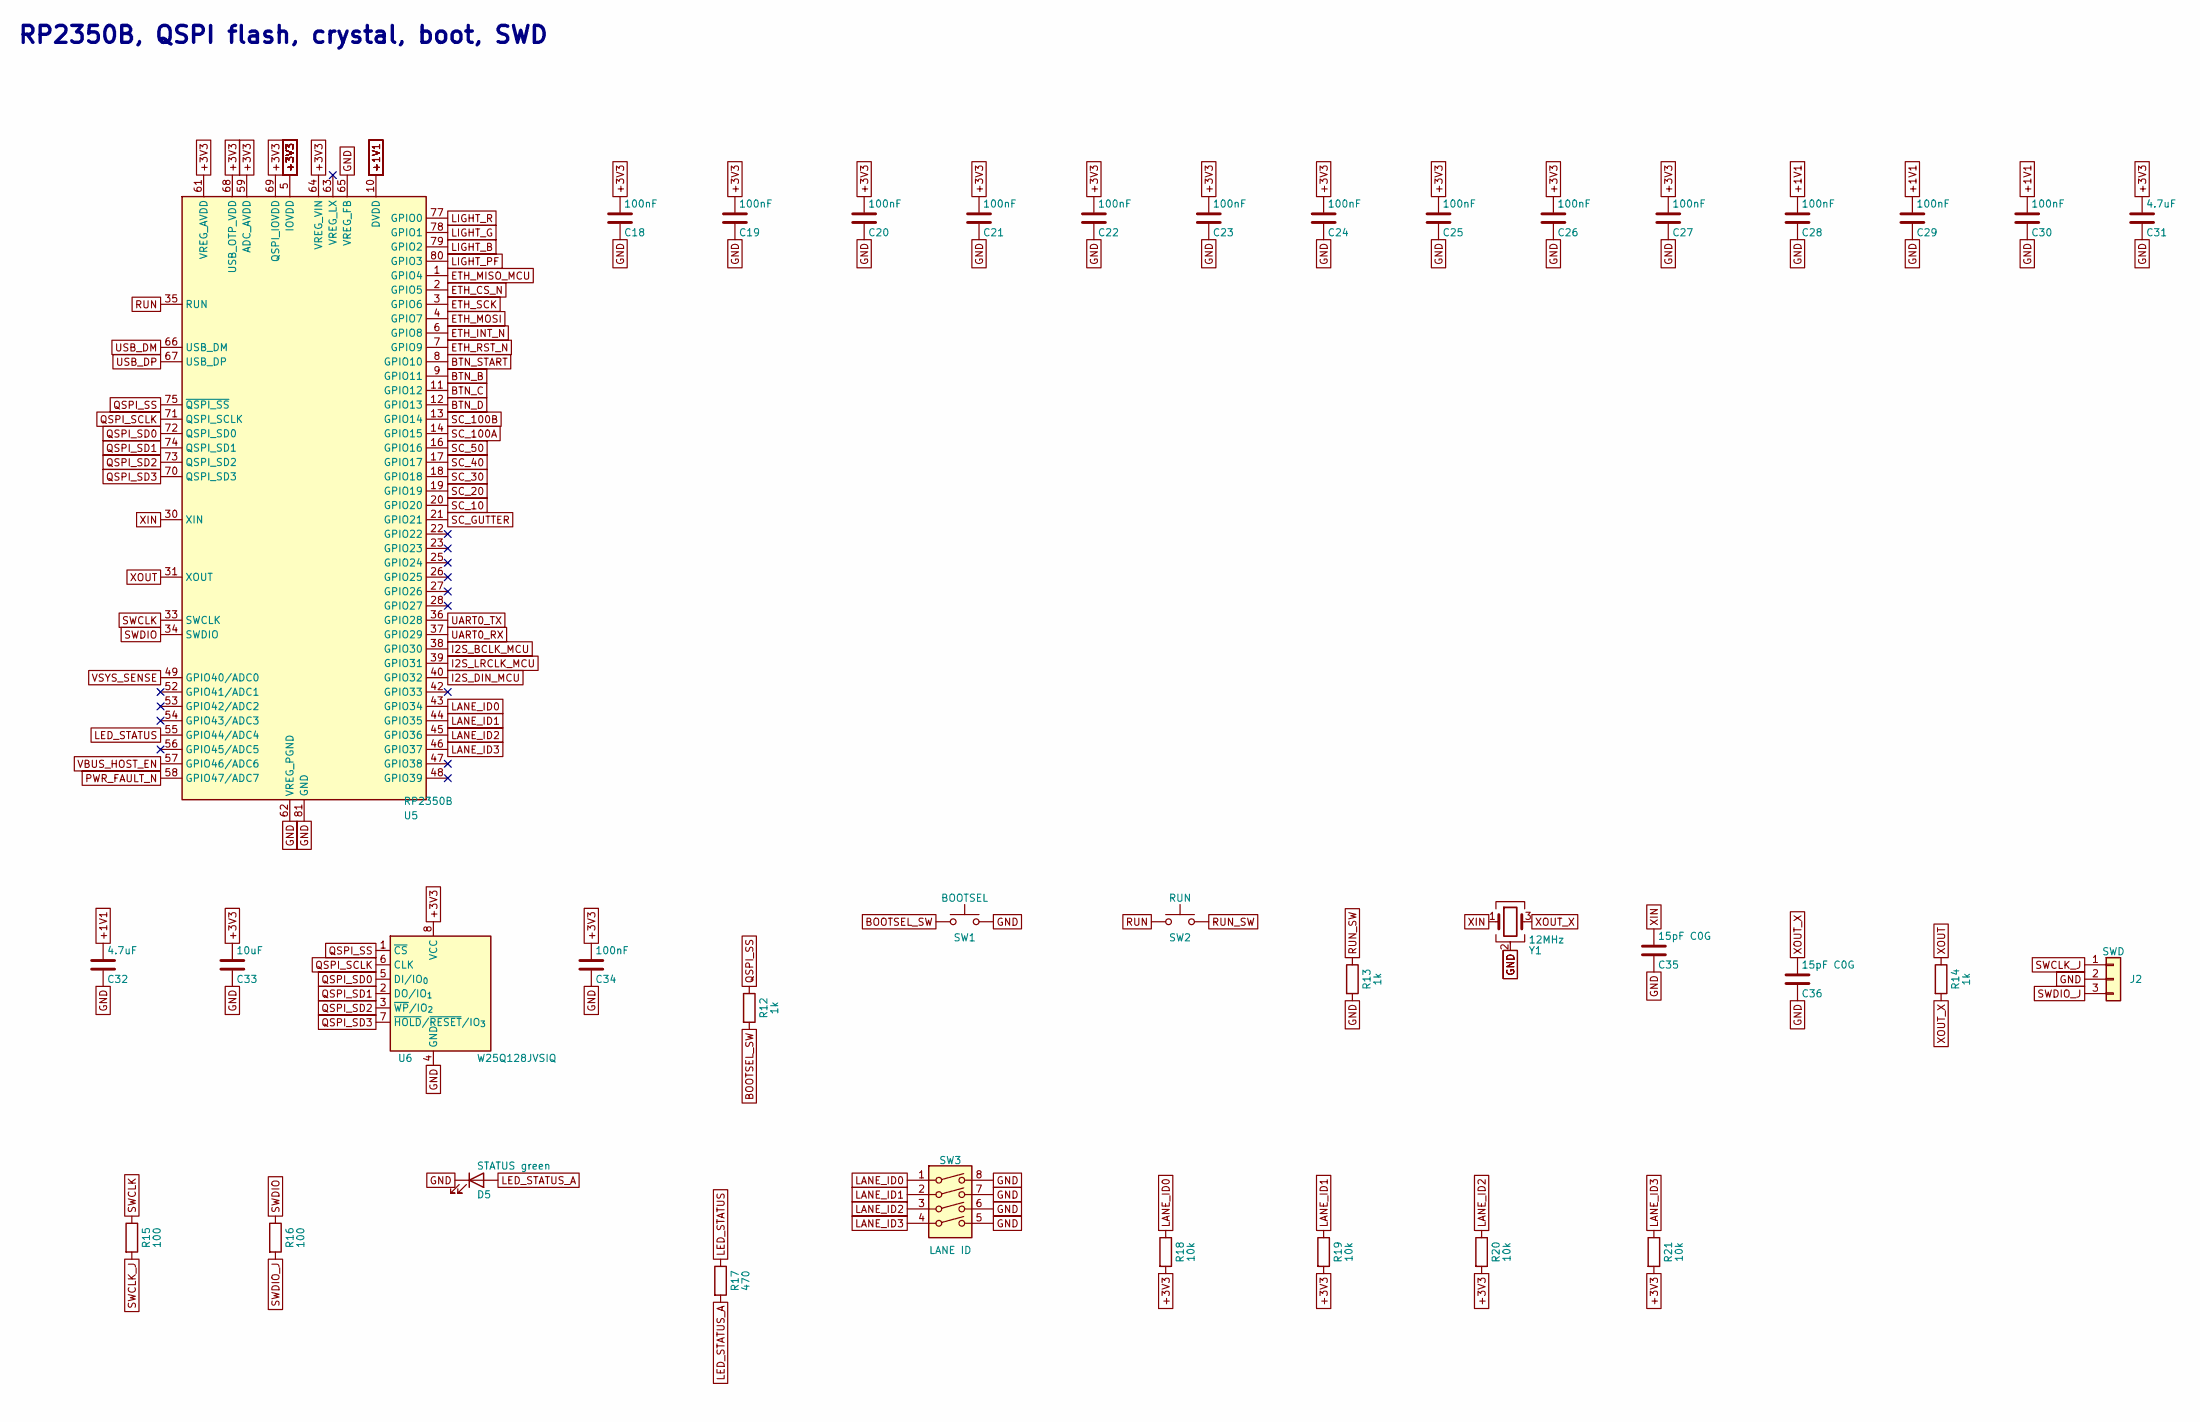
[picture p46: schematic mcu.kicad_sch, RP2350B, QSPI flash, crystal, boot, SWD]

Parts:
C18, C19, C20, C21, C22, C23, C24, C25, C26, C27, C28, C29, C30, C34: 100nF; C_0402_1005Metric; MPN CL05B104KO5NNNC
C31, C32: 4.7uF; C_0402_1005Metric; MPN CL05A475MP5NRNC
C33: 10uF; C_0805_2012Metric; MPN CL21A106KAYNNNE
C35, C36: 15pF C0G; C_0603_1608Metric; MPN CL10C150JB8NNNC
D5: STATUS green; LED_0603_1608Metric; MPN KT-0603G; LCSC C12624
J2: SWD; JST_SH_BM03B-SRSS-TB_1x03-1MP_P1.00mm_Vertical; MPN BM03B-SRSS-TB(LF)(SN); LCSC C160389
R12, R13, R14: 1k; R_0402_1005Metric; tolerance 1%; MPN 0402WGF1001TCE
R15, R16: 100; R_0402_1005Metric; tolerance 1%; MPN 0402WGF1000TCE
R17: 470; R_0603_1608Metric; tolerance 1%; MPN 0603WAF4700T5E
R18, R19, R20, R21: 10k; R_0603_1608Metric; tolerance 1%; MPN 0603WAF1002T5E
SW1: BOOTSEL; SW_Push_1P1T_XKB_TS-1187A; MPN TS-1187A-B-A-B; LCSC C318884
SW2: RUN; SW_Push_1P1T_XKB_TS-1187A; MPN TS-1187A-B-A-B; LCSC C318884
SW3: LANE ID; SW_DIP_XKB_DSIC04LS-P; MPN DSIC04LS-P; LCSC C319038
U5: RP2350B; QFN-80-1EP_10x10mm_P0.4mm_EP3.4x3.4mm; MPN RP2350B; LCSC C42415655
U6: W25Q128JVSIQ; SOIC-8_5.3x5.3mm_P1.27mm; MPN W25Q128JVSIQ; LCSC C97521
Y1: 12MHz; Crystal_SMD_3225-4Pin_3.2x2.5mm; MPN ABM8-272-T3; LCSC C20625731

Connections:
+1V1: C28.1, C29.1, C30.1, C32.1, U5.10 (DVDD), U5.32 (DVDD), U5.51 (DVDD); also elsewhere on the board
+3V3: C18.1, C19.1, C20.1, C21.1, C22.1, C23.1, C24.1, C25.1, C26.1, C27.1, C31.1, C33.1, C34.1, R18.2, R19.2, R20.2, R21.2, U5.5 (IOVDD), U5.15 (IOVDD), U5.24 (IOVDD), U5.29 (IOVDD), U5.41 (IOVDD), U5.50 (IOVDD), U5.59 (ADC_AVDD), U5.60 (IOVDD), U5.61 (VREG_AVDD), U5.64 (VREG_VIN), U5.68 (USB_OTP_VDD), U5.69 (QSPI_IOVDD), U5.76 (IOVDD), U6.8 (VCC); also elsewhere on the board
BOOTSEL_SW: R12.2, SW1.1
BTN_B: U5.9 (GPIO11); also elsewhere on the board
BTN_C: U5.11 (GPIO12); also elsewhere on the board
BTN_D: U5.12 (GPIO13); also elsewhere on the board
BTN_START: U5.8 (GPIO10); also elsewhere on the board
ETH_CS_N: U5.2 (GPIO5); also elsewhere on the board
ETH_INT_N: U5.6 (GPIO8); also elsewhere on the board
ETH_MISO_MCU: U5.1 (GPIO4); also elsewhere on the board
ETH_MOSI: U5.4 (GPIO7); also elsewhere on the board
ETH_RST_N: U5.7 (GPIO9); also elsewhere on the board
ETH_SCK: U5.3 (GPIO6); also elsewhere on the board
GND: C18.2, C19.2, C20.2, C21.2, C22.2, C23.2, C24.2, C25.2, C26.2, C27.2, C28.2, C29.2, C30.2, C31.2, C32.2, C33.2, C34.2, C35.2, C36.2, D5.1 (K), J2.2, R13.2, SW1.2, SW3.5, SW3.6, SW3.7, SW3.8, U5.62 (VREG_PGND), U5.65 (VREG_FB), U5.81 (GND), U6.4 (GND), Y1.2 (G), Y1.4 (G); also elsewhere on the board
I2S_BCLK_MCU: U5.38 (GPIO30); also elsewhere on the board
I2S_DIN_MCU: U5.40 (GPIO32); also elsewhere on the board
I2S_LRCLK_MCU: U5.39 (GPIO31); also elsewhere on the board
LANE_ID0: R18.1, SW3.1, U5.43 (GPIO34)
LANE_ID1: R19.1, SW3.2, U5.44 (GPIO35)
LANE_ID2: R20.1, SW3.3, U5.45 (GPIO36)
LANE_ID3: R21.1, SW3.4, U5.46 (GPIO37)
LED_STATUS: R17.1, U5.55 (GPIO44/ADC4)
LED_STATUS_A: D5.2 (A), R17.2
LIGHT_B: U5.79 (GPIO2); also elsewhere on the board
LIGHT_G: U5.78 (GPIO1); also elsewhere on the board
LIGHT_PF: U5.80 (GPIO3); also elsewhere on the board
LIGHT_R: U5.77 (GPIO0); also elsewhere on the board
PWR_FAULT_N: U5.58 (GPIO47/ADC7); also elsewhere on the board
QSPI_SCLK: U5.71 (QSPI_SCLK), U6.6 (CLK)
QSPI_SD0: U5.72 (QSPI_SD0), U6.5 (DI/IO_{0})
QSPI_SD1: U5.74 (QSPI_SD1), U6.2 (DO/IO_{1})
QSPI_SD2: U5.73 (QSPI_SD2), U6.3 (~WP/IO_{2})
QSPI_SD3: U5.70 (QSPI_SD3), U6.7 (~HOLD/~RESET/IO_{3})
QSPI_SS: R12.1, U5.75 (~QSPI_SS), U6.1 (~CS)
RUN: SW2.1, U5.35 (RUN)
RUN_SW: R13.1, SW2.2
SC_10: U5.20 (GPIO20); also elsewhere on the board
SC_20: U5.19 (GPIO19); also elsewhere on the board
SC_30: U5.18 (GPIO18); also elsewhere on the board
SC_40: U5.17 (GPIO17); also elsewhere on the board
SC_50: U5.16 (GPIO16); also elsewhere on the board
SC_100A: U5.14 (GPIO15); also elsewhere on the board
SC_100B: U5.13 (GPIO14); also elsewhere on the board
SC_GUTTER: U5.21 (GPIO21); also elsewhere on the board
SWCLK: R15.1, U5.33 (SWCLK)
SWCLK_J: J2.1, R15.2
SWDIO: R16.1, U5.34 (SWDIO)
SWDIO_J: J2.3, R16.2
UART0_RX: U5.37 (GPIO29); also elsewhere on the board
UART0_TX: U5.36 (GPIO28); also elsewhere on the board
USB_DM: U5.66 (USB_DM); also elsewhere on the board
USB_DP: U5.67 (USB_DP); also elsewhere on the board
VBUS_HOST_EN: U5.57 (GPIO46/ADC6); also elsewhere on the board
VSYS_SENSE: U5.49 (GPIO40/ADC0); also elsewhere on the board
XIN: C35.1, U5.30 (XIN), Y1.1
XOUT: R14.1, U5.31 (XOUT)
XOUT_X: C36.1, R14.2, Y1.3

Notes on the sheet:
RP2350B, QSPI flash, crystal, boot, SWD

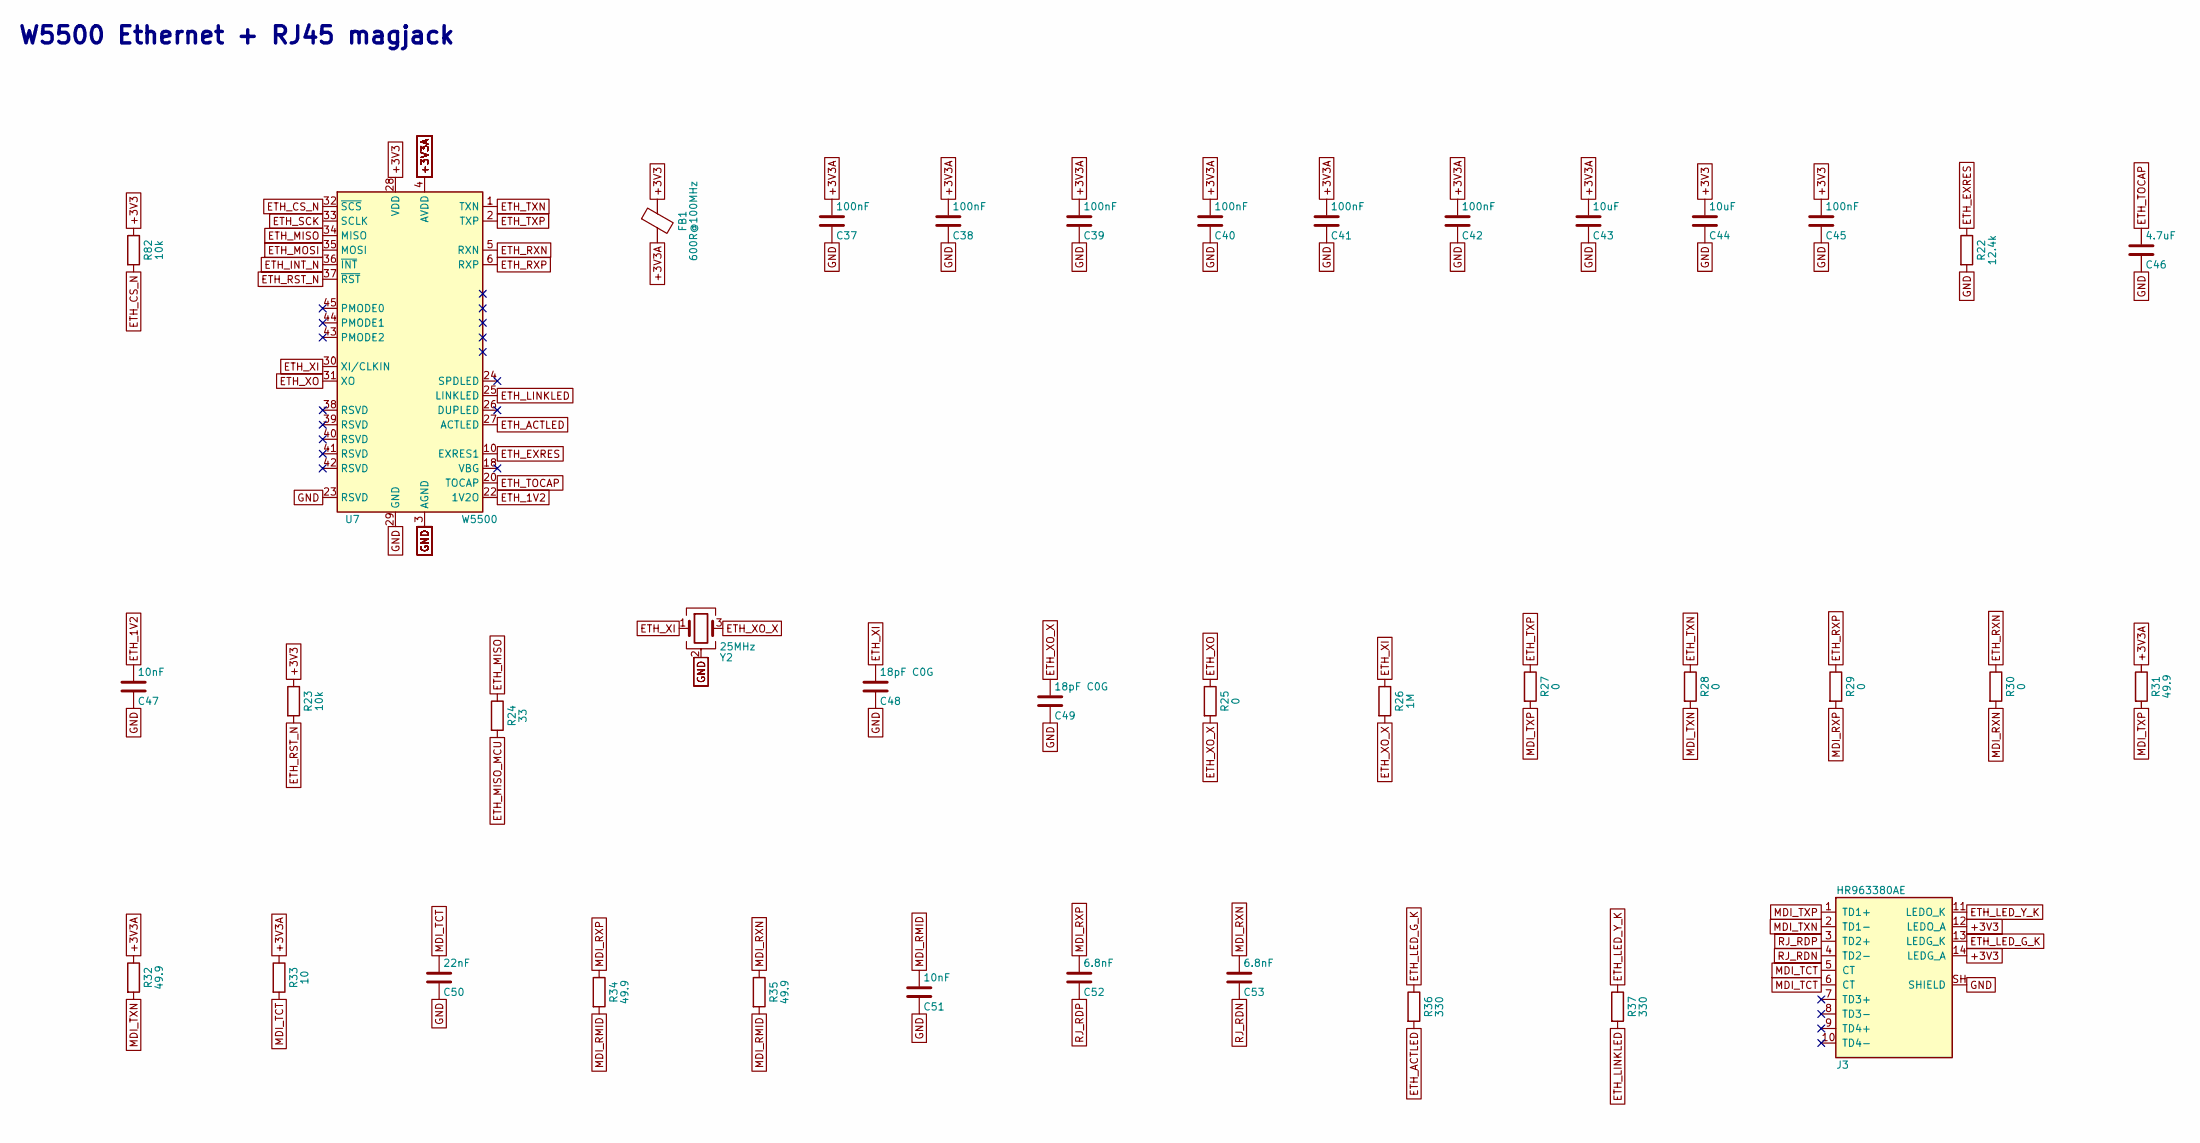
[picture p47: schematic ethernet.kicad_sch, W5500 Ethernet + RJ45 magjack]

Parts:
C37, C38, C39, C40, C41, C42, C45: 100nF; C_0603_1608Metric; MPN CC0603KRX7R9BB104
C43, C44: 10uF; C_0805_2012Metric; MPN CL21A106KAYNNNE
C46: 4.7uF; C_0805_2012Metric; MPN CL21A475KAQNNNE
C47, C51: 10nF; C_0603_1608Metric; MPN 0603B103K500NT
C48, C49: 18pF C0G; C_0603_1608Metric; MPN CL10C180JB8NNNC
C50: 22nF; C_0603_1608Metric; MPN CL10B223KB8NNNC
C52, C53: 6.8nF; C_0603_1608Metric; MPN 0603B682K500NT
FB1: 600R@100MHz; L_0805_2012Metric; MPN GZ2012D601TF; LCSC C1017
J3: HR963380AE; RJ45_HanRun_HR963380AE_Vertical; MPN HR963380AE; LCSC C19724763
R22: 12.4k; R_0603_1608Metric; tolerance 1%; MPN 0603WAF1242T5E
R23, R82: 10k; R_0603_1608Metric; tolerance 1%; MPN 0603WAF1002T5E
R24: 33; R_0603_1608Metric; tolerance 1%; MPN 0603WAF330JT5E
R25, R27, R28, R29, R30: 0; R_0603_1608Metric; tolerance 1%; MPN 0603WAF0000T5E
R26: 1M; R_0603_1608Metric; tolerance 1%; MPN 0603WAF1004T5E
R31, R32, R34, R35: 49.9; R_0603_1608Metric; tolerance 1%; MPN 0603WAF499JT5E
R33: 10; R_0603_1608Metric; tolerance 1%; MPN 0603WAF100JT5E
R36, R37: 330; R_0603_1608Metric; tolerance 1%; MPN 0603WAF3300T5E
U7: W5500; LQFP-48_7x7mm_P0.5mm; MPN W5500; LCSC C32843
Y2: 25MHz; Crystal_SMD_3225-4Pin_3.2x2.5mm; MPN X322525MOB4SI; LCSC C9006

Connections:
+3V3: C44.1, C45.1, FB1.1, J3.12 (LEDO_A), J3.14 (LEDG_A), R23.1, R82.1, U7.28 (VDD); also elsewhere on the board
+3V3A: C37.1, C38.1, C39.1, C40.1, C41.1, C42.1, C43.1, FB1.2, R31.1, R32.1, R33.1, U7.4 (AVDD), U7.8 (AVDD), U7.11 (AVDD), U7.15 (AVDD), U7.17 (AVDD), U7.21 (AVDD)
ETH_1V2: C47.1, U7.22 (1V2O)
ETH_ACTLED: R36.2, U7.27 (ACTLED)
ETH_CS_N: R82.2, U7.32 (~SCS); also elsewhere on the board
ETH_EXRES: R22.1, U7.10 (EXRES1)
ETH_INT_N: U7.36 (~INT); also elsewhere on the board
ETH_LED_G_K: J3.13 (LEDG_K), R36.1
ETH_LED_Y_K: J3.11 (LEDO_K), R37.1
ETH_LINKLED: R37.2, U7.25 (LINKLED)
ETH_MISO: R24.1, U7.34 (MISO)
ETH_MISO_MCU: R24.2; also elsewhere on the board
ETH_MOSI: U7.35 (MOSI); also elsewhere on the board
ETH_RST_N: R23.2, U7.37 (~RST); also elsewhere on the board
ETH_RXN: R30.1, U7.5 (RXN)
ETH_RXP: R29.1, U7.6 (RXP)
ETH_SCK: U7.33 (SCLK); also elsewhere on the board
ETH_TOCAP: C46.1, U7.20 (TOCAP)
ETH_TXN: R28.1, U7.1 (TXN)
ETH_TXP: R27.1, U7.2 (TXP)
ETH_XI: C48.1, R26.1, U7.30 (XI/CLKIN), Y2.1
ETH_XO: R25.1, U7.31 (XO)
ETH_XO_X: C49.1, R25.2, R26.2, Y2.3
GND: C37.2, C38.2, C39.2, C40.2, C41.2, C42.2, C43.2, C44.2, C45.2, C46.2, C47.2, C48.2, C49.2, C50.2, C51.2, J3.SH (SHIELD), R22.2, U7.3 (AGND), U7.9 (AGND), U7.14 (AGND), U7.16 (AGND), U7.19 (AGND), U7.23 (RSVD), U7.29 (GND), U7.48 (AGND), Y2.2 (G), Y2.4 (G); also elsewhere on the board
MDI_RMID: C51.1, R34.2, R35.2
MDI_RXN: C53.1, R30.2, R35.1
MDI_RXP: C52.1, R29.2, R34.1
MDI_TCT: C50.1, J3.5 (CT), J3.6 (CT), R33.2
MDI_TXN: J3.2 (TD1-), R28.2, R32.2
MDI_TXP: J3.1 (TD1+), R27.2, R31.2
RJ_RDN: C53.2, J3.4 (TD2-)
RJ_RDP: C52.2, J3.3 (TD2+)

Notes on the sheet:
W5500 Ethernet + RJ45 magjack

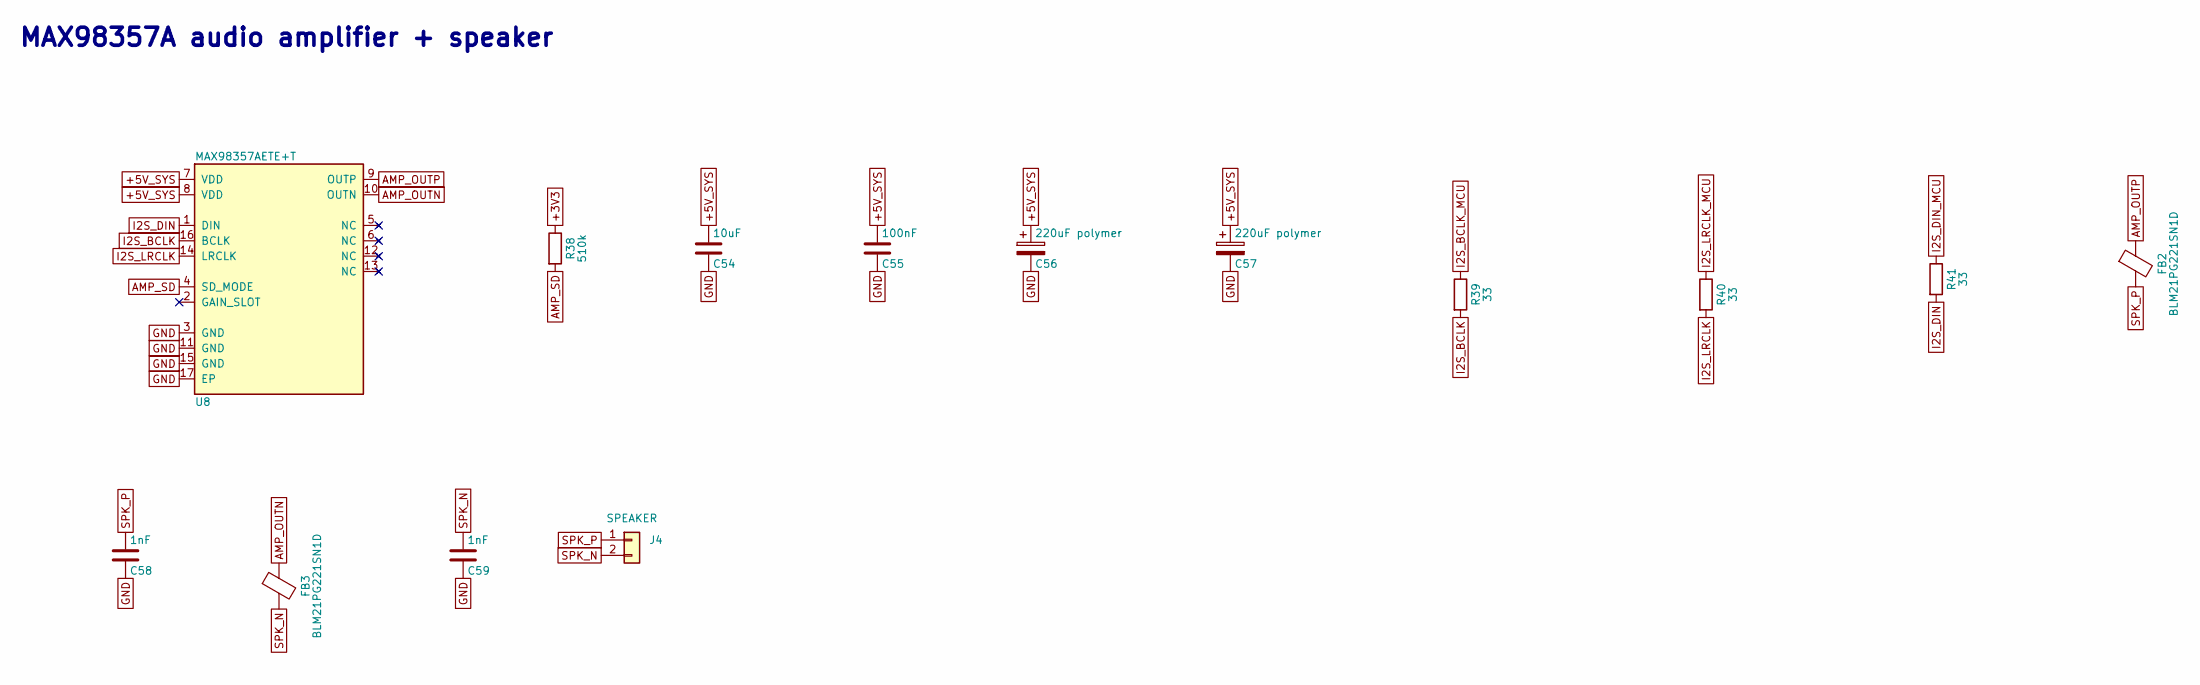
[picture p48: schematic audio.kicad_sch, MAX98357A audio amplifier + speaker]

Parts:
C54: 10uF; C_0805_2012Metric; MPN CL21A106KAYNNNE
C55: 100nF; C_0603_1608Metric; MPN CC0603KRX7R9BB104
C56, C57: 220uF polymer; CP_Elec_6.3x5.9; MPN OVZ221M1ATR-0606
C58, C59: 1nF; C_0603_1608Metric; MPN CL10B102KB8NNNC
FB2, FB3: BLM21PG221SN1D; L_0805_2012Metric; MPN BLM21PG221SN1D; LCSC C85840
J4: SPEAKER; Molex_Mini-Fit_Jr_5569-02A2_2x01_P4.20mm_Horizontal; MPN 39300020; LCSC C240831
R38: 510k; R_0603_1608Metric; tolerance 1%; MPN 0603WAF5103T5E
R39, R40, R41: 33; R_0603_1608Metric; tolerance 1%; MPN 0603WAF330JT5E
U8: MAX98357AETE+T; TQFN-16-1EP_3x3mm_P0.5mm_EP1.23x1.23mm; MPN MAX98357AETE+T; LCSC C910544

Connections:
+3V3: R38.1; also elsewhere on the board
+5V_SYS: C54.1, C55.1, C56.1, C57.1, U8.7 (VDD), U8.8 (VDD); also elsewhere on the board
AMP_OUTN: FB3.1, U8.10 (OUTN)
AMP_OUTP: FB2.1, U8.9 (OUTP)
AMP_SD: R38.2, U8.4 (SD_MODE)
GND: C54.2, C55.2, C56.2, C57.2, C58.2, C59.2, U8.3 (GND), U8.11 (GND), U8.15 (GND), U8.17 (EP); also elsewhere on the board
I2S_BCLK: R39.2, U8.16 (BCLK)
I2S_BCLK_MCU: R39.1; also elsewhere on the board
I2S_DIN: R41.2, U8.1 (DIN)
I2S_DIN_MCU: R41.1; also elsewhere on the board
I2S_LRCLK: R40.2, U8.14 (LRCLK)
I2S_LRCLK_MCU: R40.1; also elsewhere on the board
SPK_N: C59.1, FB3.2, J4.2
SPK_P: C58.1, FB2.2, J4.1

Notes on the sheet:
MAX98357A audio amplifier + speaker
