mikenemat/skeeball-premium-re/hardware/hardware/main/skeeball-controller.kicad_pcb

## KiCad design hardware/hardware/main/skeeball-controller.kicad_pcb (continued)

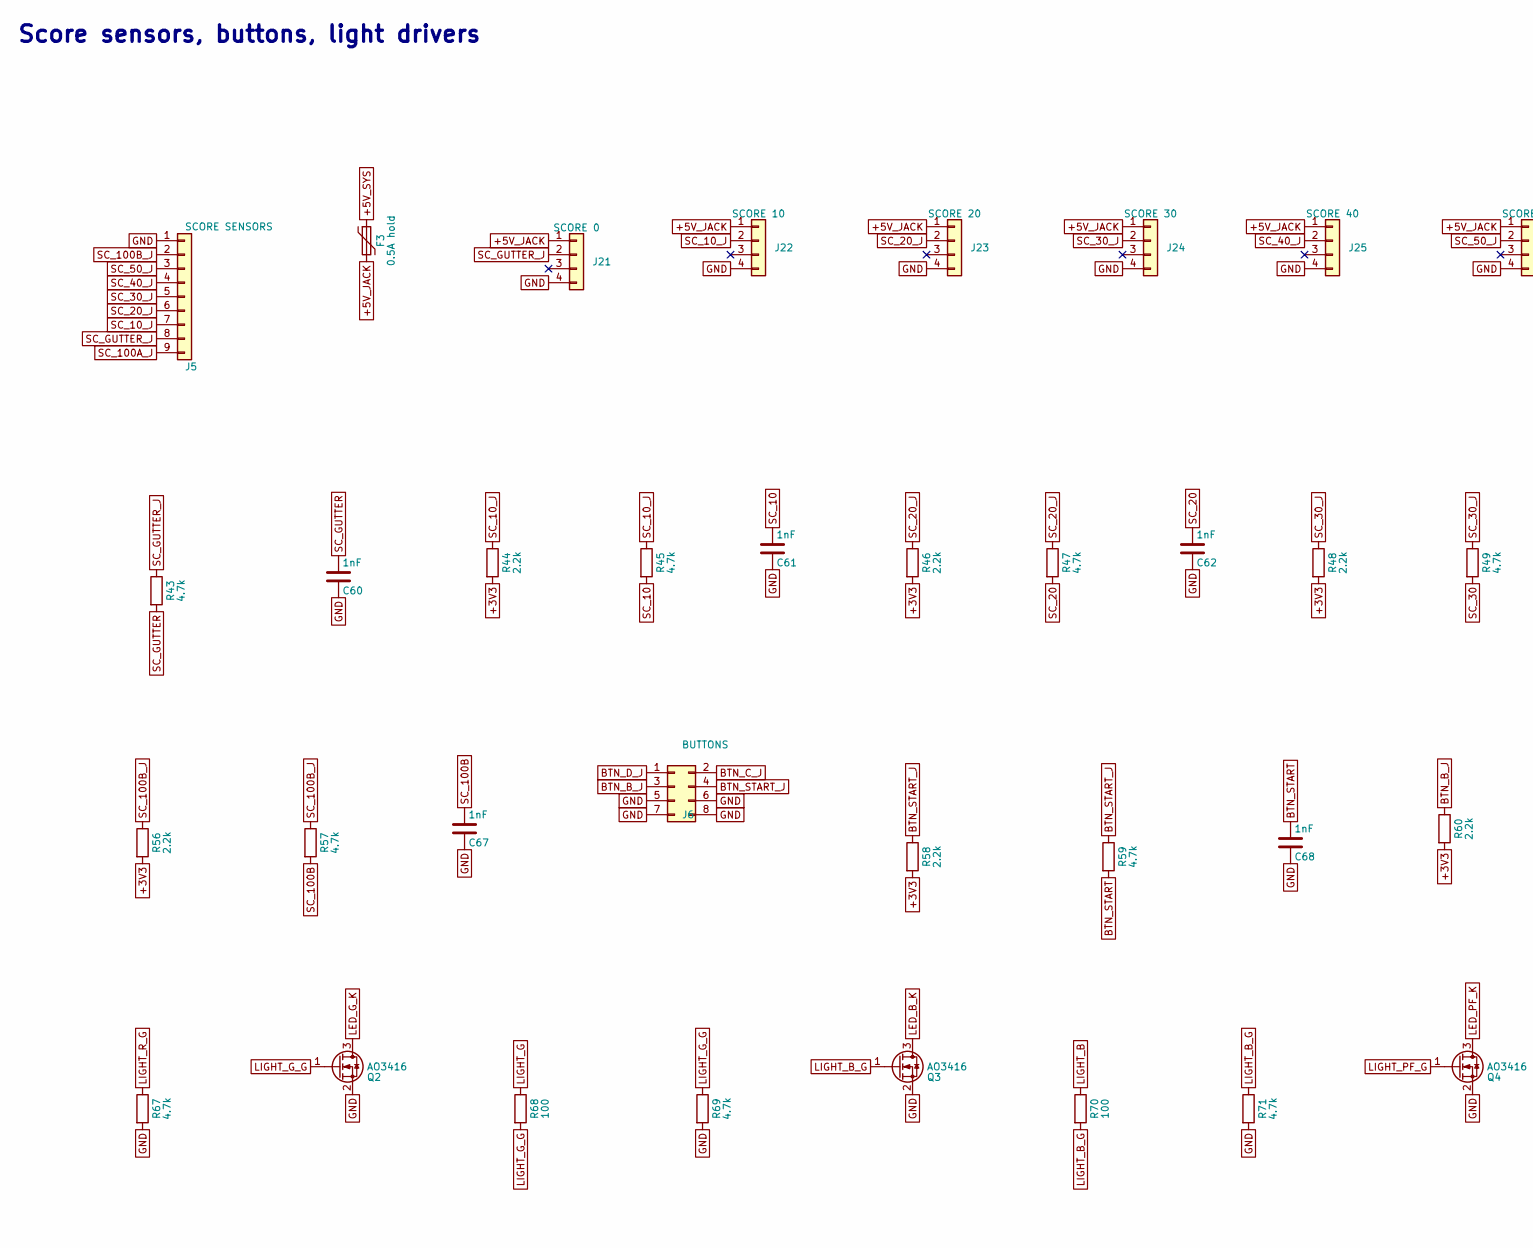
[picture p49: schematic io.kicad_sch, Score sensors, buttons, light drivers, part in row 1, column 1]

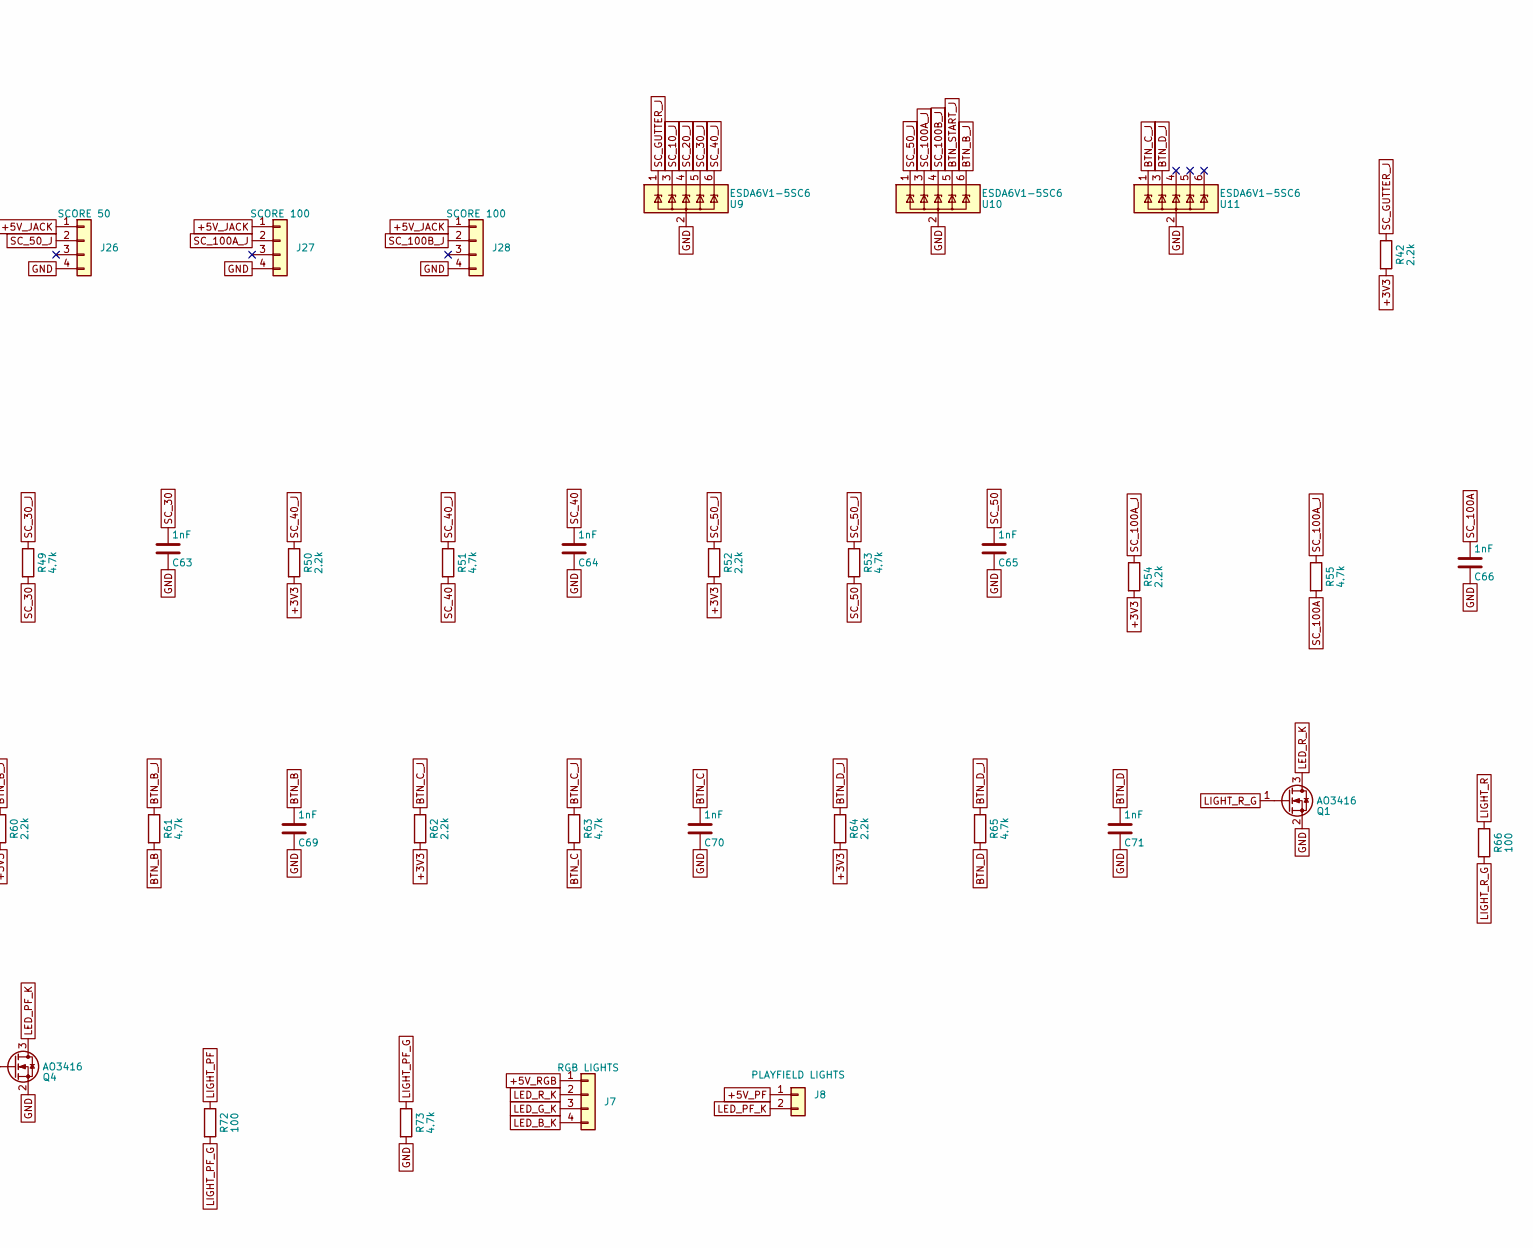
[picture p50: schematic io.kicad_sch, Score sensors, buttons, light drivers, part in row 1, column 2]

Parts:
C60, C61, C62, C63, C64, C65, C66, C67, C68, C69, C70, C71: 1nF; C_0603_1608Metric; MPN CL10B102KB8NNNC
F3: 0.5A hold; Fuse_1206_3216Metric; MPN MF-NSMF050-2; LCSC C75464
J5: SCORE SENSORS; PinHeader_1x09_P2.54mm_Vertical; MPN HC-PZ254-11.5L-1x9PZ; LCSC C27985193
J6: BUTTONS; Molex_Mini-Fit_Jr_5566-08A_2x04_P4.20mm_Vertical; MPN 39281083; LCSC C293503
J7: RGB LIGHTS; Molex_Mini-Fit_Jr_39-30-1049_1x04_P4.20mm_Vertical; MPN 39301049; LCSC C587488
J8: PLAYFIELD LIGHTS; Molex_KK-396_A-41791-0002_1x02_P3.96mm_Vertical; MPN 26604020; LCSC C505042
J21: SCORE 0; RJ11_6P4C_TopEntry_StockPads; MPN 955032441; LCSC C588833
J22: SCORE 10; RJ11_6P4C_TopEntry_StockPads; MPN 955032441; LCSC C588833
J23: SCORE 20; RJ11_6P4C_TopEntry_StockPads; MPN 955032441; LCSC C588833
J24: SCORE 30; RJ11_6P4C_TopEntry_StockPads; MPN 955032441; LCSC C588833
J25: SCORE 40; RJ11_6P4C_TopEntry_StockPads; MPN 955032441; LCSC C588833
J26: SCORE 50; RJ11_6P4C_TopEntry_StockPads; MPN 955032441; LCSC C588833
J27, J28: SCORE 100; RJ11_6P4C_TopEntry_StockPads; MPN 955032441; LCSC C588833
Q1, Q2, Q3, Q4: AO3416; SOT-23; MPN AO3416; LCSC C43307
R42, R44, R46, R48, R50, R52, R54, R56, R58, R60, R62, R64: 2.2k; R_0603_1608Metric; tolerance 1%; MPN 0603WAF2201T5E
R43, R45, R47, R49, R51, R53, R55, R57, R59, R61, R63, R65, R67, R69, R71, R73: 4.7k; R_0603_1608Metric; tolerance 1%; MPN 0603WAF4701T5E
R66, R68, R70, R72: 100; R_0603_1608Metric; tolerance 1%; MPN 0603WAF1000T5E
U9, U10, U11: ESDA6V1-5SC6; SOT-23-6; MPN ESDA6V1-5SC6; LCSC C6650

Connections:
+3V3: R42.2, R44.2, R46.2, R48.2, R50.2, R52.2, R54.2, R56.2, R58.2, R60.2, R62.2, R64.2; also elsewhere on the board
+5V_JACK: F3.2, J21.1, J22.1, J23.1, J24.1, J25.1, J26.1, J27.1, J28.1
+5V_PF: J8.1; also elsewhere on the board
+5V_RGB: J7.1; also elsewhere on the board
+5V_SYS: F3.1; also elsewhere on the board
BTN_B: C69.1, R61.2; also elsewhere on the board
BTN_B_J: J6.3, R60.1, R61.1, U10.6 (IO5)
BTN_C: C70.1, R63.2; also elsewhere on the board
BTN_C_J: J6.2, R62.1, R63.1, U11.1 (IO1)
BTN_D: C71.1, R65.2; also elsewhere on the board
BTN_D_J: J6.1, R64.1, R65.1, U11.3 (IO2)
BTN_START: C68.1, R59.2; also elsewhere on the board
BTN_START_J: J6.4, R58.1, R59.1, U10.5 (IO4)
GND: C60.2, C61.2, C62.2, C63.2, C64.2, C65.2, C66.2, C67.2, C68.2, C69.2, C70.2, C71.2, J5.1, J6.5, J6.6, J6.7, J6.8, J21.4, J22.4, J23.4, J24.4, J25.4, J26.4, J27.4, J28.4, Q1.2 (S), Q2.2 (S), Q3.2 (S), Q4.2 (S), R67.2, R69.2, R71.2, R73.2, U9.2 (GND), U10.2 (GND), U11.2 (GND); also elsewhere on the board
LED_B_K: J7.4, Q3.3 (D)
LED_G_K: J7.3, Q2.3 (D)
LED_PF_K: J8.2, Q4.3 (D)
LED_R_K: J7.2, Q1.3 (D)
LIGHT_B: R70.1; also elsewhere on the board
LIGHT_B_G: Q3.1 (G), R70.2, R71.1
LIGHT_G: R68.1; also elsewhere on the board
LIGHT_G_G: Q2.1 (G), R68.2, R69.1
LIGHT_PF: R72.1; also elsewhere on the board
LIGHT_PF_G: Q4.1 (G), R72.2, R73.1
LIGHT_R: R66.1; also elsewhere on the board
LIGHT_R_G: Q1.1 (G), R66.2, R67.1
SC_10: C61.1, R45.2; also elsewhere on the board
SC_10_J: J5.7, J22.2, R44.1, R45.1, U9.3 (IO2)
SC_20: C62.1, R47.2; also elsewhere on the board
SC_20_J: J5.6, J23.2, R46.1, R47.1, U9.4 (IO3)
SC_30: C63.1, R49.2; also elsewhere on the board
SC_30_J: J5.5, J24.2, R48.1, R49.1, U9.5 (IO4)
SC_40: C64.1, R51.2; also elsewhere on the board
SC_40_J: J5.4, J25.2, R50.1, R51.1, U9.6 (IO5)
SC_50: C65.1, R53.2; also elsewhere on the board
SC_50_J: J5.3, J26.2, R52.1, R53.1, U10.1 (IO1)
SC_100A: C66.1, R55.2; also elsewhere on the board
SC_100A_J: J5.9, J27.2, R54.1, R55.1, U10.3 (IO2)
SC_100B: C67.1, R57.2; also elsewhere on the board
SC_100B_J: J5.2, J28.2, R56.1, R57.1, U10.4 (IO3)
SC_GUTTER: C60.1, R43.2; also elsewhere on the board
SC_GUTTER_J: J5.8, J21.2, R42.1, R43.1, U9.1 (IO1)

Notes on the sheet:
Score sensors, buttons, light drivers

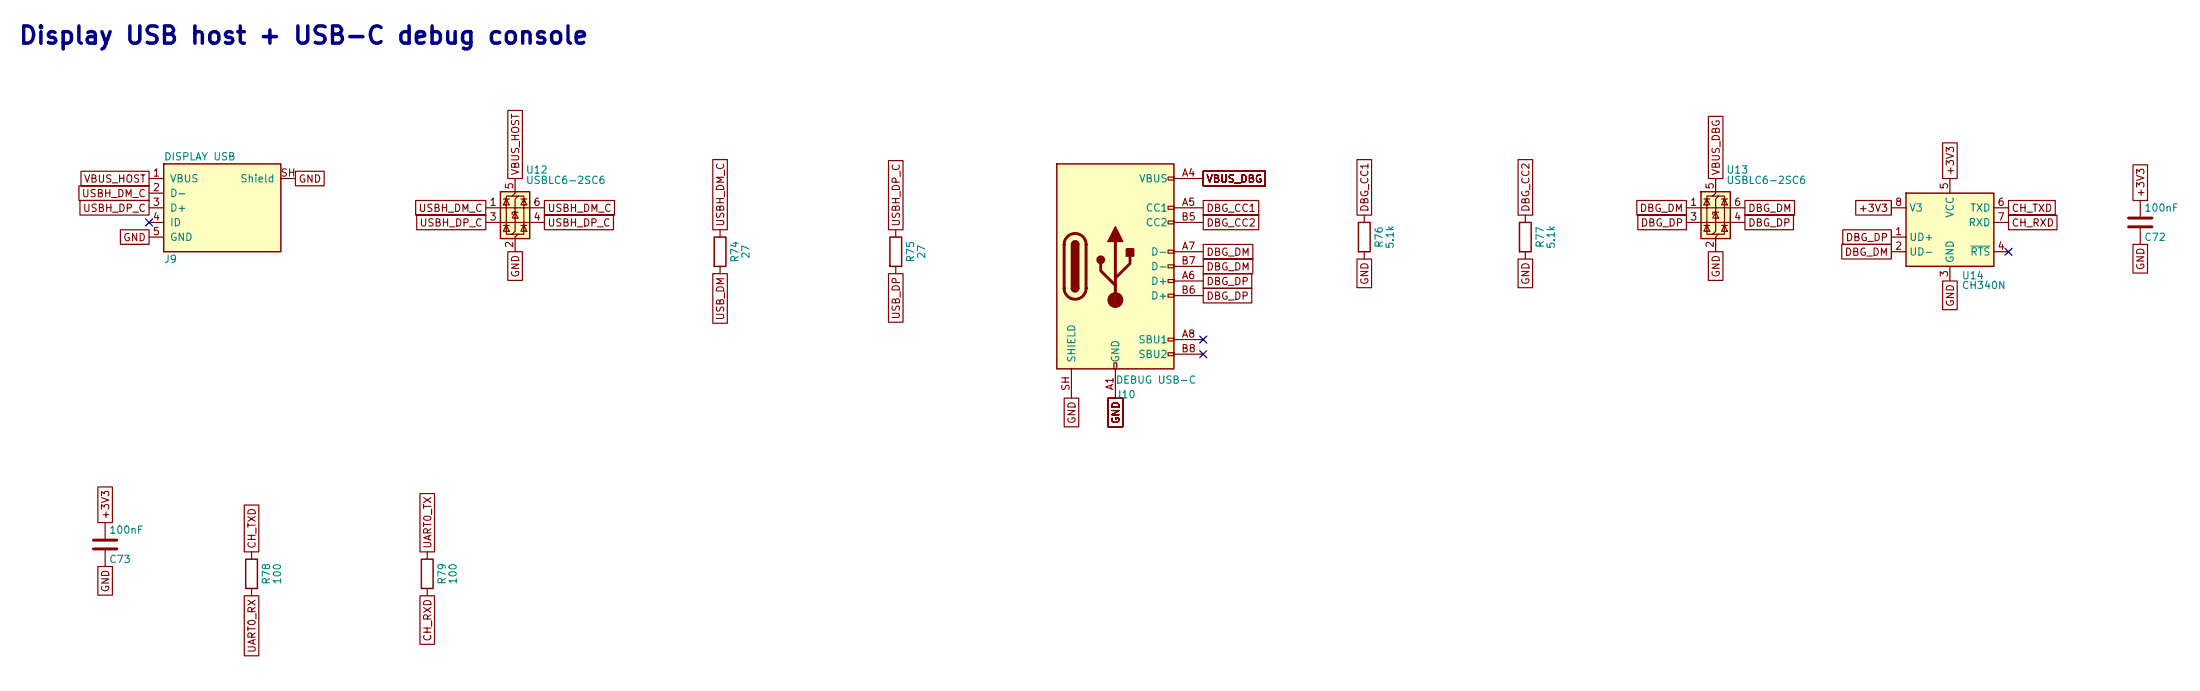
[picture p51: schematic usb.kicad_sch, Display USB host + USB-C debug console]

Parts:
C72, C73: 100nF; C_0603_1608Metric; MPN CC0603KRX7R9BB104
J9: DISPLAY USB; USB_Micro-B_Amphenol_10118194-0001LF_Horizontal; MPN 10118194-0001LF; LCSC C132563
J10: DEBUG USB-C; USB_C_Receptacle_HRO_TYPE-C-31-D-15_Vertical; MPN TYPE-C-31-D-15; LCSC C22464480
R74, R75: 27; R_0603_1608Metric; tolerance 1%; MPN 0603WAF270JT5E
R76, R77: 5.1k; R_0603_1608Metric; tolerance 1%; MPN 0603WAF5101T5E
R78, R79: 100; R_0603_1608Metric; tolerance 1%; MPN 0603WAF1000T5E
U12, U13: USBLC6-2SC6; SOT-23-6; MPN USBLC6-2SC6; LCSC C7519
U14: CH340N; SOIC-8_3.9x4.9mm_P1.27mm; MPN CH340N; LCSC C2977777

Connections:
+3V3: C72.1, C73.1, U14.5 (VCC), U14.8 (V3); also elsewhere on the board
CH_RXD: R79.2, U14.7 (RXD)
CH_TXD: R78.1, U14.6 (TXD)
DBG_CC1: J10.A5 (CC1), R76.1
DBG_CC2: J10.B5 (CC2), R77.1
DBG_DM: J10.A7 (D-), J10.B7 (D-), U13.1 (I/O1), U13.6 (I/O1), U14.2 (UD-)
DBG_DP: J10.A6 (D+), J10.B6 (D+), U13.3 (I/O2), U13.4 (I/O2), U14.1 (UD+)
GND: C72.2, C73.2, J9.5 (GND), J9.SH (Shield), J10.A1 (GND), J10.A12 (GND), J10.B1 (GND), J10.B12 (GND), J10.SH (SHIELD), R76.2, R77.2, U12.2 (GND), U13.2 (GND), U14.3 (GND); also elsewhere on the board
UART0_RX: R78.2; also elsewhere on the board
UART0_TX: R79.1; also elsewhere on the board
USBH_DM_C: J9.2 (D-), R74.1, U12.1 (I/O1), U12.6 (I/O1)
USBH_DP_C: J9.3 (D+), R75.1, U12.3 (I/O2), U12.4 (I/O2)
USB_DM: R74.2; also elsewhere on the board
USB_DP: R75.2; also elsewhere on the board
VBUS_DBG: J10.A4 (VBUS), J10.A9 (VBUS), J10.B4 (VBUS), J10.B9 (VBUS), U13.5 (VBUS)
VBUS_HOST: J9.1 (VBUS), U12.5 (VBUS); also elsewhere on the board

Notes on the sheet:
Display USB host + USB-C debug console

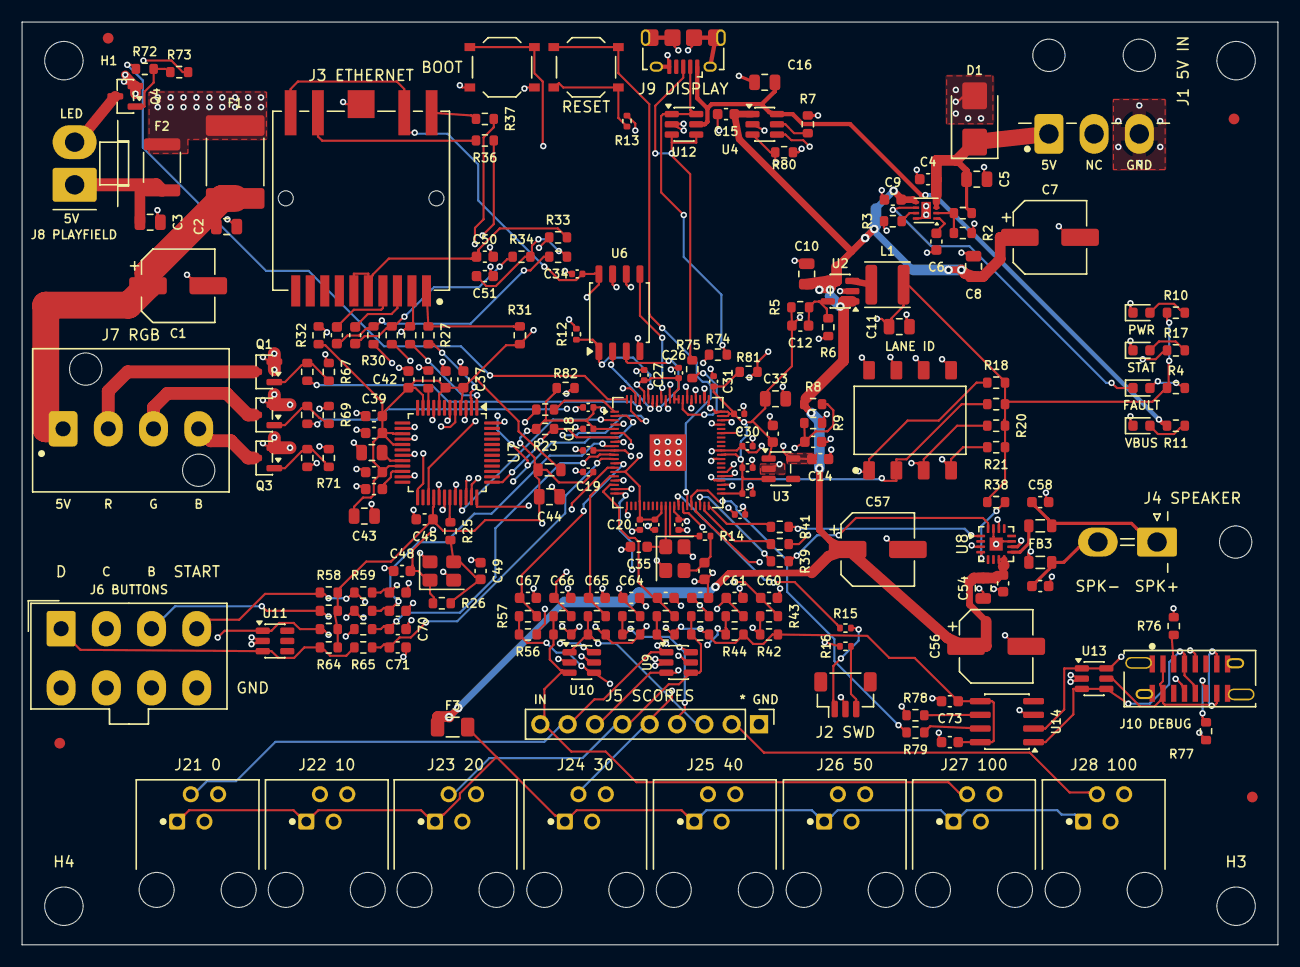
[picture p52: board skeeball-controller.kicad_pcb from above]

Board: 4 copper layers, 116.7 x 85.7 mm, 216 parts (0 on the bottom side), 133 nets.

Other parts of the board:
FID1, FID2, FID3, FID4: Fiducial; Fiducial_1mm_Mask2mm
