mikenemat/skeeball-premium-re/hardware/scripts/qa_copper_landing.py

# ported from din8r-chassis-thermal/scripts/qa_copper_landing.py, 2026-10-26 (SBC-1: board_const for CT layout_const, project facts adapted)
# Origin: DIN-8R scripts/qa_copper_landing.py (C:/work/din-relay-8ch), adapted for CT (din8r-chassis-thermal MAIN).
"""Copper landing gate: every pad is reached by its copper, and every trace end lands (owner rule 2026-10-04).

CT adaptation (2026-10-17): one board kind ("main", 4 layers); POUR_NETS / FORCE_NETS from scripts/board_const.py
(GND / PRTN / VSS planes + the HW-ADVQA2 flyback-cell pours; no force copper); the TRACK-WIDTH budget is CT's
scripts/current_budget.py (basis "budget-path"); the parent's MAIN via-intent manifest (qa_copper_retention, seven
reviewed DIN-8R vias) does not apply - VIA-BARE reports the raw heuristic; TRACK-JOG protects CT's differential pairs
(Ethernet MDI / PHY, USB) by name instead of the parent's HV / Kelvin / MDI netclasses. Everything else is the parent's
check, constant for constant.

Trigger (parent): on the UI B8 work board, a mounting-hole move shifted D1 by 1.7 mm. Its +5V_UI trace was left ending
1.7 mm short of the cathode pad, under the diode body. Only D1's heat-spreader pour still joined them, so KiCad
connectivity and DRC reported nothing. Owner: "It is NEVER acceptable to have errors like an unconnected pad or trace
happen without triggering a serious error", and "Make sure BOTH the unconnected PAD and the short/loose trace are well
captured in testing. Not either/or."

Each check FAILs on its own. A zone fill never stands in for a trace that should reach a pad:
  PAD-OPEN   KiCad connectivity over the stored fills (the board as fabricated): an unconnected item, or a pad on a
             multi-pad net that shares no copper cluster with any other pad of its net.
  PAD-LAND   A pad on a routed net (not in POUR_NETS) with no same-net track / arc or via touching its copper.
  POUR-PAD   A pad on a POUR_NETS net with no track / arc / via landing and no own-net fill touching it.
  TRACK-END  Loose track copper, from two independent detectors; either one firing FAILs. (1) KiCad's own
             TestTrackEndpointDangling (the DRC track_dangling test). (2) Anchored-leaf pruning: ends of different tracks
             within each other's copper are one joint (a track's own two ends never merge), and an end on another track's
             copper is a T-joint. A via is a CONNECTOR, not an end: it joins track copper at endpoints or midspan on
             every layer it spans, and it
             anchors only if a same-net pad touches it or (POUR_NETS) its own net's fill reaches it on one of its layers
             (owner 2026-10-05: a trace into a via that connects to nothing else and lands in no pour is dangling).
             Leaves that are not on a same-net pad or an anchored via are pruned repeatedly; what goes was on no path
             between anchors. This covers a trace that stops short (also inside a pour), a dangling stub, a trace or
             chain ending in a dead via, and an isolated piece. The one allowance: a POUR_NETS track end fully inside
             its own net's fill on that layer (a stitch into the pour), counted in the report.
  VIA-LAND   A via with landings on fewer than two layers: a same-net track / arc or pad touching it, or for POUR_NETS
             an own-net fill.
  LOOP       Same-net, same-layer track copper touching itself where the copper path between the two pieces is longer
             than LOOP_MM (pads and vias are hubs). That is a closed excursion or a doubled-back run.
  PLANE-ISLAND  A filled pour / plane island (stored fills, as fabricated: whatever the zone's island-removal setting
             left) of >= PLANE_ISLAND_MIN_MM2 whose copper component (its pads, tracks, vias and the other islands it
             reaches through them) is not the net's main component (the one with the most pads). Owner 2026-10-06:
             MAIN's +15V HOLDUP plane (C1200-C1205 + Q20.2) was a whole-plane island never tied to the +15V trunk and
             DRC showed it only as one "unconnected" item among many. Every net with zones is checked (no exclusions:
             an intentional split is a separate net name); smaller off-main islands are counted in info.
CLEAN checks (owner 2026-10-05: "Why am I finding ALL of these quality issues": connected is not clean; each of these
passed every check above on the M1 candidate and the owner found them by eye):
  TRACK-DUP     A zero-length segment, or one lying entirely inside another same-net same-layer segment.
  VIA-PADEDGE   A via whose copper overlaps an SMD pad with its centre outside the pad, by a sliver of less than
                PADEDGE_MIN_FRAC of its disc (an accidental kiss landing with no stub), whose DRILL cuts the pad edge
                ("drilled": review M4 M1, the +15V via 0.075 mm outside Q20.2), or touching a FOREIGN pad (a short). A
                same-net via at least that much on the pad with its drill clear of the pad is an intentional pad-edge
                landing (owner 2026-10-05: "a great use of space if INTENTIONAL"), counted in info, not failed. Root
                cause of the Q20 miss (2026-10-05): the intentional class tested the copper overlap only, and for every
                via the boards use (0.45 / 0.20, 0.6 / 0.3, 0.8 / 0.4) a disc >= 25 % on the pad with its centre
                outside can only happen with the drill breaking the pad edge, so the exemption admitted exactly that
                defect. padedge_class() is the ONE
                definition; it also classes a via that does not touch the pad but sits < PADEDGE_GAP_MM from its edge
                ("gap": no room for a mask dam, solder wicks into the via; review M4 / U4). That class is gated by
                qa_layout_quality VIA-PADGAP and joins this check when PADEDGE_GAP_IN_LANDING is switched on (lead,
                after the UI B8.1 release that runs on the current gate set).
  VIA-BARE      A pour-only via with no demonstrated role under the island/density/reach/fence heuristics: every island it touches keeps >= 2 other inter-layer links without it (and, on a fragment >
                STITCH_MIN_MM2, the qa_layout_quality POUR-STITCH density and, for a net with an inner plane, its
                STITCH_REACH_MM reach to a plane-reaching via: same constants). This flags a FUNCTIONAL REVIEW,
                not proof of redundancy: local signal-return, converter/EMI and thermal roles are not modeled.
                Never delete a via solely to clear this finding. FORCE_NETS current-sharing arrays are counted in info, not gated. A locked
                via is NOT exempt (locked legacy fan-out vias outlived their tracks on MAIN). An EDGE-FENCE via (a
                plane-reaching pour-only via within FENCE_EDGE_MM of the board outline with another one within
                FENCE_PITCH_MM: the GND edge guard, lead 2026-10-06) is kept and counted (info fence_vias). A
                VIA_INTENT via (generator-declared, exact net / position, with its function) is counted in info
                via_intent, not gated.
  VIA-PARTIAL   Any via whose copper disc overlaps the copper of an SMD / connector pad (any net), or of a FOREIGN
                plated-hole pad, on a layer where both have copper while its centre lies outside that pad (review M4
                M1; lead 2026-10-05). A via is either in the land (qa_layout_quality VIA-INPAD rules) or clear of it,
                never half on it. A same-net via merging with a plated-hole annulus (no SMT land, no paste) is counted
                in info partial_pth_same_net (UI B8.1: one GND via kissing the USB-C J2.SH shell annulus). This
                excludes VIA-PADEDGE's intentional class (PARTIAL_ALLOW_INTENTIONAL, owner 2026-10-05; an owner
                call: M4 and UI B8.1 hold no intentional pad-edge via with its drill clear of the pad).
  TRACK-ORPHAN  A connected piece of track copper (joined through vias) touching no pad of its net, e.g. a GND chain
                from a pour-only via into the pour. FORCE_NETS generator copper excepted.
  TRACK-JOG     A staircase step (a segment shorter than JOG_W x its width between two bends of opposite turn) that
                FAILs only where a CLEAN local shortcut exists (owner J1, 2026-10-09), evaluated live on every run from
                the native board, its .kicad_dru and netclasses - no allowlist, UUID manifest or waiver (jog_screen):
                the flagged track and its two neighbours are replaced by straight / 45-start / 45-end paths with the
                far endpoints fixed, the max original width, same layer and net. CLEAN = saves > JOG_SAVE_MM, no hard
                violation (native shapes vs foreign tracks / vias / pads under the JogRules DRU + netclass pair model
                incl. local overrides; board edge; foreign / NPTH holes; no-track rule areas; DRU disallow / width),
                no lost same-net pad / via / track overlap or pad-centre landing, no new clearance cut (> JOG_PLANE_CUT_MM2)
                into any foreign stored fill, and an unprotected net / chain (JOG_PROTECTED_*: HV / fault / MDI / coil
                / chassis classes, ISLAND_HIZ, Kelvin / metering names, the +-1V2_BUF / BUF_GOOD_N lanes, width-
                transition chains). Owner option (a), 2026-10-09: a CLEAN shortcut must also add no new
                qa_layout_quality finding and worsen no existing one (jog_quality: qa_layout_quality's own Board and
                check functions, run live on an in-memory copy of the board with the chain replaced, compared with the
                unmodified board under JOG_LQ_SCHEMA over the findings that name the shortcut's net). A site whose
                every clearance-clean shortcut does is info LAYOUT_QUALITY with the exact new / worsened findings.
                PROTECTED never hides a staircase (2026-10-09, owner: staircase jogs are worse than corners): protected
                sites WITH a clean shortcut that chain (shared tracks, same net / layer) into a run of >=
                JOG_STAIR_MIN_SITES steps FAIL as a protected staircase, to be re-routed (pfr2 / smoothing), never
                auto-shortcut. Every other site is an info.jog_screened record with its exact reason (PROTECTED,
                PLANE_CUT, BLOCKED, NO_SAVING, LAYOUT_QUALITY) and per-shortcut evidence. Uncertainty leans to FAIL: a zero-area touch is
                not a contact, unmodelled relaxations (creepage) are ignored, an unmodelled DRU construct makes the
                check error out (exit 2), and a layout-quality comparison that cannot be evaluated or demonstrate a
                worsening (error, schema drift, a rise within rounding) leaves the shortcut CLEAN.
  PAD-CENTRE    A trace terminating on an SMD pad away from the pad centre (> PAD_CENTRE_TOL): traces run FROM THE
                CENTRE of a pad (owner 2026-10-05), never stop at its edge. FORCE_NETS pads excepted.
  TRACK-WIDTH   Current-carrying copper below its REQUIRED width, except a <= NECK_MM neck-down into a same-net pad no wider
                than the required width (FORCE_NETS: their manifest). Basis current_budget.WIDTH_BASIS: CT "budget-path":
                every net in current_budget.BUDGET (PoE input, flyback primary / secondary, +12V, fan rail and ports,
                VBUS / buck / +3V3, GND) at required_width() = max(class width from the board's .kicad_pro, IPC-2152
                width of its load current at 10 K and of its sustained fault current at 40 K, per outer / inner copper
                weight) on its SUPPLY PATH; a track on a leaf branch leading only to R / C pads (decoupling, pull-ups)
                keeps its class width (budget_leaf_tracks); an unbudgeted current class / rail falls back to its class
                width; a track that alone feeds a current_budget.BRANCHES entry's parts is sized for that branch (none
                on CT rev A); impedance nets at their qualified width (none on CT rev A: no impedance control). KiCad
                DRC never enforces class widths (owner 2026-10-05: "a validation rule that looks at trace width for
                appropriate nets as a part of every cleaning pass").
                FOREIGN-OBJECT NECK (owner LVW-NECKS-20261009, budget bases only, evaluated live, no list): a piece
                below its required width is excused only if ALL hold: (a) it is <= NECK_FOREIGN_MM long; (b) its width
                is >= NECK_FOREIGN_MIN_FRAC x required; (c) the 1-D conduction rise I^2 rho L^2 / (c k A^2) of its
                whole NECK RUN (every touching same-net same-layer piece below its required width: summed length,
                narrowest section, largest gate current max(load, fault) of the pieces' own budget, the gate's
                current_budget.STACKUP thickness; c = 8 only when every run end lands on a same-net track at full
                required width, else 2) is <= NECK_FOREIGN_MAX_DT_K; (d) the piece re-drawn natively at the required
                width on its own centreline Collides with a FOREIGN track / via / pad within its required clearance
                (JogRules pair model, local overrides) + the board DRC epsilon, or its hole within the hole clearance
                + epsilon - a genuine neck. Excused pieces are listed in info width_foreign_necks; a failing
                candidate's row carries its foreign_neck evaluation. Everything else FAILs.
No waivers. KiCad Python: local_run.py qa_copper_landing.py BOARD [--json OUT] [--checks A,B]. Exit 0 PASS, 1 FAIL,
2 error. Releases and adoptions run ALL checks. --checks exists only for a board that is not routed yet (the merged MAIN
build before routing): TRACK-END,VIA-LAND,LOOP prove the part moves left no loose or looped copper. PAD-OPEN and PAD-LAND
then wait for the routed board.
"""
import argparse
import copy
import heapq
import json
import math
import re
import sys
from collections import defaultdict
from pathlib import Path

sys.path.insert(0, str(Path(__file__).resolve().parent))
import board_const as K  # noqa: E402  (first: tools/pylib shapely for KiCad's Python)
import pcbnew  # noqa: E402
import current_budget as cb  # noqa: E402
from shapely.geometry import LineString, Point, Polygon, box  # noqa: E402
from shapely.ops import substring, unary_union  # noqa: E402
from shapely.prepared import prep  # noqa: E402
from shapely.strtree import STRtree  # noqa: E402

LOOP_MM = 1.0
# Nets whose pads may connect through a pour (board_const.POUR_NETS: GND / PRTN / VSS planes and pours, and the
# deliberate flyback-cell pours of the HW-ADVQA2 ECO). Every other net is routed: each pad needs a trace or via
# landing; a zone of a routed net (a heat spreader) never stands in for it (the parent's D1 case).
POUR_NETS = {"main": set(K.POUR_NETS)}
HOLE_MM2 = 0.01                                   # a cycle whose copper encloses more open area than this is a ring
# Generator high-current copper (the parent's force pours): none on CT
FORCE_NETS = {"main": set(K.FORCE_NETS)}
JOG_W = 2.0                                       # TRACK-JOG: a step shorter than this many track widths
PAD_CENTRE_TOL = 0.02                             # PAD-CENTRE: a trace end on a pad within this of its centre
PADEDGE_MIN_FRAC = 0.25                          # VIA-PADEDGE: a same-net via this much on the pad is deliberate
PADEDGE_GAP_MM = 0.10                            # VIA-PADEDGE: a via disc this close to an SMD pad edge (no overlap)
PADEDGE_GAP_IN_LANDING = False                   # gap class gated here too (lead switches on after UI B8.1)
PARTIAL_ALLOW_INTENTIONAL = True                 # VIA-PARTIAL: exempt VIA-PADEDGE's intentional class (owner 2026-10-05: "pad-edge vias can be a great use of space if INTENTIONAL"; drilled-edge vias still FAIL)
# Stitch density, shared with qa_layout_quality POUR-STITCH (it imports these): VIA-BARE keeps any via a fragment needs
# to reach max(STITCH_MIN_VIAS, area / STITCH_MM2_PER_VIA) links (B8.1: the two gates demanded and forbade the same vias)
STITCH_MIN_MM2 = 5.0
STITCH_MM2_PER_VIA = 25.0
STITCH_MIN_VIAS = 2
# Stitch REACH, shared the same way (lead 2026-10-05): on a net with an inner plane, VIA-BARE keeps a pour-only via whose
# removal would leave a point of an outer fragment > STITCH_MIN_MM2 farther than STITCH_REACH_MM from every
# plane-reaching via / plated hole (B8.1 cleanup deleted reach-only stitches that POUR-STITCH then demanded)
STITCH_REACH_MM = 5.0
STITCH_REACH_TOL_MM2 = 0.05                     # uncovered area below this is rounding
ISLAND_MIN_MM2 = 1.0                            # VIA-BARE: smaller pad/track-less fill fragments need no stitch
# VIA-BARE edge fence (lead 2026-10-06: a 2.4 GHz board wants its GND edge guard stitched at <= lambda/20 ~ 6 mm, which
# the reach rule alone calls redundant): a pour-only via that reaches the net's inner plane, sits within FENCE_EDGE_MM of
# the board outline (outer edge, slot or cut-out) and has another such via within FENCE_PITCH_MM is a fence via, kept
# and counted (info fence_vias). A lone near-edge via, or one farther in, is judged by the island rules as before.
FENCE_EDGE_MM = 1.5
FENCE_PITCH_MM = 5.0
# VIA-BARE via intent (D-LAYOUT-GATES #8, root-reviewed): generator-declared pour-only vias of the HW-ADVQA2 power
# cell whose function the island heuristics cannot see (current sharing, hot-loop return); exact net / position
# (+-VIA_INTENT_TOL_MM), counted in info via_intent, never a finding. Anything else stays judged.
WHY_12V = 'D6 cathode copper ECO_12V_F <-> ECO_12V_B current site (VIA-CURRENT: 1.673 A / 2.1 A, 2 x 0.3 mm per site)'
WHY_VPP = 'T2.5 / C12 / C13 -> bottom RCD clamp copper (primary RMS 0.985 / 1.817 A, clamp heat path)'
WHY_PRTN = 'flyback cell return -> In1 PRTN plane (hot-loop return, low loop inductance; qa_power_layout loop budget)'
WHY_GNDW = 'W5500 in-body GND site partner of (39.45, 28.9) (VIA-CURRENT: GND budget 1.673 A, 2 x 0.3 mm per site)'
WHY_GNDNE = 'release-candidate GND via pair NE of Q13 (r27p): a 2-via VIA-CURRENT site; deleting either one re-opens VIA-CURRENT and leaves a 9 mm2 B.Cu GND fragment with 0 vias (POUR-STITCH)'
VIA_INTENT = {"main": {}}   # SBC-1: none declared (CT's rows were CT power-cell positions)
VIA_INTENT_TOL_MM = 0.01
# TRACK-WIDTH: the width rule and the per-net current budget live in current_budget.py (ONE source, also read by the
# MAIN router pfr2.py). Basis per board = current_budget.WIDTH_BASIS: MAIN "budget" (required = max(class width,
# IPC-2152 load / fault width)), UI "class" (current classes / rails by name never below the class width, impedance
# classes at it; kept for the B8.1 release, lead 2026-10-05).
CURRENT_CLASSES = cb.CURRENT_CLASSES
IMPEDANCE_CLASSES = cb.IMPEDANCE_CLASSES
RAIL_RE = cb.RAIL_RE
NECK_MM = cb.NECK_MM                              # TRACK-WIDTH: a neck-down this long into a narrower same-net pad
# TRACK-WIDTH foreign-object neck (owner LVW-NECKS-20261009). NECK_FOREIGN_MM: 1.2 mm = the in-plane thermal healing
# length sqrt(k_cu t d / (2 k_FR4)) of the thinnest MAIN copper (inner at the IPC-6012 Class 2 floor, 11.4 um; planes
# d = 0.2 mm away on both faces; k_cu 390, k_FR4 0.3 W/mK) = 1.217 mm, rounded DOWN to 0.1 mm (nominal 15.2 um inner:
# 1.41 mm; 70 um outer: 3.0 mm). A piece no longer than that is a local feature whose ends are held by the adjacent
# full-width copper, the regime of the end-anchored 1-D bound in (c); it also covers the longest owner-cited In4 neck
# piece (1.16 mm). NECK_FOREIGN_MIN_FRAC: 0.94 - even as an infinitely long conductor such a section rises <= ~43.8 K on
# the gate's own IPC-2152 fit where 40 K is required (live: ipc_rise_k), and 6 % lies inside the +-10 % conductor-width
# tolerance the PROCESS screen already carries; the owner-cited necks are >= 0.947. NECK_FOREIGN_MAX_DT_K: owner, 1 K.
# 1-D constants as the owner-cited main_lv_fault_hold_closure necks_vias.py (0.22 K for 1.029 x 1.16 mm at 2.24 A):
# rho(20 C) 1.724e-8 Ohm m, alpha 0.00393 / K at NECK_CU_T_C 125 C (60 C box + 40 K fault rise + margin), k 380 W/mK.
NECK_FOREIGN_MM = 1.2
NECK_FOREIGN_MIN_FRAC = 0.94
NECK_FOREIGN_MAX_DT_K = 1.0
NECK_CU_T_C = 125.0
CU_RHO20 = 1.724e-8
CU_ALPHA = 0.00393
CU_K = 380.0
PLANE_ISLAND_MIN_MM2 = 2.0                        # PLANE-ISLAND: smaller off-main fill islands (thermal slivers) are
                                                  # counted in info (plane_islands_below_min), not failed
CHECKS = ("PAD-OPEN", "PAD-LAND", "POUR-PAD", "TRACK-END", "VIA-LAND", "LOOP", "PLANE-ISLAND",
          "TRACK-DUP", "VIA-PADEDGE", "VIA-PARTIAL", "VIA-BARE", "TRACK-ORPHAN", "TRACK-JOG", "PAD-CENTRE", "TRACK-WIDTH")
mm = pcbnew.ToMM


def board_kind(b):
    """CT has one board kind; a board without copper layers is a tool error"""
    if b.GetCopperLayerCount() < 2:
        raise ValueError(f"board has {b.GetCopperLayerCount()} copper layers")
    return K.KIND


def V(q):
    return pcbnew.VECTOR2I(pcbnew.FromMM(q[0]), pcbnew.FromMM(q[1]))


def P(v):
    return (round(mm(v.x), 4), round(mm(v.y), 4))


def where(q):
    return f"({q[0]:.3f}, {q[1]:.3f})"


def to_shapely(ps):
    polys = []
    for i in range(ps.OutlineCount()):
        o = ps.Outline(i)
        shell = [(mm(o.CPoint(k).x), mm(o.CPoint(k).y)) for k in range(o.PointCount())]
        holes = [[(mm(h.CPoint(k).x), mm(h.CPoint(k).y)) for k in range(h.PointCount())]
                 for h in (ps.Hole(i, j) for j in range(ps.HoleCount(i)))]
        if len(shell) >= 3:
            polys.append(Polygon(shell, [h for h in holes if len(h) >= 3]).buffer(0))
    return unary_union(polys) if polys else Polygon()


def pad_ref(p):
    return f"{p.GetParentFootprint().GetReference()}.{p.GetNumber()}"


def padedge_class(pad_poly, centre, radius, same_net, drill_r=None):
    """VIA-PADEDGE: one via disc (centre Point, radius mm; drill radius drill_r when known) against one SMD pad polygon
    on one shared copper layer. -> (class, overlap_mm2, gap_mm); class None = clean (no contact and >= PADEDGE_GAP_MM
    away, or centre in the pad: via-in-pad is qa_layout_quality VIA-INPAD), "intentional" (same net, >=
    PADEDGE_MIN_FRAC of the disc on the pad, drill clear of the pad), "drilled" (same net, that much on the pad, but the
    drill cuts the pad edge), "edge" (same-net sliver), "foreign" (touches a foreign pad), "gap" (no overlap, edge gap
    < PADEDGE_GAP_MM). A caller passing no drill_r (qa_layout_quality VIA-PADGAP) uses only the "gap" class."""
    if pad_poly.contains(centre):
        return None, 0.0, 0.0
    disc = centre.buffer(radius)
    ov = pad_poly.intersection(disc).area
    if ov <= 1e-4:
        gap = max(0.0, pad_poly.distance(centre) - radius)
        return ("gap" if gap < PADEDGE_GAP_MM else None), ov, gap
    if same_net and ov >= PADEDGE_MIN_FRAC * disc.area:
        if drill_r and pad_poly.intersects(centre.buffer(drill_r)):
            return "drilled", ov, 0.0
        return "intentional", ov, 0.0
    return ("edge" if same_net else "foreign"), ov, 0.0


# ---------------------------------------------------------------- TRACK-JOG native rule model (owner J1, 2026-10-09)
# A jog FAILs only where a CLEAN local shortcut exists, evaluated live on every run from the native board, its
# .kicad_dru and its netclasses (no allowlist, no UUID manifest, no waiver). Protected nets / chains are reported in
# info, never shortened by this gate's demand.
# CT: no protected netclasses (its classes are PoE / Power / Rail / Default); the differential pairs are protected by
# name (a one-leg shortcut changes the pair skew - the parent protected its MDI class for the same reason): Ethernet
# MDI (cable side of T1), PHY (T1 <-> W5500 side) and USB D+ / D-. Their staircases still FAIL (JOG_STAIR_MIN_SITES).
JOG_PROTECTED_CLASSES = set()
JOG_PROTECTED_NET_RE = re.compile(r"^(MDI_(TX|RX)_[PN]|PHY_(TX|RX)_[PN]|ETH_(TX|RX)[PN]|USB_(C_)?D[PN])$")
JOG_PROTECTED_NETS = set()
JOG_SAVE_MM = 1e-6                                # a shortcut must save more than this
JOG_STAIR_MIN_SITES = 3                           # PROTECTED jogs with a clean shortcut chained into a run of this
                                                  # many steps are a staircase: FAIL (re-route, never auto-shortcut)
JOG_PLANE_CUT_MM2 = 1e-4                          # new clearance cut into a foreign stored fill above this is a cut
JOG_KEEPOUT_MM2 = 1e-6                            # new copper inside a no-track rule area above this is a violation
_DRU_UNITS = {"mm": 1.0, "mil": 0.0254, "in": 25.4, "um": 0.001}
# constraint types that never bind a new track against another item (via / hole sizes) or are dominated by the
# matching clearance (creepage >= the same-valued clearance on one layer; unmodelled = lenient = the jog FAILs)
_DRU_IGNORED = {"via_diameter", "hole_size", "annular_width", "creepage", "via_count", "length", "skew",
                "diff_pair_gap", "diff_pair_uncoupled", "thermal_relief_gap", "thermal_spoke_width",
                "min_resolved_spokes", "zone_connection", "silk_clearance", "text_height", "text_thickness",
                "courtyard_clearance", "solder_mask_expansion", "solder_paste_abs_margin",
                "solder_paste_rel_margin", "hole_to_hole", "microvia_diameter", "microvia_drill"}


class _KStr(str):
    """KiCad expression string: case-insensitive, wildcard (* ?) equality."""
    __hash__ = str.__hash__

    def __eq__(self, other):
        import fnmatch
        o = str(other).lower()
        s = str.lower(self)
        return fnmatch.fnmatchcase(s, o) or fnmatch.fnmatchcase(o, s)

    def __ne__(self, other):
        return not self.__eq__(other)


def _sexp(text):
    text = "\n".join(x for x in text.splitlines() if not x.lstrip().startswith("#"))
    stack = [[]]
    for m in re.finditer(r'"((?:[^"\\]|\\.)*)"|(\()|(\))|([^\s()"]+)', text):
        if m.group(2):
            stack.append([])
        elif m.group(3):
            if len(stack) < 2:
                raise ValueError("DRU: unbalanced ')'")
            x = stack.pop()
            stack[-1].append(x)
        elif m.group(1) is not None:
            stack[-1].append(_KStr(m.group(1)))
        else:
            stack[-1].append(m.group(4))
    if len(stack) != 1:
        raise ValueError("DRU: unbalanced '('")
    return stack[0]


def _dru_value(s):
    m = re.fullmatch(r"([-+]?[0-9]*\.?[0-9]+)(mm|mil|in|um)", str(s).strip())
    if not m:
        raise ValueError(f"DRU value not modelled: {s!r}")
    return float(m.group(1)) * _DRU_UNITS[m.group(2)]


_COND_TOK = re.compile(r"\s*(?:(?P<s>'[^']*')|(?P<op>&&|\|\||==|!=|!|\(|\))|(?P<id>[AB]\.[A-Za-z_]+))")
_COND_FUNCS = {"hasNetclass", "memberOfFootprint", "intersectsFrontCourtyard", "intersectsBackCourtyard",
               "intersectsCourtyard", "intersectsArea", "enclosedByArea"}
_COND_PROPS = {"Type", "Net", "NetName", "Layer"}


def _compile_cond(src):
    """KiCad rule condition -> (code, sides used). Anything outside the modelled subset raises (fail closed)."""
    out, pos, uses, src = [], 0, set(), str(src).strip()
    while pos < len(src):
        m = _COND_TOK.match(src, pos)
        if not m or m.end() == pos:
            raise ValueError(f"DRU condition not modelled at {src[pos:pos + 40]!r}")
        pos = m.end()
        if m.group("s"):
            out.append(f"_KStr({m.group('s')[1:-1]!r})")
        elif m.group("op"):
            out.append({"&&": " and ", "||": " or ", "!": " not "}.get(m.group("op"), m.group("op")))
        else:
            side, attr = m.group("id").split(".")
            uses.add(side)
            if attr in _COND_FUNCS:
                m2 = re.compile(r"\s*\(\s*'([^']*)'\s*\)").match(src, pos)
                if not m2:
                    raise ValueError(f"DRU condition not modelled: {attr} arguments")
                pos = m2.end()
                out.append(f"{side}.f({attr!r}, {m2.group(1)!r})")
            elif attr in _COND_PROPS:
                out.append(f"{side}.p({attr!r})")
            else:
                raise ValueError(f"DRU condition not modelled: {side}.{attr}")
        while pos < len(src) and src[pos].isspace():
            pos += 1
    expr = "".join(out)
    return compile(expr or "True", "<kicad_dru>", "eval"), uses


class _RuleItem:
    """One item as the DRU expressions see it."""

    def __init__(self, env, kind, net_code, net_name, classes, layer, ref=None, geo=None, layers=()):
        self.env, self.kind, self.net_code, self.net_name = env, kind, net_code, net_name
        self.classes, self.layer, self.ref, self._geo, self.layers = classes, layer, ref, geo, set(layers)

    def geo(self):
        g = self._geo() if callable(self._geo) else self._geo
        self._geo = g
        return g

    def p(self, name):
        if name == "Type":
            return _KStr(self.kind)
        if name == "Net":
            return self.net_code
        if name == "NetName":
            return _KStr(self.net_name)
        return _KStr(self.env.lname(self.layer))

    def f(self, fn, arg):
        if fn == "hasNetclass":
            return any(_KStr(c) == arg for c in self.classes)
        if fn == "memberOfFootprint":
            return self.ref is not None and _KStr(self.ref) == arg
        if fn in ("intersectsFrontCourtyard", "intersectsBackCourtyard", "intersectsCourtyard"):
            sides = {"intersectsFrontCourtyard": ("F",), "intersectsBackCourtyard": ("B",)}.get(fn, ("F", "B"))
            return any(self.geo().intersects(c) for s in sides for c in self.env.courtyards(arg, s))
        areas = self.env.areas(arg)
        if fn == "intersectsArea":
            return any(self.layers & ls and self.geo().intersects(g) for g, ls in areas)
        return any(self.layers & ls and g.buffer(1e-6).contains(self.geo()) for g, ls in areas)     # enclosedByArea


class JogRules:
    """Native pair-rule model for the TRACK-JOG shortcut screen: the board's .kicad_dru (KiCad semantics: the LAST
    matching rule of a constraint type wins, conditions tried both ways round, layer clauses honoured), netclass
    clearances, native local clearance overrides (which take precedence, floored at the board minimum), zone
    clearances for stored fills, board edge / hole clearances. A construct outside the modelled subset raises
    (fail closed: the check errors). An unmodelled clearance relaxation can only make a jog FAIL."""

    def __init__(self, b, pcb):
        self.b, self.lname = b, b.GetLayerName
        ds = b.GetDesignSettings()
        self.min_clear = mm(ds.m_MinClearance)
        self.hole_clear = mm(ds.m_HoleClearance)
        self.edge_clear = mm(ds.m_CopperEdgeClearance)
        self.eps = mm(ds.GetDRCEpsilon())
        self.ns = ds.m_NetSettings
        self.rules = []
        dru = Path(str(pcb)).with_suffix(".kicad_dru")
        if dru.exists():
            self._parse(dru.read_text(encoding="utf-8"))
        self._nc, self._cy, self._ar = {}, {}, {}
        self.max_rule = max([c[1] for r in self.rules for c in r["constraints"] if c[0] == "clearance"] + [0.0])

    def _parse(self, text):
        for node in _sexp(text):
            if not isinstance(node, list) or not node or node[0] != "rule":
                if isinstance(node, list) and node and node[0] == "version":
                    continue
                raise ValueError(f"DRU: unexpected top-level {node!r}")
            rule = {"name": str(node[1]), "layer": None, "cond": None, "uses": set(), "constraints": []}
            for x in node[2:]:
                if not isinstance(x, list) or not x:
                    raise ValueError(f"DRU rule {rule['name']}: unexpected {x!r}")
                if x[0] == "layer":
                    rule["layer"] = str(x[1])
                elif x[0] == "condition":
                    rule["cond"], rule["uses"] = _compile_cond(x[1])
                elif x[0] == "severity":
                    continue
                elif x[0] == "constraint":
                    kind = str(x[1])
                    if kind == "disallow":
                        rule["constraints"].append(("disallow", {str(y) for y in x[2:]}))
                    elif kind in ("clearance", "track_width"):
                        mins = [_dru_value(y[1]) for y in x[2:] if isinstance(y, list) and y[0] == "min"]
                        if mins:
                            rule["constraints"].append((kind, mins[0]))
                    elif kind not in _DRU_IGNORED:
                        raise ValueError(f"DRU constraint not modelled for TRACK-JOG: {kind} ({rule['name']})")
                else:
                    raise ValueError(f"DRU rule {rule['name']}: unexpected clause {x[0]!r}")
            self.rules.append(rule)

    def layer_ok(self, rule, layer):
        sel = rule["layer"]
        if sel is None:
            return True
        outer = layer in (pcbnew.F_Cu, pcbnew.B_Cu)
        if sel == "outer":
            return outer
        if sel == "inner":
            return not outer
        return _KStr(sel) == self.lname(layer)

    def match(self, rule, a, b, layer):
        if not self.layer_ok(rule, layer):
            return False
        if rule["cond"] is None:
            return True
        env = {"_KStr": _KStr, "A": a, "B": b}
        if b is None and "B" in rule["uses"]:
            raise ValueError(f"DRU rule {rule['name']}: single-item constraint reads B")
        return bool(eval(rule["cond"], {"__builtins__": {}}, env))

    def nc_clearance(self, classes):
        key = tuple(classes)
        if key not in self._nc:
            best = None
            for c in classes:
                nc = self.ns.GetNetClassByName(c)
                if nc is not None and nc.HasClearance() and (best is None or nc.GetPriority() < best[0]):
                    best = (nc.GetPriority(), mm(nc.GetClearance()))
            if best is None:
                best = (0, mm(self.ns.GetDefaultNetclass().GetClearance()))
            self._nc[key] = best[1]
        return self._nc[key]

    def clearance(self, a, b, layer, override=None, zone_clear=None):
        """Required copper clearance between new item a and foreign item b on layer (mm)."""
        if override:
            return max(max(override), self.min_clear), "local override"
        val = None
        for r in self.rules:
            for kind, v in r["constraints"]:
                if kind == "clearance" and (self.match(r, a, b, layer) or self.match(r, b, a, layer)):
                    val = (v, r["name"])
        if val is None:
            v = max(self.nc_clearance(a.classes), self.nc_clearance(b.classes), zone_clear or 0.0)
            val = (v, "netclass" if not zone_clear or zone_clear <= v - 1e-9 else "zone clearance")
        return max(val[0], self.min_clear), val[1]

    def single(self, a, layer, width):
        """Disallow / track_width violations of new track a alone."""
        out = []
        for r in self.rules:
            for kind, v in r["constraints"]:
                if kind == "disallow" and "track" in v and self.match(r, a, None, layer):
                    out.append({"kind": "rule disallow", "rule": r["name"]})
        tw = [(v, r["name"]) for r in self.rules for kind, v in r["constraints"]
              if kind == "track_width" and self.match(r, a, None, layer)]
        if tw and width < tw[-1][0] - 1e-6:
            out.append({"kind": "rule track_width", "rule": tw[-1][1], "min_mm": tw[-1][0]})
        return out

    def courtyards(self, ref, side):
        k = (str(ref).lower(), side)
        if k not in self._cy:
            polys = []
            for fp in self.b.GetFootprints():
                if _KStr(fp.GetReference()) == ref:
                    ps = fp.GetCourtyard(pcbnew.F_CrtYd if side == "F" else pcbnew.B_CrtYd)
                    g = to_shapely(ps)
                    if not g.is_empty:
                        polys.append(g)
            self._cy[k] = polys
        return self._cy[k]

    def areas(self, name):
        k = str(name).lower()
        if k not in self._ar:
            self._ar[k] = [(to_shapely(z.Outline()), set(z.GetLayerSet().CuStack())) for z in self.b.Zones()
                           if _KStr(z.GetZoneName()) == name]
        return self._ar[k]


def _arc_line(t, n=48):
    """Polyline through a native arc (start -> end via mid), for indexing / reporting only."""
    import cmath
    a, m, e = (complex(*P(x)) for x in (t.GetStart(), t.GetArcMid() if hasattr(t, "GetArcMid") else t.GetMid(),
                                        t.GetEnd()))
    c = complex(*P(t.GetCenter()))
    r = abs(a - c)
    t0, t1, tm = (cmath.phase(z - c) for z in (a, e, m))

    def norm(x):
        return x % (2 * math.pi)
    sweep = norm(t1 - t0)
    if norm(tm - t0) > sweep:
        sweep -= 2 * math.pi
    pts = [c + r * cmath.exp(1j * (t0 + sweep * k / n)) for k in range(n + 1)]
    return LineString([(z.real, z.imag) for z in pts])


def _edge_lines(b):
    """Edge.Cuts geometry at zero width (as KiCad's edge-clearance test uses it), board and footprint items."""
    out = []
    items = [d for d in b.GetDrawings() if d.GetLayer() == pcbnew.Edge_Cuts]
    for fp in b.GetFootprints():
        items += [d for d in fp.GraphicalItems() if d.GetLayer() == pcbnew.Edge_Cuts]
    for d in items:
        st = d.GetShape()
        if st == pcbnew.SHAPE_T_SEGMENT:
            out.append(LineString([P(d.GetStart()), P(d.GetEnd())]))
        elif st == pcbnew.SHAPE_T_ARC:
            out.append(_arc_line(d, 256))
        elif st == pcbnew.SHAPE_T_CIRCLE:
            out.append(Point(P(d.GetCenter())).buffer(mm(d.GetRadius()), 256).exterior)
        elif st == getattr(pcbnew, "SHAPE_T_RECTANGLE", getattr(pcbnew, "SHAPE_T_RECT", None)):
            x0, y0 = P(d.GetStart())
            x1, y1 = P(d.GetEnd())
            out.append(LineString([(x0, y0), (x1, y0), (x1, y1), (x0, y1), (x0, y0)]))
        elif st == pcbnew.SHAPE_T_POLY:
            out.append(to_shapely(d.GetPolyShape()).boundary)
        else:
            raise ValueError(f"TRACK-JOG: Edge.Cuts shape {d.GetShapeStr()} not modelled")
    return out


def jog_screen(b, pcb, sites, tracks):
    """TRACK-JOG CLEAN-shortcut screen (owner J1, 2026-10-09). For each jog (flagged segment + its two neighbours,
    far endpoints fixed, max original width, same layer / net) try straight, 45-start and 45-end. A shortcut is
    CLEAN when it saves length, breaks no hard clearance (foreign tracks / vias / pads with native shapes and the
    JogRules pair model; board edge; foreign / NPTH holes; no-track rule areas; DRU disallow / width rules), loses no
    same-net pad / via / track contact or pad-centre landing, and cuts no new clearance into any foreign stored fill.
    -> per site {"status": "FAIL" (clean shortcut, unprotected) | "PROTECTED" | "PLANE_CUT" | "BLOCKED" |
    "NO_SAVING", ...evidence}."""
    rules = JogRules(b, pcb)
    lname = b.GetLayerName
    eps_iu = b.GetDesignSettings().GetDRCEpsilon()

    def classes_of(item):
        return tuple(x for x in item.GetNetClassName().split(",") if x) or ("Default",)

    objs = []                                     # every copper item, any net (net 0 included)
    per_layer = defaultdict(list)
    holes = []

    def add(kind_, o, layers, geos, ref=None, num=None, override=None):
        rec = {"kind": kind_, "obj": o, "net_code": o.GetNetCode(), "net": o.GetNetname(), "classes": classes_of(o),
               "ref": ref, "num": num, "uuid": o.m_Uuid.AsString(), "override": override, "layers": set(layers)}
        objs.append(rec)
        for L, g in geos.items():
            per_layer[L].append((len(objs) - 1, g))
        return rec

    for t in b.GetTracks():
        lays = list(t.GetLayerSet().CuStack())
        if t.Type() == pcbnew.PCB_VIA_T:
            c = Point(P(t.GetPosition()))
            add("Via", t, lays, {L: c.buffer(mm(t.GetWidth(L)) / 2) for L in lays if t.FlashLayer(L)})
            holes.append((len(objs) - 1, c.buffer(mm(t.GetDrillValue()) / 2), t.GetEffectiveHoleShape()))
        else:
            line = _arc_line(t) if t.Type() == pcbnew.PCB_ARC_T else LineString([P(t.GetStart()), P(t.GetEnd())])
            add("Track", t, lays, {t.GetLayer(): line.buffer(mm(t.GetWidth()) / 2)})
    for fp in b.GetFootprints():
        for p in fp.Pads():
            lays = list(p.GetLayerSet().CuStack())
            geos = {L: to_shapely(p.GetEffectivePolygon(L)) for L in lays if p.FlashLayer(L)}
            add("Pad", p, lays, geos, fp.GetReference(), p.GetNumber(), p.GetClearanceOverrides(None))
            if p.GetDrillSize().x > 0:
                r = mm(min(p.GetDrillSize().x, p.GetDrillSize().y)) / 2
                holes.append((len(objs) - 1, Point(P(p.GetPosition())).buffer(r), p.GetEffectiveHoleShape()))
    for rec in objs:
        rec["proxy"] = _RuleItem(rules, rec["kind"], rec["net_code"], rec["net"], rec["classes"], None, rec["ref"],
                                 None, rec["layers"])
    trees = {L: STRtree([g for _, g in lst]) for L, lst in per_layer.items()}
    hole_tree = STRtree([g for _, g, _ in holes]) if holes else None
    fills, keepouts = defaultdict(list), defaultdict(list)
    for z in b.Zones():
        for L in z.GetLayerSet().CuStack():
            if z.GetIsRuleArea():
                if z.GetDoNotAllowTracks():
                    keepouts[L].append((z.GetZoneName(), to_shapely(z.Outline())))
            elif z.HasFilledPolysForLayer(L):
                g = to_shapely(z.GetFilledPolysList(L))
                if not g.is_empty:
                    zc = z.GetLocalClearance()
                    fills[L].append((z, g, mm(zc) if zc is not None else 0.0,
                                     _RuleItem(rules, "Zone", z.GetNetCode(), z.GetNetname(), classes_of(z), L, None,
                                               g, set(z.GetLayerSet().CuStack()))))
    edges = _edge_lines(b)
    edge_geo = unary_union(edges) if edges else None
    reach = max([rules.max_rule, rules.hole_clear, rules.edge_clear]
                + [rules.nc_clearance(r["classes"]) for r in objs]
                + [zc for lst in fills.values() for _, _, zc, _ in lst]) + 0.05

    def short(rec):
        d = {"kind": rec["kind"].lower(), "net": rec["net"], "uuid": rec["uuid"]}
        if rec["ref"] is not None:
            d["pad"] = f"{rec['ref']}.{rec['num']}"
        return d

    out = []
    for site, idx, fars in sites:
        chain = [tracks[i] for i in idx]
        t0 = chain[1]
        net, L = t0["net"], t0["layer"]
        net_code = t0["obj"].GetNetCode()
        cls = classes_of(t0["obj"])
        w = max(t["w"] for t in chain)
        chain_ids = {t["obj"].m_Uuid.AsString() for t in chain}
        chain_uuids = [t["obj"].m_Uuid.AsString() for t in chain]
        old_cu = unary_union([t["cu"] for t in chain])
        a, e = fars
        paths = [("straight", [a, e])]
        dx, dy = e[0] - a[0], e[1] - a[1]
        s = min(abs(dx), abs(dy))
        sx, sy = (1 if dx >= 0 else -1), (1 if dy >= 0 else -1)
        for name, c in (("45-start", (a[0] + sx * s, a[1] + sy * s)), ("45-end", (e[0] - sx * s, e[1] - sy * s))):
            c = (round(c[0], 6), round(c[1], 6))
            path = [a, c, e]
            if math.dist(c, a) > 1e-6 and math.dist(c, e) > 1e-6 and path not in [x[1] for x in paths]:
                paths.append((name, path))
        protected = []
        hit_cls = sorted(set(cls) & JOG_PROTECTED_CLASSES)
        if hit_cls:
            protected.append("protected netclass " + ",".join(hit_cls))
        if JOG_PROTECTED_NET_RE.match(net):
            protected.append("Kelvin / metering net")
        if net in JOG_PROTECTED_NETS:
            protected.append("protected rail lane")
        if len({round(t["w"], 6) for t in chain}) != 1:
            protected.append("width-transition chain")
        # same-net contacts of the original chain (native shapes), excluding the chain itself
        old_contacts, centres = {}, {}
        for j in (trees[L].query(old_cu.buffer(0.01)) if L in trees else []):
            k, g = per_layer[L][j]
            rec = objs[k]
            if rec["net_code"] != net_code or rec["uuid"] in chain_ids:
                continue
            sh = rec["obj"].GetEffectiveShape(L)
            if any(t["obj"].GetEffectiveShape(L).Collide(sh, 0) for t in chain):
                old_contacts[k] = sh
                if rec["kind"] == "Pad":
                    pc = Point(P(rec["obj"].GetPosition()))
                    if any(t["line"].distance(pc) <= t["w"] / 2 + 1e-6 for t in chain):
                        centres[k] = pc
        cands = []
        for name, path in paths:
            segs = []
            for p0, p1 in zip(path, path[1:]):
                nt = pcbnew.PCB_TRACK(b)
                nt.SetStart(V(p0))
                nt.SetEnd(V(p1))
                nt.SetWidth(pcbnew.FromMM(w))
                nt.SetLayer(L)
                segs.append(nt)
            shapes = [x.GetEffectiveShape(L) for x in segs]
            line = LineString(path)
            new_cu = line.buffer(w / 2)
            new_px = _RuleItem(rules, "Track", net_code, net, cls, L, None, new_cu, {L})
            saving = sum(t["len"] for t in chain) - line.length
            hard, cuts, lost, gained, rule_v = [], [], [], [], []
            margin = None
            for j in (trees[L].query(new_cu.buffer(reach)) if L in trees else []):
                k, g = per_layer[L][j]
                rec = objs[k]
                if rec["uuid"] in chain_ids:
                    continue
                if rec["net_code"] == net_code:
                    if k not in old_contacts and any(sh.Collide(rec["obj"].GetEffectiveShape(L), 0) for sh in shapes):
                        gained.append(short(rec))
                    continue
                rec["proxy"].layer = L
                rec["proxy"]._geo = g
                req, src = rules.clearance(new_px, rec["proxy"], L,
                                           override=[mm(x) for x in (rec["override"],) if x is not None])
                d = g.distance(line) - w / 2
                if margin is None or d - req < margin[0]:
                    margin = (round(d - req, 5), short(rec))
                osh = rec["obj"].GetEffectiveShape(L)
                clr = pcbnew.FromMM(req) - eps_iu
                if clr > 0 and any(sh.Collide(osh, clr) for sh in shapes):
                    hard.append({**short(rec), "required_mm": round(req, 4), "rule": src, "actual_mm": round(d, 4)})
            for k, sh in old_contacts.items():
                if not any(x.Collide(sh, 0) for x in shapes):
                    lost.append(short(objs[k]))
                elif k in centres and line.distance(centres[k]) > w / 2 + 1e-6:
                    lost.append({**short(objs[k]), "centre_landing_lost": True})
            if hole_tree is not None:
                for j in hole_tree.query(new_cu.buffer(rules.hole_clear + 0.05)):
                    k, hg, hs = holes[j]
                    rec = objs[k]
                    if rec["net_code"] == net_code and net_code > 0:
                        continue
                    clr = pcbnew.FromMM(rules.hole_clear) - eps_iu
                    if any(sh.Collide(hs, clr) for sh in shapes):
                        hard.append({**short(rec), "hole": True, "required_mm": rules.hole_clear,
                                     "actual_mm": round(hg.distance(line) - w / 2, 4)})
            if edge_geo is not None:
                d = edge_geo.distance(line) - w / 2
                if d < rules.edge_clear - mm(eps_iu):
                    hard.append({"kind": "board edge", "required_mm": rules.edge_clear, "actual_mm": round(d, 4)})
            added = new_cu.difference(old_cu.buffer(1e-6))
            for zname, poly in keepouts.get(L, ()):
                ar = added.intersection(poly).area
                if ar > JOG_KEEPOUT_MM2:
                    rule_v.append({"kind": "rule area no-tracks", "area": zname, "added_mm2": round(ar, 6)})
            rule_v += rules.single(new_px, L, w)
            for z, g, zc, zpx in fills.get(L, ()):
                if z.GetNetCode() == net_code and net_code > 0:
                    continue
                if g.distance(new_cu) > reach:
                    continue
                req, src = rules.clearance(new_px, zpx, L, zone_clear=zc)
                ar = line.buffer(w / 2 + req).intersection(g).area
                if ar > JOG_PLANE_CUT_MM2:
                    cuts.append({"zone_net": z.GetNetname(), "zone": z.GetZoneName() or None,
                                 "zone_uuid": z.m_Uuid.AsString(), "required_mm": round(req, 4), "rule": src,
                                 "new_cut_mm2": round(ar, 5)})
            cands.append({"type": name, "path": [list(p) for p in path], "width_mm": w, "saving_mm": round(saving, 6),
                          "hard": hard, "plane_cuts": cuts, "lost_contacts": lost, "rule_violations": rule_v,
                          "gained_contacts": gained, "min_hard_margin_mm": margin[0] if margin else None,
                          "limiting": margin[1] if margin else None})
        ok = [c for c in cands if c["saving_mm"] > JOG_SAVE_MM
              and not (c["hard"] or c["plane_cuts"] or c["lost_contacts"] or c["rule_violations"])]
        geo_ok = [c for c in cands if c["saving_mm"] > JOG_SAVE_MM
                  and not (c["hard"] or c["lost_contacts"] or c["rule_violations"])]
        if ok and not protected:
            # preference order (stable: max() picks the same first); jog_quality() takes the first one that adds or
            # worsens no qa_layout_quality finding
            ranked = sorted(ok, key=lambda c: (c["saving_mm"], c["min_hard_margin_mm"] or 0), reverse=True)
            best = ranked[0]
            out.append({"status": "FAIL", "shortcut": {**best, "chain_uuids": chain_uuids, "layer": lname(L),
                                                      "net": net},
                        "clean": [{**c, "chain_uuids": chain_uuids, "layer": lname(L), "net": net} for c in ranked],
                        "candidates": [{k: (v[:6] if isinstance(v, list) and k != "path" else v) for k, v in c.items()}
                                       for c in cands]})
            continue
        if protected:
            st, why = "PROTECTED", "; ".join(protected) + ("; a clean shortcut exists" if ok else "")
        elif geo_ok:
            st, why = "PLANE_CUT", "every contact-preserving, clearance-clean shortcut cuts a foreign stored fill"
        elif not any(c["saving_mm"] > JOG_SAVE_MM for c in cands):
            st, why = "NO_SAVING", "no tested shortcut is shorter"
        else:
            st, why = "BLOCKED", "every shorter shortcut breaks a clearance / keep-out / rule or loses a contact"
        out.append({"status": st, "reason": why, "protected": protected, "chain_uuids": chain_uuids,
                    "clean_shortcut": bool(ok),
                    "candidates": [{k: (v[:6] if isinstance(v, list) and k != "path" else v) for k, v in c.items()}
                                   for c in cands]})
    return out


# TRACK-JOG layout-quality screen (owner option a, 2026-10-09): a shortcut is CLEAN only if it adds no new
# qa_layout_quality finding and worsens no existing one. The findings come from qa_layout_quality itself (its Board and
# RUN check functions, its constants), never a copy. JOG_LQ_SCHEMA only says how two findings of one check are compared:
# check -> (identity fields, {metric: +1 larger is worse | -1 smaller is worse | "set" | "cases"}, ignored fields).
# A changed finding with a field outside the schema, a check without a schema, or any evaluation error is UNEVALUATED,
# which leaves the shortcut CLEAN (the site FAILs): only a demonstrated new / worsened finding excuses a jog.
# Only findings that name the shortcut's net are compared (jog_lq_nets): every qa_layout_quality check reads the tracks
# of the finding's own net(s) only, so a change confined to one net cannot alter another net's finding, while the
# STRtree / list order a removed and added track perturbs can (NECK-SMALLPAD reports the first failing track found).
# Dropping a finding can only make a shortcut look cleaner, never excuse it. An "at" identity matches within
# JOG_LQ_AT_TOL_MM (a joint is reported at its first arm's end; ends within half a width are one joint).
JOG_LQ_AT_TOL_MM = 0.25
# ("sum", lsb): a total re-rounded to lsb after every term (PLANE-SLOT len_mm: round(total + crossing, 2) per track) is
# not monotonic in the exact total. Each term is > the check's minimum term (qa_layout_quality.PLANE_CROSS_MM), so a
# total R holds at most k = min(scope tracks, floor(R / (min term - lsb / 2))) terms and errs by <= k x lsb / 2; a
# rise within the two totals' bound is not demonstrated (UNEVALUATED), only one beyond it is worse.
JOG_LQ_SCHEMA = {
    "VIA-INPAD": (("net", "pad", "pad_net", "layer", "at", "via_d", "pad_wh", "fp", "what"), {}, ()),
    "VIA-PADGAP": (("net", "pad", "pad_net", "layer", "at"), {"gap_mm": -1}, ()),
    "XSTACK": (("parts",), {"pad_pairs": +1}, ()),
    "TRACK-FOLD": (("net", "layer", "at", "what"), {"angle": -1, "overlap_mm": +1}, ()),
    "ACUTE": (("net", "layer", "at", "what"), {"angle": -1}, ()),             # ends: no badness order
    "THREAD": (("part", "fp", "net", "layer", "what"), {"len_mm": +1}, ("at",)),
    "POWER-PAD-CONN": (("pad", "role", "net", "layer", "at", "what", "required_mm"),
                       {"cover": -1, "spokes_mm": -1, "tracks_mm": -1}, ()),
    "VIA-CURRENT": (("net", "at", "vias", "drill"), {"need": +1, "cases": "cases"}, ()),
    "NECK-SMALLPAD": (("net", "pad", "layer", "at"), {}, ()),     # width / across: of the first failing track found
    "POUR-STITCH": (("net", "layer", "at"), {"area_mm2": +1, "vias": -1, "need": +1, "beyond_reach_mm2": +1}, ()),
    "DECAP-LOOP": (("part", "value", "pad", "net", "at", "what"), {"gnd_via_mm": +1, "path_mm": +1}, ()),
    "SERIES-TERM": (("part", "value", "nets", "at", "what"), {"path_mm": +1},
                    ("driver", "nearest_ic_pin", "straight_mm")),
    "XTAL": (("part", "net", "limit", "at", "what"), {"len_mm": +1, "vias": +1, "foreign": "set"}, ()),
    "DIFFPAIR": (("pair",), {}, ()),
    "PLANE-SLOT": (("net", "layer", "what"), {"len_mm": ("sum", 0.01)}, ("at",)),   # per-track round(.., 2) sum
    "FIDUCIAL": (("side",), {"fiducials": -1, "triangle_mm2": -1}, ()),
    "PAD-AXIS": (("pad", "net", "layer", "at"), {"angle": +1}, ()),
    "VIA-HOP": (("net", "at", "b"), {}, ()),
    "PLACE-PINPASSIVE": (("part", "pin", "net"), {}, ()),
    "PLACE-ORIENT": (("part", "kind"), {}, ()),
}
_MISSING = object()


def _lq_module():
    import qa_layout_quality                      # lazy: qa_layout_quality imports this module (QL)
    return qa_layout_quality


class _LoaderView:
    """pcbnew as qa_layout_quality's Board constructor sees it, LoadBoard returning an in-memory board"""

    def __init__(self, board):
        self._board = board

    def LoadBoard(self, path):
        return self._board

    def __getattr__(self, k):
        return getattr(pcbnew, k)


def _lq_json(x):
    return json.loads(json.dumps(x, default=str))


def _lq_key(x):
    return json.dumps(x, sort_keys=True, default=str)


def _lq_num(v):
    return math.inf if v is None else v


def _lq_sum_terms(total, n, min_term, lsb):
    k = n if n is not None else math.inf
    if min_term:
        k = min(k, math.floor(total / (min_term - lsb / 2) + 1e-9))
    return k


def _lq_compare(f, g, spec, sums=None):
    """candidate finding f vs baseline finding g of one identity -> (worse {field: delta}, unknown [field]).
    sums: {"min_term": x, "terms": (baseline scope tracks, candidate scope tracks)} for a ("sum", lsb) metric."""
    ident, metrics, ignored = spec
    worse, unknown = {}, []
    for k in sorted(set(f) | set(g)):
        if k in ident or k in ignored:
            continue
        a, b = g.get(k, _MISSING), f.get(k, _MISSING)
        if a == b:
            continue
        d = metrics.get(k)
        if d is None or a is _MISSING or b is _MISSING:
            unknown.append(k)
        elif d == "set":                                        # {net: [layers]}: any added pair is worse
            if not (isinstance(a, dict) and isinstance(b, dict)):
                unknown.append(k)
                continue
            pa = {(n, x) for n, v in a.items() for x in v}
            add = sorted(f"{n} {x}" for n, v in b.items() for x in v if (n, x) not in pa)
            if add:
                worse[k] = {"added": add}
        elif d == "cases":                                      # VIA-CURRENT cases: amps / need per case
            ca = {c.get("case"): c for c in a} if isinstance(a, list) else None
            cb_ = {c.get("case"): c for c in b} if isinstance(b, list) else None
            if ca is None or cb_ is None:
                unknown.append(k)
                continue
            for name, c in cb_.items():
                o = ca.get(name)
                if o is None:
                    worse[f"{k}.{name}"] = {"added": c}
                    continue
                for m in sorted(set(c) | set(o)):
                    if c.get(m) == o.get(m) or m == "case":
                        continue
                    if m in ("amps", "need") and isinstance(c.get(m), (int, float)) \
                            and isinstance(o.get(m), (int, float)):
                        if c[m] > o[m] + 1e-9:
                            worse[f"{k}.{name}.{m}"] = [o[m], c[m]]
                    else:
                        unknown.append(f"{k}.{name}.{m}")
        elif isinstance(d, tuple) and d[0] == "sum":
            if not (isinstance(a, (int, float)) and isinstance(b, (int, float))):
                unknown.append(k)
                continue
            if b - a <= 1e-9:
                continue                                  # not higher: never a demonstrated worsening
            if not sums:
                unknown.append(f"{k} (+{round(b - a, 6)}: a re-rounded sum without a term bound)")
                continue
            lsb, (nb, nc) = d[1], sums["terms"]
            tol = lsb / 2 * (_lq_sum_terms(a, nb, sums.get("min_term"), lsb)
                             + _lq_sum_terms(b, nc, sums.get("min_term"), lsb))
            if b - a > tol + 1e-9:
                worse[k] = [a, b]
            else:
                unknown.append(f"{k} (+{round(b - a, 6)} within the rounding bound {round(tol, 6)})")
        else:
            va, vb = _lq_num(a), _lq_num(b)
            if not (isinstance(va, (int, float)) and isinstance(vb, (int, float))):
                unknown.append(k)
            elif (vb - va) * d > 1e-9:
                worse[k] = [a, b]
    return worse, unknown


def jog_lq_nets(f):
    """the nets a qa_layout_quality finding names"""
    nets = {f.get("net"), f.get("pad_net")}
    for k in ("nets", "pair"):
        if isinstance(f.get(k), list):
            nets |= set(f[k])
    if isinstance(f.get("foreign"), dict):
        nets |= set(f["foreign"])
    return nets - {None}


def _lq_at_close(f, g):
    a, b = f.get("at"), g.get("at")
    if a is None or b is None:
        return a is None and b is None
    try:
        return math.dist(a, b) <= JOG_LQ_AT_TOL_MM
    except (TypeError, ValueError):
        return a == b


def jog_lq_delta(base, cand, net=None, schema=None, sums=None):
    """qa_layout_quality findings {check: [finding]} of the unmodified board (base) and of the board with the shortcut
    (cand) -> {"status": CLEAN | DIRTY (a new or worsened finding) | UNEVALUATED, "new", "worsened", "unevaluable"}.
    Unchanged findings (equal apart from track UUIDs) and removed / improved ones never count. net: compare only the
    findings naming it (see JOG_LQ_SCHEMA). sums: {check: _lq_compare sums} for ("sum", lsb) metrics."""
    schema = JOG_LQ_SCHEMA if schema is None else schema
    if net is not None:
        base = {c: [f for f in lst if net in jog_lq_nets(f)] for c, lst in base.items()}
        cand = {c: [f for f in lst if net in jog_lq_nets(f)] for c, lst in cand.items()}
    out = {"new": [], "worsened": [], "unevaluable": []}
    for chk in sorted(set(base) | set(cand)):
        pool = defaultdict(int)
        for g in base.get(chk, []):
            pool[_lq_key(g)] += 1
        rest_c = []
        for f in cand.get(chk, []):
            k = _lq_key(f)
            if pool[k] > 0:
                pool[k] -= 1
            else:
                rest_c.append(f)
        if not rest_c:
            continue
        left_b = []
        for g in base.get(chk, []):
            k = _lq_key(g)
            if pool[k] > 0:
                pool[k] -= 1
                left_b.append(g)
        spec = schema.get(chk)
        if spec is None:
            out["unevaluable"] += [{"check": chk, "finding": f, "why": "no comparison schema"} for f in rest_c]
            continue
        ident = spec[0]
        fuzzy = "at" in ident
        gb, gc = defaultdict(list), defaultdict(list)
        for g in left_b:
            gb[_lq_key([g.get(x) for x in ident if x != "at"])].append(g)
        for f in rest_c:
            gc[_lq_key([f.get(x) for x in ident if x != "at"])].append(f)
        for k, fs in gc.items():
            gs = gb.get(k, [])
            if len(fs) > len(gs):                         # more findings of this identity than before: new
                out["new"] += [{"check": chk, "finding": f, "baseline_same_identity": gs} for f in fs]
                continue
            for f in fs:
                near = [g for g in gs if not fuzzy or _lq_at_close(f, g)]
                if not near:
                    out["new"].append({"check": chk, "finding": f, "baseline_same_identity": gs})
                    continue
                res = [(g,) + _lq_compare(f, g, spec, (sums or {}).get(chk)) for g in near]
                if any(not w and not u for _, w, u in res):
                    continue                              # no worse than a baseline counterpart (improved)
                hit = next(((g, w) for g, w, u in res if w and not u), None)
                if hit:
                    out["worsened"].append({"check": chk, "finding": f, "baseline": hit[0], "delta": hit[1]})
                else:
                    out["unevaluable"].append({"check": chk, "finding": f, "baseline": near,
                                               "why": "changed fields not comparable (outside the schema / within "
                                                      "rounding): " + ",".join(sorted({x for _, _, u in res for x in u}))})
    out["status"] = "DIRTY" if out["new"] or out["worsened"] else ("UNEVALUATED" if out["unevaluable"] else "CLEAN")
    return out


class JogQuality:
    """qa_layout_quality's own findings on the board and on in-memory copies with one jog chain replaced. Every
    check runs on the whole board, except PLANE-SLOT (by far the slowest): its findings are per (net, layer) sums of
    per-track crossings of fill-derived voids, and a shortcut changes the tracks of exactly one (net, layer), so it runs on
    that (net, layer)'s tracks only, for the baseline and the candidate alike (the other aggregates are unchanged), in
    the baseline order with the new segments in the chain's place."""

    def __init__(self, pcb):
        self.pcb = str(pcb)
        self.LQ = _lq_module()
        if self.LQ.pcbnew is not pcbnew:
            raise RuntimeError("qa_layout_quality does not use this pcbnew module")
        if [k for k, fn in self.LQ.RUN.items() if fn is self.LQ.RUN["PLANE-SLOT"]] != ["PLANE-SLOT"]:
            raise RuntimeError("qa_layout_quality PLANE-SLOT shares its check function: scope restriction invalid")
        self.B0 = self._board(pcbnew.LoadBoard(self.pcb))
        self.base = self._run(self.B0, None)
        self.base_ps = {}

    def _board(self, b):
        LQ = self.LQ
        LQ.pcbnew = _LoaderView(b)
        try:
            return LQ.Board(self.pcb)
        finally:
            LQ.pcbnew = pcbnew

    def _run(self, B, scope, tracks=None):
        """scope None: every check but PLANE-SLOT; scope (net, layer name): PLANE-SLOT on those tracks only (tracks: the
        same tracks in an explicit order; its crossing sum is rounded per track, so the order is kept canonical)"""
        LQ = self.LQ
        fails = {k: [] for k in LQ.CHECKS}
        info = {}
        if scope is None:
            done = {LQ.RUN["PLANE-SLOT"]}
            for c in LQ.CHECKS:
                if LQ.RUN[c] not in done:
                    done.add(LQ.RUN[c])
                    LQ.RUN[c](B, fails, info)
            fails.pop("PLANE-SLOT")
        else:
            view = copy.copy(B)
            view.tracks = [t for t in B.tracks if (t["net"], B.lname(t["layer"])) == scope] if tracks is None else tracks
            LQ.RUN["PLANE-SLOT"](view, fails, info)
            if any((f.get("net"), f.get("layer")) != scope for f in fails["PLANE-SLOT"]):
                raise RuntimeError("PLANE-SLOT finding outside its (net, layer) scope")
            fails = {"PLANE-SLOT": fails["PLANE-SLOT"]}
        return {c: [_lq_json({k: v for k, v in f.items() if k != "uuids"}) for f in lst] for c, lst in fails.items()}

    def evaluate(self, c):
        """c: a clearance-clean shortcut (path, width_mm, chain_uuids, layer, net) -> jog_lq_delta() record"""
        scope = (c["net"], c["layer"])
        if scope not in self.base_ps:
            self.base_ps[scope] = self._run(self.B0, scope)
        n_base = sum((t["net"], self.B0.lname(t["layer"])) == scope for t in self.B0.tracks)
        b = pcbnew.LoadBoard(self.pcb)                # a fresh copy: untouched tracks keep their order
        want = set(c["chain_uuids"])
        chain = [t for t in b.GetTracks() if t.m_Uuid.AsString() in want]
        if len(chain) != len(want) or any(t.GetNetname() != c["net"] for t in chain):
            raise RuntimeError("jog chain not found on the board copy")
        L = b.GetLayerID(c["layer"])
        ni = chain[0].GetNet()
        new_ids = []
        for t in chain:
            b.Remove(t)
            t.thisown = False                         # detached and leaked on purpose: freeing it corrupts the copy
        for p0, p1 in zip(c["path"], c["path"][1:]):
            nt = pcbnew.PCB_TRACK(b)
            nt.SetStart(V(p0))
            nt.SetEnd(V(p1))
            nt.SetWidth(pcbnew.FromMM(c["width_mm"]))
            nt.SetLayer(L)
            nt.SetNet(ni)
            b.Add(nt)
            nt.thisown = False                        # the board owns it now (a Python-side delete would free it twice)
            new_ids.append(nt.m_Uuid.AsString())
        B = self._board(b)
        # PLANE-SLOT tracks in the baseline order, the new segments where the chain was
        mine = {t["obj"].m_Uuid.AsString(): t for t in B.tracks if (t["net"], B.lname(t["layer"])) == scope}
        seq, placed = [], False
        for t in self.B0.tracks:
            if (t["net"], self.B0.lname(t["layer"])) != scope:
                continue
            u = t["obj"].m_Uuid.AsString()
            if u in want:
                if not placed:
                    seq += [mine[x] for x in new_ids]
                    placed = True
                continue
            seq.append(mine[u])
        if len(seq) != len(mine):
            raise RuntimeError("PLANE-SLOT scope order does not cover the candidate's tracks")
        cand = {**self._run(B, None), **self._run(B, scope, seq)}
        res = jog_lq_delta({**self.base, **self.base_ps[scope]}, cand, net=c["net"],
                           sums={"PLANE-SLOT": {"min_term": self.LQ.PLANE_CROSS_MM, "terms": (n_base, len(seq))}})
        res["plane_slot_scope"] = list(scope)
        return res


def _lq_brief(ev):
    """one line per new / worsened finding"""
    out = []
    for x in ev.get("new", []):
        f = x["finding"]
        out.append(f"new {x['check']} " + " ".join(f"{k}={f[k]}" for k in ("pad", "part", "net", "layer", "at",
                                                                       "angle", "len_mm", "path_mm", "what") if k in f))
    for x in ev.get("worsened", []):
        f = x["finding"]
        out.append(f"worse {x['check']} " + " ".join(f"{k}={f[k]}" for k in ("pad", "part", "net", "layer", "what")
                                                       if k in f) + f" {json.dumps(x['delta'], default=str)}")
    return out


def jog_quality(pcb, screen):
    """owner option (a): re-screen every clearance-clean (FAIL) site against qa_layout_quality. The first ranked shortcut
    that is CLEAN or UNEVALUATED stays the FAIL's shortcut; a site whose every one is DIRTY becomes LAYOUT_QUALITY."""
    try:
        jq, err = JogQuality(pcb), None
    except Exception as e:                                # fail closed: nothing excused
        jq, err = None, f"baseline: {e!r}"[:400]
    for res in screen:
        if res["status"] != "FAIL":
            continue
        tried, chosen = [], None
        for c in res.pop("clean"):
            if jq is None:
                ev = {"status": "UNEVALUATED", "error": err}
            else:
                try:
                    ev = jq.evaluate(c)
                except Exception as e:
                    ev = {"status": "UNEVALUATED", "error": repr(e)[:400]}
            tried.append({"type": c["type"], "path": c["path"], "layout_quality": ev})
            if ev["status"] != "DIRTY":
                chosen = {**c, "layout_quality": ev}
                break
        if chosen is not None:
            res["shortcut"] = chosen
            res["layout_quality_tried"] = tried
            continue
        lines = [f"{t['type']}: " + "; ".join(_lq_brief(t["layout_quality"])) for t in tried]
        res.update(status="LAYOUT_QUALITY", protected=[], chain_uuids=res["shortcut"]["chain_uuids"],
                   reason="every clearance-clean shortcut adds or worsens a qa_layout_quality finding: "
                          + " | ".join(lines),
                   layout_quality=tried)
        res.pop("shortcut")
    return screen


# ---------------------------------------------------------------- TRACK-WIDTH foreign-object neck (LVW-NECKS-20261009)
def neck_rise_1d(i_a, length_mm, width_mm, cu_um, anchored=True):
    """1-D conduction bound (no lateral loss: conservative) of a conductor's rise above its end copper, K:
    I^2 rho L^2 / (c k A^2), c = 8 with both ends held by full-width copper, 2 with an end not held."""
    rho = CU_RHO20 * (1 + CU_ALPHA * (NECK_CU_T_C - 20.0))
    a = width_mm * 1e-3 * cu_um * 1e-6
    return i_a ** 2 * rho * (length_mm * 1e-3) ** 2 / ((8.0 if anchored else 2.0) * CU_K * a * a)


def ipc_rise_k(i_a, width_mm, cu_um):
    """rise (K) at which the gate's IPC-2152 fit (current_budget.ipc2152_width_mm) needs exactly width_mm: evidence only"""
    if i_a <= 0 or width_mm <= 0:
        return 0.0
    lo, hi = 1e-3, 1e4
    if cb.ipc2152_width_mm(i_a, hi, cu_um) > width_mm:
        return float("inf")
    for _ in range(200):
        m = math.sqrt(lo * hi)
        if cb.ipc2152_width_mm(i_a, m, cu_um) > width_mm:
            lo = m
        else:
            hi = m
    return hi


class NeckBlockers:
    """TRACK-WIDTH (d): the FOREIGN objects a piece would hit at its required width. The piece is re-drawn natively at
    the required width on its own centreline (round ends, same layer / net); a foreign track / arc / via / pad (any other
    net, net 0 included) blocks it when the native shapes Collide within the required clearance (JogRules: board DRU +
    netclass pair model, local overrides, board minimum) + the board DRC epsilon; a foreign or non-plated hole blocks it
    within the board hole clearance + epsilon. Zone fills are not blockers (a fill yields to the track), nor are the
    board edge or rule areas (not foreign objects). An unmodelled DRU construct raises (fail closed)."""

    def __init__(self, b, pcb):
        self.b = b
        self.rules = JogRules(b, pcb)
        self.eps_iu = b.GetDesignSettings().GetDRCEpsilon()
        self.objs, self.per_layer, self.holes = [], defaultdict(list), []

        def classes_of(item):
            return tuple(x for x in item.GetNetClassName().split(",") if x) or ("Default",)

        def add(kind_, o, layers, geos, ref=None, num=None, override=None):
            rec = {"kind": kind_, "obj": o, "net_code": o.GetNetCode(), "net": o.GetNetname(), "classes": classes_of(o),
                   "ref": ref, "num": num, "uuid": o.m_Uuid.AsString(), "override": override}
            rec["proxy"] = _RuleItem(self.rules, kind_, rec["net_code"], rec["net"], rec["classes"], None, ref, None,
                                     set(layers))
            self.objs.append(rec)
            for L, g in geos.items():
                self.per_layer[L].append((len(self.objs) - 1, g))
            return len(self.objs) - 1
        for t in b.GetTracks():
            lays = list(t.GetLayerSet().CuStack())
            if t.Type() == pcbnew.PCB_VIA_T:
                c = Point(P(t.GetPosition()))
                k = add("Via", t, lays, {L: c.buffer(mm(t.GetWidth(L)) / 2) for L in lays if t.FlashLayer(L)})
                self.holes.append((k, c.buffer(mm(t.GetDrillValue()) / 2), t.GetEffectiveHoleShape()))
            else:
                line = _arc_line(t) if t.Type() == pcbnew.PCB_ARC_T else LineString([P(t.GetStart()), P(t.GetEnd())])
                add("Track", t, lays, {t.GetLayer(): line.buffer(mm(t.GetWidth()) / 2)})
        for fp in b.GetFootprints():
            for p in fp.Pads():
                lays = list(p.GetLayerSet().CuStack())
                geos = {L: to_shapely(p.GetEffectivePolygon(L)) for L in lays if p.FlashLayer(L)}
                k = add("Pad", p, lays, geos, fp.GetReference(), p.GetNumber(), p.GetClearanceOverrides(None))
                if p.GetDrillSize().x > 0:
                    r = mm(min(p.GetDrillSize().x, p.GetDrillSize().y)) / 2
                    self.holes.append((k, Point(P(p.GetPosition())).buffer(r), p.GetEffectiveHoleShape()))
        self.trees = {L: STRtree([g for _, g in lst]) for L, lst in self.per_layer.items()}
        self.hole_tree = STRtree([g for _, g, _ in self.holes]) if self.holes else None
        self.reach = max([self.rules.max_rule, self.rules.hole_clear, self.rules.min_clear]
                         + [self.rules.nc_clearance(r["classes"]) for r in self.objs]) + 0.05

    def at(self, t, req):
        """blocking foreign objects of track record t (qa_copper_landing track dict) at width req (mm)"""
        o, L = t["obj"], t["layer"]
        full = pcbnew.PCB_ARC(self.b) if o.Type() == pcbnew.PCB_ARC_T else pcbnew.PCB_TRACK(self.b)
        full.SetStart(o.GetStart())
        if o.Type() == pcbnew.PCB_ARC_T:
            full.SetMid(o.GetMid())
        full.SetEnd(o.GetEnd())
        full.SetWidth(pcbnew.FromMM(req))
        full.SetLayer(L)
        sh = full.GetEffectiveShape(L)
        net_code = o.GetNetCode()
        cls = tuple(x for x in o.GetNetClassName().split(",") if x) or ("Default",)
        line = t["line"]
        full_cu = line.buffer(req / 2)
        new_px = _RuleItem(self.rules, "Track", net_code, t["net"], cls, L, None, full_cu, {L})
        out = []
        for j in (self.trees[L].query(full_cu.buffer(self.reach)) if L in self.trees else []):
            k, g = self.per_layer[L][j]
            rec = self.objs[k]
            if rec["net_code"] == net_code and net_code > 0:
                continue
            rec["proxy"].layer = L
            rec["proxy"]._geo = g
            clr, src = self.rules.clearance(new_px, rec["proxy"], L,
                                            override=[mm(x) for x in (rec["override"],) if x is not None])
            if sh.Collide(rec["obj"].GetEffectiveShape(L), pcbnew.FromMM(clr) + self.eps_iu):
                d = g.distance(line)
                out.append({"kind": rec["kind"].lower(), "net": rec["net"], "uuid": rec["uuid"],
                            **({"pad": f"{rec['ref']}.{rec['num']}"} if rec["ref"] is not None else {}),
                            "required_mm": round(clr, 4), "rule": src,
                            "gap_at_required_mm": round(d - req / 2, 4), "gap_at_neck_mm": round(d - t["w"] / 2, 4)})
        if self.hole_tree is not None:
            hc = self.rules.hole_clear
            for j in self.hole_tree.query(full_cu.buffer(hc + 0.05)):
                k, hg, hs = self.holes[j]
                rec = self.objs[k]
                if rec["net_code"] == net_code and net_code > 0:
                    continue
                if hc > 0 and sh.Collide(hs, pcbnew.FromMM(hc) + self.eps_iu):
                    d = hg.distance(line)
                    out.append({"kind": rec["kind"].lower() + " hole", "net": rec["net"], "uuid": rec["uuid"],
                                "required_mm": round(hc, 4), "rule": "hole clearance",
                                "gap_at_required_mm": round(d - req / 2, 4), "gap_at_neck_mm": round(d - t["w"] / 2, 4)})
        return sorted(out, key=lambda x: (x["gap_at_required_mm"] - x["required_mm"], x["uuid"]))


def neck_runs(tracks, narrow):
    """NECK RUNS of the below-required pieces narrow ({track idx: required mm}): pieces of one net and layer whose
    copper touches at an end (an end within the other's copper) form one run (union-find). -> {idx: run id}"""
    par = {i: i for i in narrow}

    def find(x):
        while par[x] != x:
            par[x] = par[par[x]]
            x = par[x]
        return x
    idx = sorted(narrow)
    tree = STRtree([tracks[i]["cu"] for i in idx]) if idx else None
    for i in idx:
        t = tracks[i]
        for q in (t["a"], t["e"]):
            for j in tree.query(Point(q)):
                k = idx[j]
                o = tracks[k]
                if k != i and o["net"] == t["net"] and o["layer"] == t["layer"] and \
                        o["line"].distance(Point(q)) <= o["w"] / 2 + 1e-6:
                    par[find(i)] = find(k)
    return {i: find(i) for i in idx}


class UF:
    def __init__(self):
        self.p = {}

    def find(self, x):
        self.p.setdefault(x, x)
        while self.p[x] != x:
            self.p[x] = self.p[self.p[x]]
            x = self.p[x]
        return x

    def union(self, a, c):
        self.p[self.find(a)] = self.find(c)


def reach_far(isl, links):
    """The part of an outer fill fragment isl farther than STITCH_REACH_MM from every plane link in links ((x, y) of
    plane-reaching vias / plated holes). Shared by VIA-BARE's reach keep rule and by stitch-via placement (the B8.1
    cleanup: placement and pruning must evaluate reach the same way, or they churn)."""
    return isl.difference(unary_union([Point(q).buffer(STITCH_REACH_MM, 16) for q in links])) if links else isl


def reach_lost(isl, others, q):
    """Area of isl that only a plane link at q reaches within STITCH_REACH_MM, given the other links: VIA-BARE keeps a
    pour-only via when this exceeds STITCH_REACH_TOL_MM2."""
    return reach_far(isl, others).intersection(Point(q).buffer(STITCH_REACH_MM, 16)).area


LEAF_PREFIXES = ("R", "C")        # budget-path: pads of these two-terminal parts draw no rail current (pull-up /
                                 # bias resistors, decoupling caps): a branch that serves only them is a leaf


def _net_graph(net, idx, tracks, vias, v_geo, all_pads, pad_poly, fill):
    """one net's copper graph (budget_leaf_tracks / budget_branch_tracks): nodes are joints (track ends joined where they
    touch, split where a track end lands mid-segment), each pad, each via and the net's fills as one node; edges are the
    track pieces. Returns (edges [(u, v, track i)], load nodes, {node: {part refs}}, fill node or None)."""
    from collections import defaultdict as _dd
    import re as _re
    par = {}

    def find(x):
        par.setdefault(x, x)
        while par[x] != x:
            par[x] = par[par[x]]
            x = par[x]
        return x

    def union(x, y):
        par[find(x)] = find(y)
    ends = [(i, k, tracks[i][k]) for i in idx for k in ("a", "e")]
    ept = STRtree([Point(q) for _, _, q in ends])
    splits = _dd(list)                                  # track i -> [(param, node)] mid-segment landings
    joins = []                                          # (distance, end node, joint end node) end-on-copper contacts
    for i in idx:
        t = tracks[i]
        for k2 in ept.query(t["cu"]):
            j, kk, q = ends[k2]
            if j == i or tracks[j]["layer"] != t["layer"]:
                continue
            d = t["line"].distance(Point(q))
            if d > max(t["w"], tracks[j]["w"]) / 2 + 1e-3:
                continue
            pa = t["line"].project(Point(q))
            if pa <= 1e-3:
                joins.append((round(d, 6), ("j", j, kk), ("j", i, "a")))
            elif pa >= t["line"].length - 1e-3:
                joins.append((round(d, 6), ("j", j, kk), ("j", i, "e")))
            else:
                splits[i].append((pa, ("j", j, kk)))
    # Joints, closest contacts first. A contact that would put BOTH ends of one track into one joint is refused (as the
    # TRACK-END joint graph never merges a track's own two ends): a collinear piece shorter than w/2 (a neck split) has
    # its far end inside its neighbour's copper, and merging it would contract the piece to nothing, dropping it from
    # BRANCHES (budget_branch_tracks). The refused contact is parallel to that track's own edge (the track joins the same
    # two joints), so connectivity and every OTHER track's bridge / far-side test are unchanged; the kept track carries
    # at most the current across the cut it spans, which is what its classification sizes it for. Contraction through
    # a via / pad / fill node below is unchanged (a track wholly inside one keeps the net budget: fail closed).
    own = {("j", i, k): {i} for i in idx for k in ("a", "e")}
    for _, x, y in sorted(joins):
        rx, ry = find(x), find(y)
        if rx == ry or own.get(rx, set()) & own.get(ry, set()):
            continue
        par[rx] = ry
        own[ry] = own.get(rx, set()) | own.get(ry, set())
    load = set()
    zn = ("z", net)
    for vi, v in enumerate(vias):
        if v.GetNetname() != net:
            continue
        for i in idx:
            t = tracks[i]
            if not v.IsOnLayer(t["layer"]):
                continue
            for k in ("a", "e"):
                if v_geo[vi].intersects(Point(t[k])):
                    union(("j", i, k), ("v", vi))
        if any(fill(net, L)[1].intersects(v_geo[vi]) for L in v.GetLayerSet().CuStack()):
            union(("v", vi), zn)
    for pi, p in enumerate(all_pads):
        if p.GetNetname() != net:
            continue
        ref = p.GetParentFootprint().GetReference()
        m = _re.match(r"^[A-Z]+", ref)
        node = ("p", pi)
        find(node)
        if not (m and m[0] in LEAF_PREFIXES):
            load.add(node)
        for L in p.GetLayerSet().CuStack():
            pg = pad_poly(p, L)
            for i in idx:
                t = tracks[i]
                if t["layer"] != L:
                    continue
                for k in ("a", "e"):
                    if pg.distance(Point(t[k])) <= t["w"] / 2 + 1e-3:
                        union(("j", i, k), node)
            if fill(net, L)[1].intersects(pg):
                union(node, zn)
        for vi, v in enumerate(vias):
            if v.GetNetname() == net and any(v.IsOnLayer(L) and v_geo[vi].intersects(pad_poly(p, L))
                                             for L in p.GetLayerSet().CuStack()):
                union(node, ("v", vi))
    for i in idx:
        if fill(net, tracks[i]["layer"])[1].intersects(tracks[i]["cu"]):
            union(("j", i, "a"), zn)
    loads = {find(x) for x in load}
    if zn in par:
        loads.add(find(zn))
    edges = []                                          # (node u, node v, track i)
    for i in idx:
        pts = [find(("j", i, "a"))] + [find(nd) for _, nd in sorted(splits[i])] + [find(("j", i, "e"))]
        for u, v in zip(pts, pts[1:]):
            if u != v:
                edges.append((u, v, i))
    refs = _dd(set)
    for pi, p in enumerate(all_pads):
        if p.GetNetname() == net and ("p", pi) in par:
            refs[find(("p", pi))].add(p.GetParentFootprint().GetReference())
    return edges, loads, refs, (find(zn) if zn in par else None)


def budget_leaf_tracks(b, tracks, vias, v_geo, all_pads, pad_poly, fill):
    """indices of tracks on LEAF branches of their net: copper that leads only to pads of R / C parts (pull-ups,
    decoupling). The net's copper is a graph - nodes are joints (track ends joined where they touch, split where a
    track end lands mid-segment), each pad, each via and the net's fills (planes / pours) as one node; edges are the
    track pieces - and dead ends that are not a load are pruned repeatedly. Loads: pads of every other part and the
    fill node (the rail's distribution). A track is a leaf when all of its pieces were pruned."""
    from collections import defaultdict as _dd
    by_net = _dd(list)
    for i, t in enumerate(tracks):
        by_net[t["net"]].append(i)
    leaf = set()
    for net, idx in by_net.items():
        edges, loads, _, _ = _net_graph(net, idx, tracks, vias, v_geo, all_pads, pad_poly, fill)
        inc = _dd(set)
        for k, (u, v, i) in enumerate(edges):
            inc[u].add(k)
            inc[v].add(k)
        alive = set(range(len(edges)))
        stack = [n for n in inc if len(inc[n]) <= 1 and n not in loads]
        while stack:
            n = stack.pop()
            live = [k for k in inc[n] if k in alive]
            if len(live) > 1 or n in loads:
                continue
            for k in live:
                alive.discard(k)
                u, v, _ = edges[k]
                o = v if u == n else u
                if o not in loads and len([q for q in inc[o] if q in alive]) <= 1:
                    stack.append(o)
        keep = {edges[k][2] for k in alive}
        leaf |= {i for i in idx if i not in keep and any(e[2] == i for e in edges)}
    return leaf


def budget_branch_tracks(kind, tracks, vias, v_geo, all_pads, pad_poly, fill):
    """{track index: BRANCHES entry} for tracks whose far side holds only that branch's parts (current_budget.BRANCHES):
    with the track's pieces removed, its ends fall into >= 2 parts of the net's copper graph; every part but at most one
    (the supply side) must hold no fill node and only pads of the branch's parts, and at least one such part must hold
    one of them. A track in a loop (not a bridge), or one whose far side reaches another load or the net's pour, keeps
    the net budget."""
    out = {}
    for net, branches in cb.BRANCHES.get(kind, {}).items():
        idx = [i for i, t in enumerate(tracks) if t["net"] == net]
        if not idx:
            continue
        edges, _, refs, zn = _net_graph(net, idx, tracks, vias, v_geo, all_pads, pad_poly, fill)
        nodes = {n for u, v, _ in edges for n in (u, v)}
        for i in idx:
            mine = [(u, v) for u, v, j in edges if j == i]
            if not mine:
                continue
            par = {}

            def find(x):
                par.setdefault(x, x)
                while par[x] != x:
                    par[x] = par[par[x]]
                    x = par[x]
                return x
            for u, v, j in edges:
                if j != i:
                    par[find(u)] = find(v)
            sides = {find(n) for e in mine for n in e}
            if len(sides) < 2:
                continue
            members = {}
            for n in nodes:
                r = find(n)
                if r in sides:
                    members.setdefault(r, set()).add(n)
            for br in branches:
                parts = set(br["parts"])
                clean, dirty = 0, 0
                for r in sides:
                    ms = members.get(r, set())
                    rs = set().union(*(refs.get(n, set()) for n in ms))
                    if zn in ms or not rs <= parts:
                        dirty += 1
                    elif rs:
                        clean += 1
                if clean and dirty <= 1:
                    out[i] = br
                    break
        # D-LAYOUT-GATES #9a: a "pour_ok" branch also sizes a run (tracks joined end to end on one layer) whose touched
        # pads are only that branch's parts' pads and R / C leaf pads, with at least one branch part, although the pads
        # touch the net's pour (the bridge test above cannot see through the pour node)
        for br in branches:
            if not br.get("pour_ok"):
                continue
            parts = set(br["parts"])
            rp = {}

            def rfind(x):
                rp.setdefault(x, x)
                while rp[x] != x:
                    rp[x] = rp[rp[x]]
                    x = rp[x]
                return x
            for a in idx:
                for c in idx:
                    if c <= a or tracks[a]["layer"] != tracks[c]["layer"]:
                        continue
                    lim = max(tracks[a]["w"], tracks[c]["w"]) / 2 + 1e-3
                    if any(Point(tracks[a][k1]).distance(Point(tracks[c][k2])) <= lim
                           for k1 in ("a", "e") for k2 in ("a", "e")):
                        rp[rfind(a)] = rfind(c)
            comps = {}
            for a in idx:
                comps.setdefault(rfind(a), []).append(a)
            for comp in comps.values():
                rs = set()
                for p in all_pads:
                    if p.GetNetname() != net:
                        continue
                    for a in comp:
                        L = tracks[a]["layer"]
                        if p.IsOnLayer(L) and pad_poly(p, L).distance(tracks[a]["line"]) <= tracks[a]["w"] / 2 + 1e-3:
                            rs.add(p.GetParentFootprint().GetReference())
                            break
                leaf = {r for r in rs if re.match(r"^[A-Z]+", r) and re.match(r"^[A-Z]+", r)[0] in LEAF_PREFIXES}
                if rs & parts and rs <= parts | leaf:
                    for a in comp:
                        out.setdefault(a, br)
    return out
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
