mikenemat/skeeball-premium-re/(commit log)

2026-10-29 SBC-1 Skee-Ball Home Arcade Premium replacement controller (hardware)
    Initial import of the SBC-1 hardware project: KiCad 10 design-as-code scripts,
    generated schematic, routed 4-layer board (as ordered), BOM, JLC manufacturing
    record (release-2026-10-27c), design records and bring-up notes.
    Third-party datasheets, vendor 3D models, vendored Python libraries, API caches
    and router scratch runs are git-ignored (see hardware/README.md, Setup).
2026-10-29 Add ARM image-analysis tools and synthetic tests
